NikolaNikolow/ORGOfly-CAD-model/P01/P01_07_DIANA/Videos and Pictures/Tilit_rotor_simulation.png

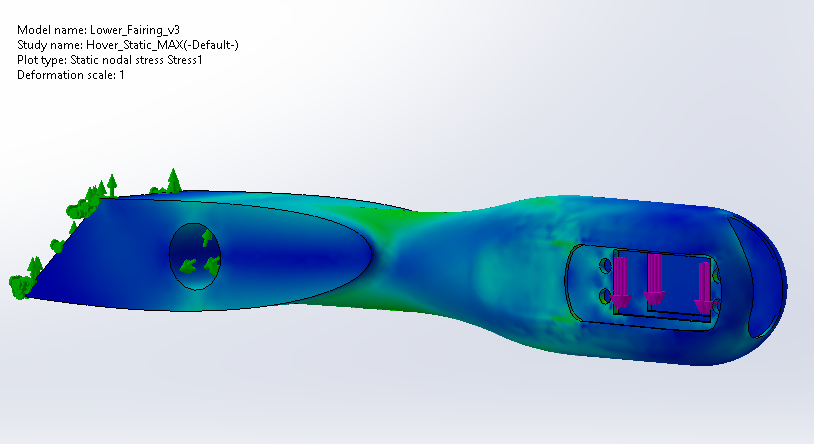
P01/P01_07_DIANA/Videos and Pictures/Tilit_rotor_simulation.png
