NikolaNikolow/ORGOfly-CAD-model/README.md

# ORGOfly-CAD-model
This will be a repo for designing the ORGOfly CAD model.
