NikolaNikolow/ORGOfly-CAD-model/Corporate/Roadmap_260813.pptx

## ORGOfly An airborne medical-logistics system

Roadmap

## Company Roadmap

L01 Large ORGOfly Aircraft program
Hybrid Propulsion System; Intercity

Q3 2028

L01 Commercial Operation

2029???

S01 Medical Logistics Demonstrator
based on P01; fully electric

Q2 2027

Pilot Medical Route
utilizing S01; only demonstration

Q3 2027

Initial ORGOfly service
2-3x S01;
commercial service

Q1 2028

Flight-test campaign
banner towing for gathering flight data and experience
Banner towing?

Q4 2026

P01 Technology Demonstrator
Development and building

Q3 2026

Q1

Q2

Q3

Q4

2026

Q1

Q2

Q3

Q4

2027

Q1

Q2

Q3

Q4

2028

Q1

Q2

Q3

Q4

2029

## ORGO Aircrafts

Two separate Aircraft Concepts:
- Small ORGOfly:
routine and urgent blood, plasma, samples and lightweight medical logistics
- Large ORGOfly:
long-range, higher-payload, extremely time-critical missions including organ transport
