NikolaNikolow/ORGOfly-CAD-model/P01/P01-20_Fuselage/P01-20-01_Skin/P01-20-01-01_260727_Top_Dimensions.png

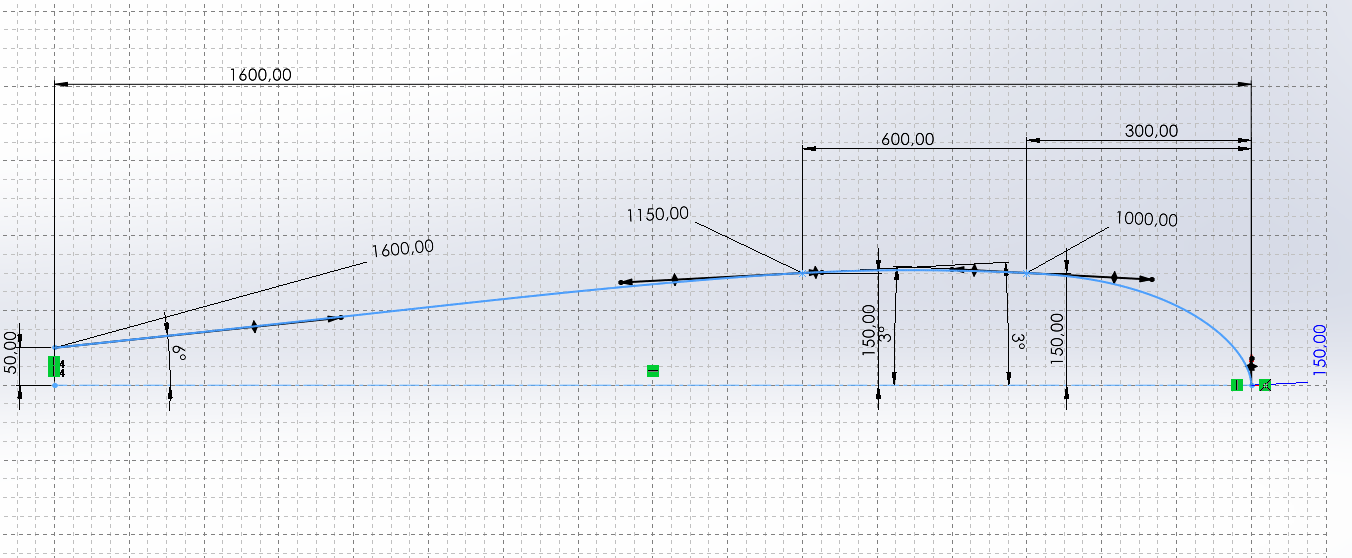
P01/P01-20_Fuselage/P01-20-01_Skin/P01-20-01-01_260727_Top_Dimensions.png
