NikolaNikolow/ORGOfly-CAD-model/P01/P01-80_Payload/P01-80-01_Payload_bay/MOSECYOU 6inch French Door Lock Schematic.png

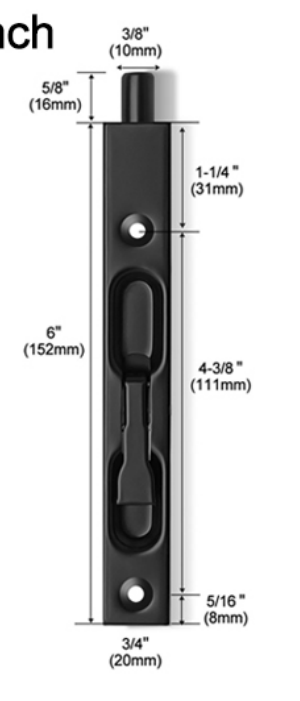
P01/P01-80_Payload/P01-80-01_Payload_bay/MOSECYOU 6inch French Door Lock Schematic.png
