NikolaNikolow/ORGOfly-CAD-model/P01/P01_05_Design/Flight_Control/Deflection of FL Surfaces/Aileron deflection sketch.png

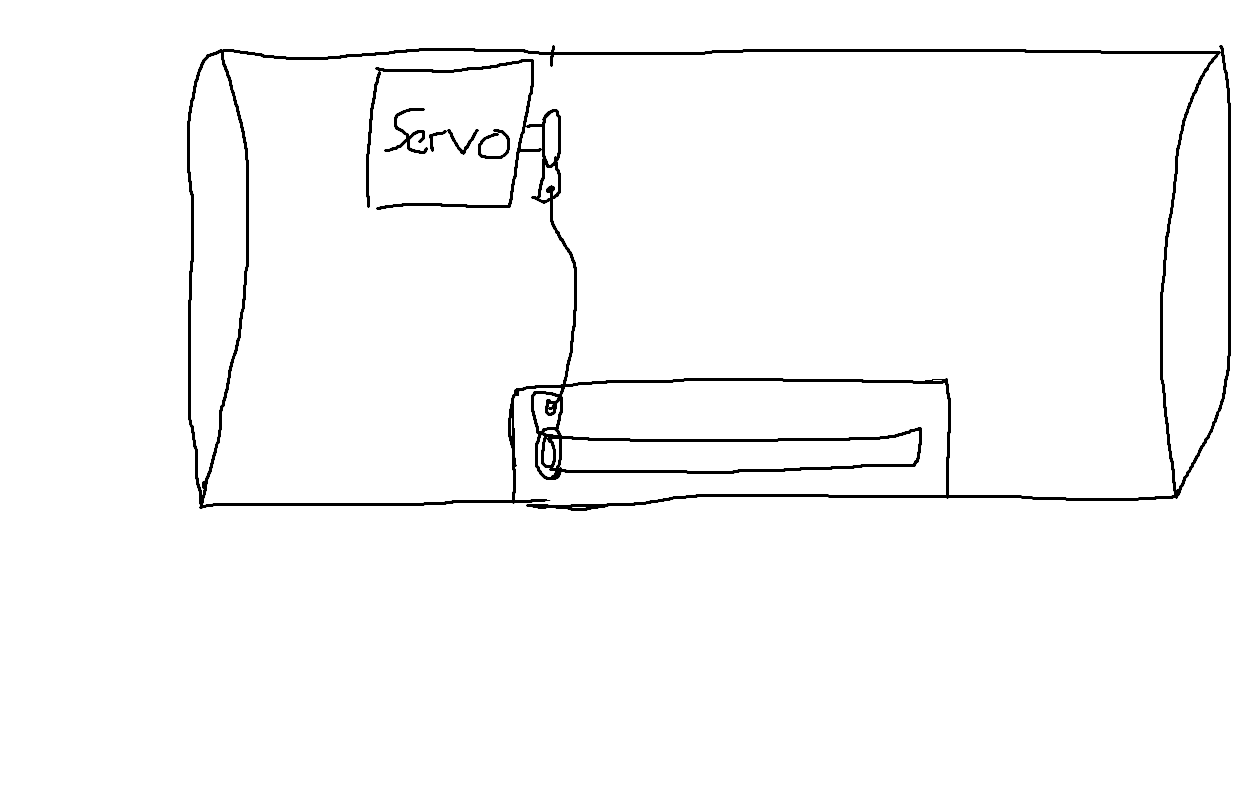
P01/P01_05_Design/Flight_Control/Deflection of FL Surfaces/Aileron deflection sketch.png
