NikolaNikolow/ORGOfly-CAD-model/P01/P01_06_Procurement/Invoices_MD_261028_22.00EUR/3aREtDz1.jpg

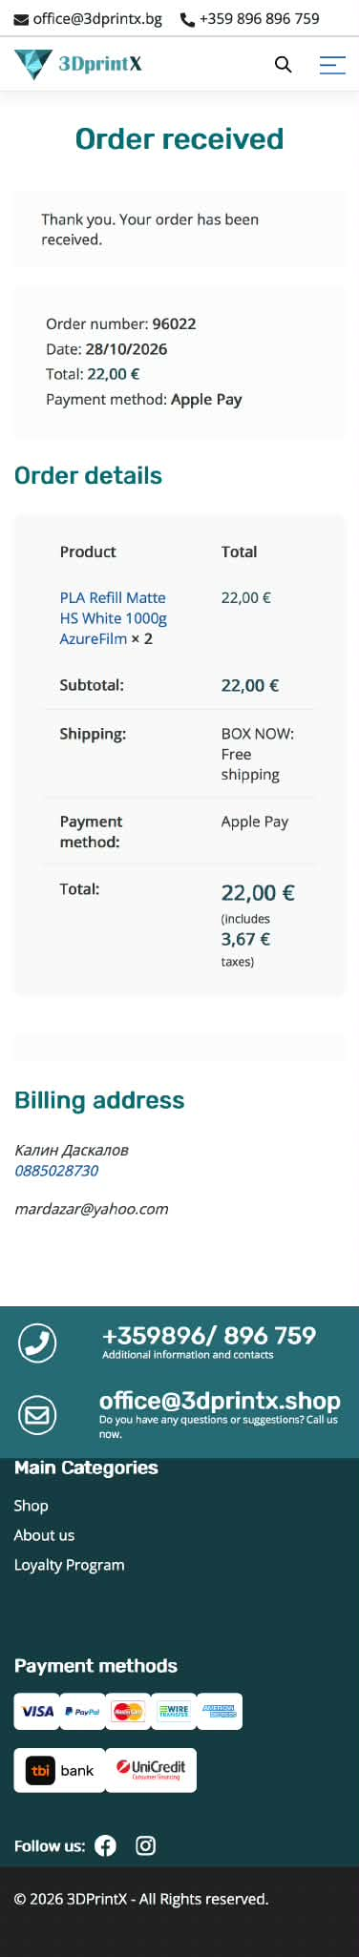
P01/P01_06_Procurement/Invoices_MD_261028_22.00EUR/3aREtDz1.jpg
