NikolaNikolow/ORGOfly-CAD-model/P01/P01_07_DIANA/Q2_26_DIANA_Application/Body of Orgofly.jpeg

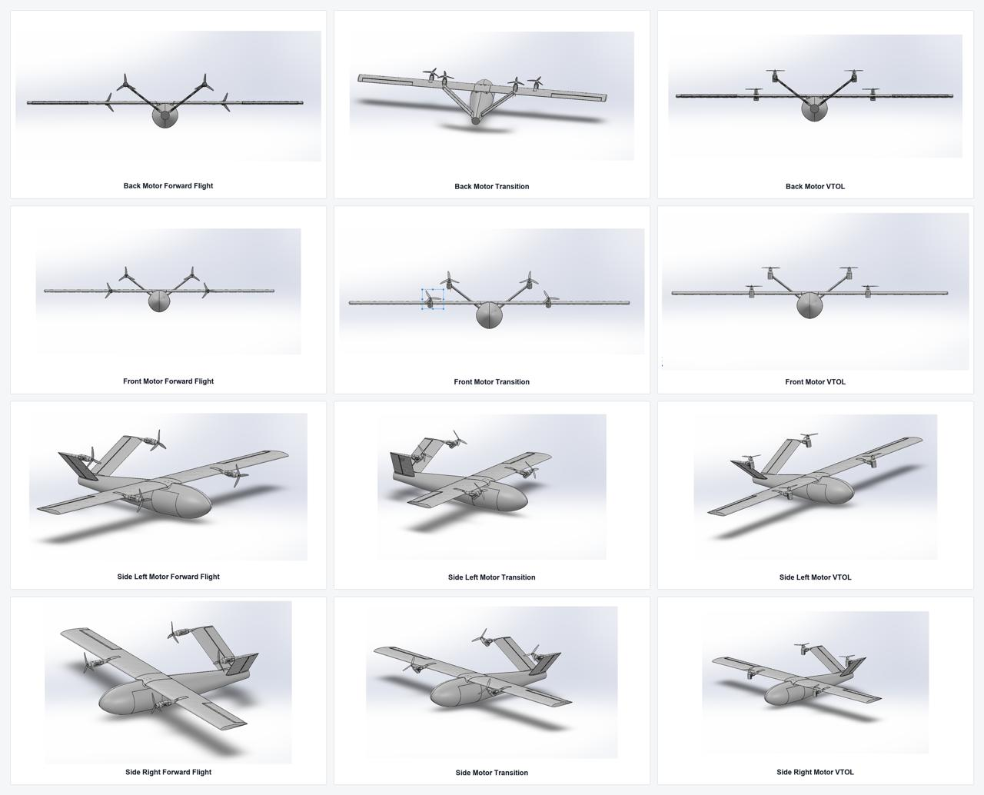
P01/P01_07_DIANA/Q2_26_DIANA_Application/Body of Orgofly.jpeg
