NikolaNikolow/ORGOfly-CAD-model/P01/P01_07_DIANA/Videos and Pictures/Back motor forward flight.png

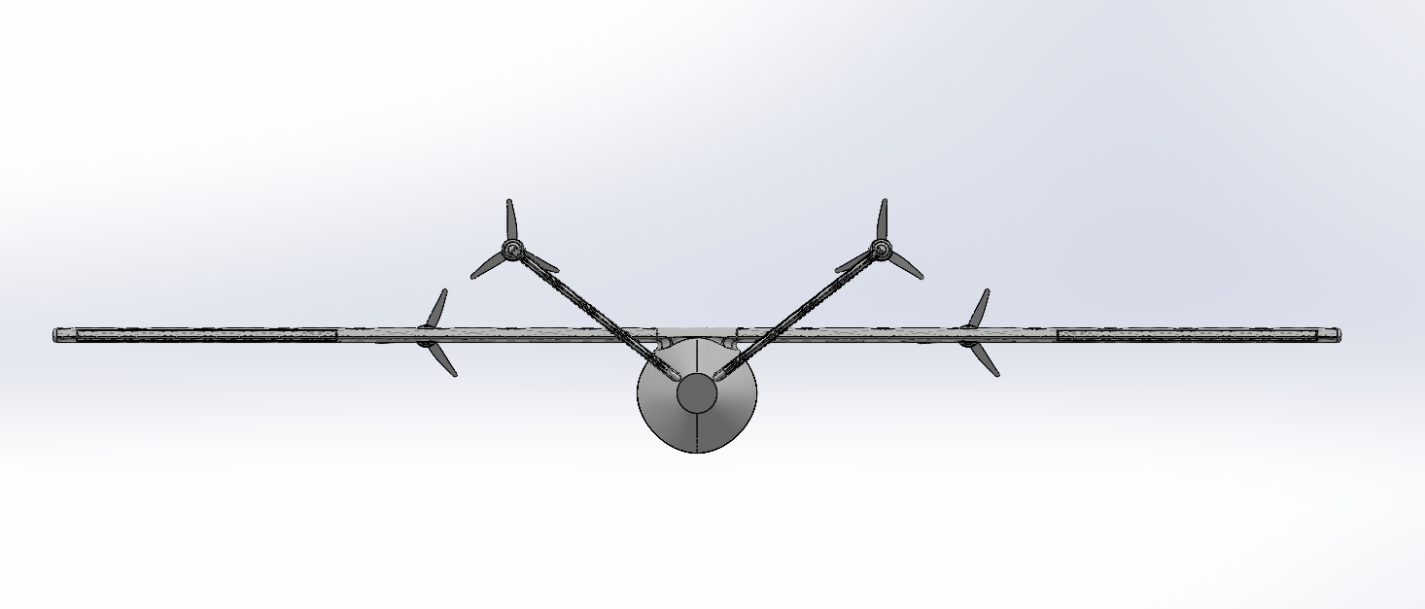
P01/P01_07_DIANA/Videos and Pictures/Back motor forward flight.png
