NikolaNikolow/ORGOfly-CAD-model/P01/P01_07_DIANA/Videos and Pictures/Fron motor transition.png

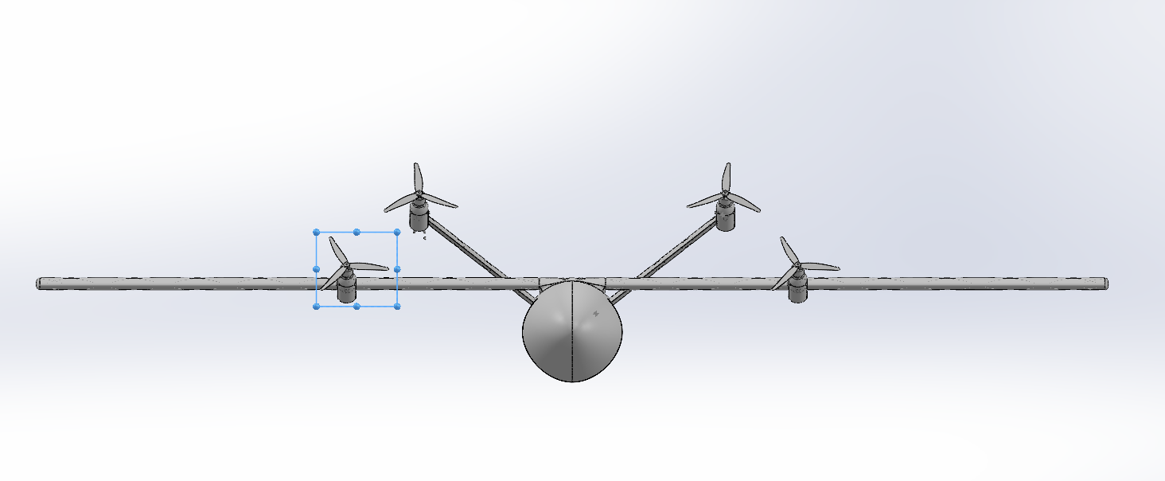
P01/P01_07_DIANA/Videos and Pictures/Fron motor transition.png
