NikolaNikolow/ORGOfly-CAD-model/P01/P01_07_DIANA/Videos and Pictures/KiCAD_electrical.png

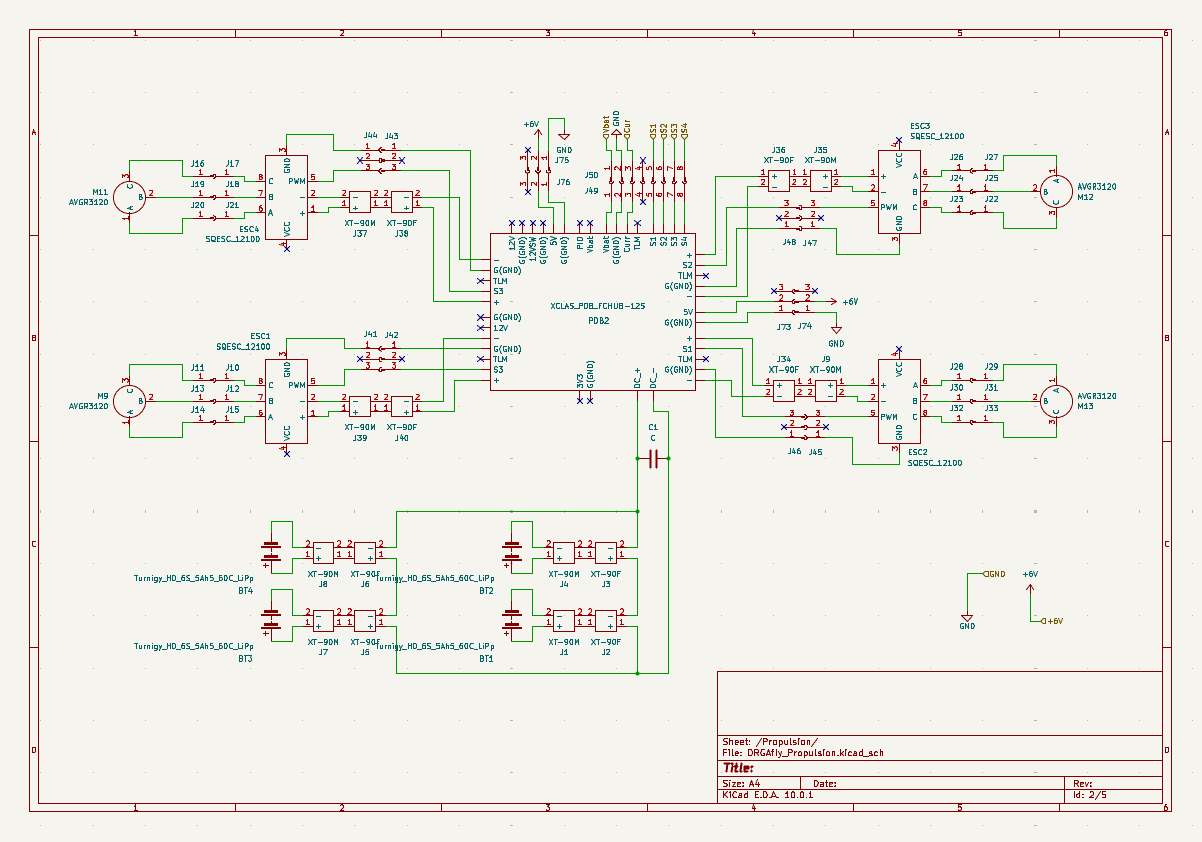
P01/P01_07_DIANA/Videos and Pictures/KiCAD_electrical.png
