NikolaNikolow/ORGOfly-CAD-model/P01/P01_07_DIANA/Videos and Pictures/KiCAD_electricalpng.png

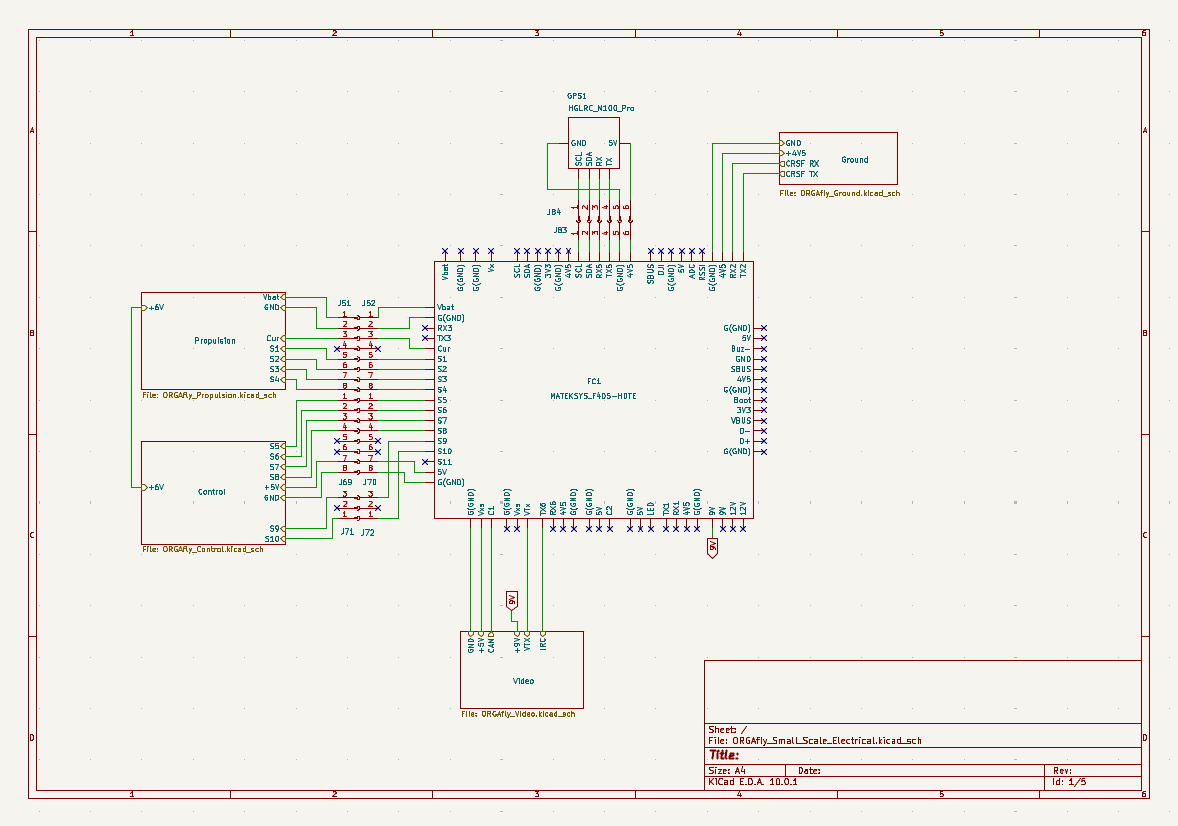
P01/P01_07_DIANA/Videos and Pictures/KiCAD_electricalpng.png
