NikolaNikolow/ORGOfly-CAD-model/P01/P01_07_DIANA/Videos and Pictures/Side left motor transition.png

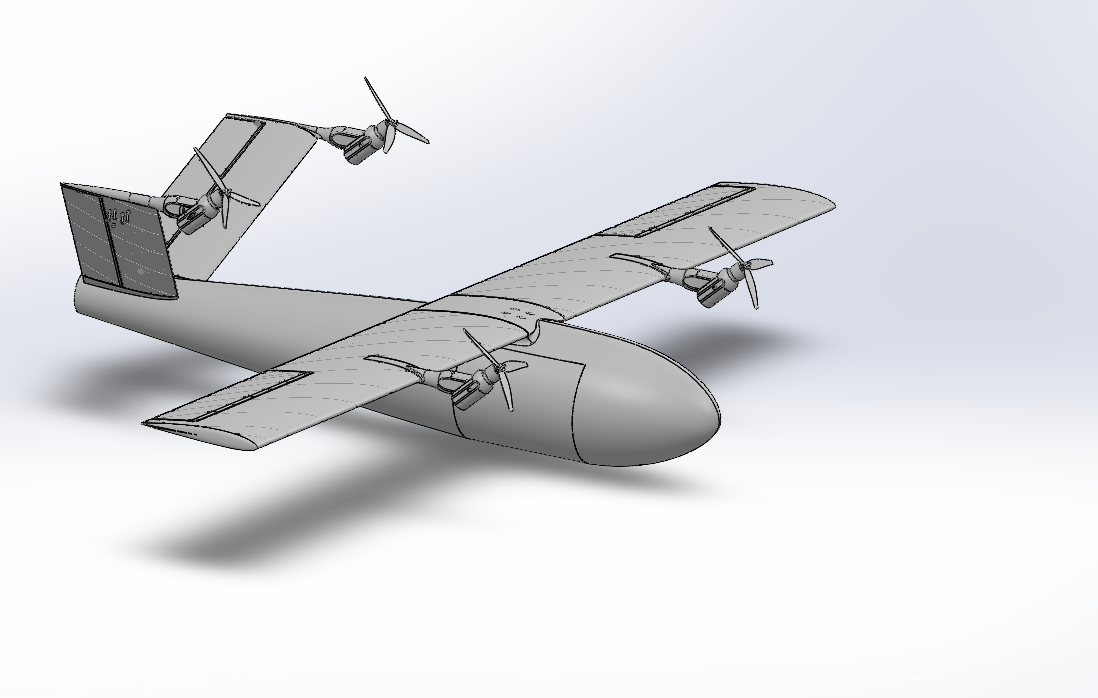
P01/P01_07_DIANA/Videos and Pictures/Side left motor transition.png
