NikolaNikolow/ORGOfly-CAD-model/P01/P01_06_Procurement/Table_260719_BOM.xlsx

Sheet: Main_Table
Please add components here only after selection process has been finished!
# | Item Name | Item Description | Subsystem | Price (€) | Delivery price (€) | Quantity | Unit | Supplier/Link | Total price (€) | Lead Time | Status | Notes | If rejected, specify why:
1 | Domain | OrgoFly Domain | Business |  | 0 | 1 | pcs |  | 0 | n/a | received
2 | PA6+CF filament | 500g | Manufacturing and prototyping | 46 | 0 | 1 | pcs | https://www.aliexpress.com/item/1005010143310151.html?curPageLogUid=HADK0WdyQEtP (https://3dprintx.bg/magazin/pa6-cf-with-spool-cherno-bambu-lab/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) | 46 | 6-12days | received | only for structural parts
3 | CF Tube 18x16mm | x600mm (2 tubes per pack) | Airframe and Structures | 12.8 | 5.16 | 1 | each | https://www.aliexpress.com/item/1005006436550237.html?mp=1 | 17.96 | 10-19days | received | around 550mm needed per side 2 tubes per pack
4 | CF Tube 20x18mm | x600mm (4 tubes per pack) | Airframe and Structures | 23.23 | 10.09 | 1 | each | https://www.aliexpress.com/item/1005006797742158.html?mp=1 | 33.32 | 10-20days | received | around 180mm needed for the center wing box around 550mm needed for each halfwing outbound 4tubes per pack
5 | CF Tube 22x20mm | x1000mm | Airframe and Structures | 31.22 | 18.75 | 4 | pcs | https://www.easycomposites.eu/6mm-woven-finish-carbon-fibre-tube | 143.63 | 2-6 days | ordered | full 1000mm length needed for each half-wing. 2x944mm needed for structure inside fuselage.
6 | CF Tube 6x4mm | x1000mm | Airframe and Structures | 12.83 |  | 2 | pcs | https://www.easycomposites.eu/22mm-woven-finish-carbon-fibre-tube | 25.66 | 2-6 days | ordered | around 820mm needed for each half-wing
7 | PLA lightweight filament | 1kg - White! | Manufacturing and prototyping | 30.43 | 8.64 | 2 | pcs | https://www.aliexpress.com/item/1005002433587874.html?curPageLogUid=4Gz3UoIpJ0b2 | 69.5 | 6-10days | received | Active foaming PLA-LW material. 2 rolls of 1kg will be initially ordered.
8 | Antenna | Antenna | Communications and Ground Equipment |  |  | 1 | pcs |  | 0 |  | rejected |  | XR4 dual band reciever planned
9 | Turnigy_HD_6S_5Ah5_60C_LiPo | Multiple-cell battery | Power | 60.75 | 0 | 4 | pcs | https://hobbyking.com/en_us/turnigy-heavy-duty-5500mah-6s-60c-lipo-pack-w-xt90.html | 243 | 4-7 days | rejected | Core propulsion system component | No EU Availability
10 | Ovonic Roam 6S 8Ah 150C | Multiple-cell battery | Power | 92 | 24.57 | 2 | pcs | https://www.ampow.com/products/ovonic-roam-series-6s-lipo-battery-8000mah-6s1p-150c-22-2v-lipo-battery-with-xt90-s-anti-spark-plug-for-dji-uav-drone-x-class-6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 | 208.57 | 5-9 days | pending | Core propulsion system component
11 | Ovonic Roam 6S 5Ah5 150C XT90-S | Multiple-cell battery | Power | 62.75 | 24.57 | 2 | pcs | https://www.ampow.com/products/ovonic-roam-series-6s-lipo-battery-5500mah-6s1p-150c-22-2v-long-range-lipo-battery-with-xt90-s-anti-spark-plug-for-6s-cinelifte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 | 150.07 | 5-9 days | rejected | Core propulsion system component | Lower density option available
12 | HQ 10 x 5 x 3 2 pairs | Propellers | Propulsion | 16.45 | 0 | 2 | pcs | https://www.aliexpress.com/item/1005009091133732.html | 32.9 | 6-10days | ordered | The ones we have test data for. Can change later
13 | 370 uF capacitor | Unpolarized capacitor | Power |  |  | 1 | pcs |  | 0 |  | pending
14 | Foxeer Mini Cat 4 1200TVL | FPV Camera | Flight Control and Avionics |  |  | 1 | pcs |  | 0 |  | pending
15 | SQESC_12100 | Electronic Speed Controller | Propulsion | 51.39 | 16.74 | 4 | pcs | https://www.aliexpress.com/item/1005006753480927.html?gatewayAdapt=deu2glo | 222.3 | 6-10 days | ordered | Can also be bought for 49.99USD with 12USD shipping from sequermall.com
16 | MATEKSYS_F405-HDTE 12 PWM | Flight Controller | Flight Control and Avionics | 63.99 | 0 | 1 | pcs | https://www.aliexpress.com/item/1005012792435664.html | 63.99 | 10-20 days | ordered | Order from the same place as RX and PDB for cheaper delivery
17 | Holybro Micro M10 GPS With IST8310 Digital Compass Ceramic Patch Antenna | GPS with Compass | Flight Control and Avionics |  |  | 1 | pcs | https://www.aliexpress.com/item/1005008932272456.html | 37.6 | 10-20 days | ordered
18 | Pack of 20 XT90 Battery Connectors (10 pairs) | Power connector | Fasteners and Consumables | 5.92 | 5.95 | 2 | pcs | https://www.aliexpress.com/item/1005003122596249.html?curPageLogUid=7PGL6jiPmM9H | 17.79 | 10-20 days | ordered | Sold in bulk. 8 pairs needed.
19 | 15 Pairs 4 mm Gold-Plated Banana Plugs | Power connector | Fasteners and Consumables | 7.04 | 0 | 1 | pcs | https://www.amazon.de/-/en/GTIWUNG-Gold-Plated-Banana-Electronic-Female/dp/B07VYSN74H | 7.04 | 6-10days | pending | Sold in bulk. 12 pieces needed
20 | 1.0 mm JST-SH connector kit | JST SH connectors with precrimped cables | Fasteners and Consumables | 14.81 | 0 | 1 | pcs | https://www.amazon.com/Teansic-Connector-Pre-Crimped-Housing-Controller/dp/B0D5X6BY5Z | 14.81 | 6-10days | pending | Sold in bulk
21 | 2.54 mm JST-XH connector kit | JST XH connectors | Fasteners and Consumables | 6.61 | 0 | 1 | pcs | https://www.amazon.com/Connector-Housing-Adapter-Terminal-Connectors/dp/B0BZDCGJ32 | 6.61 | 6-10days | pending | Sold in bulk
22 | JR connector kit | JR connectors with precrimped cables | Fasteners and Consumables | 8.66 | 0 | 1 | pcs | https://www.amazon.de/-/en/YIXISI-Connector-Crimping-Compatible-Spektrum/dp/B0FLJYYJ1X | 8.66 | 6-10days | pending
23 | KingMax DCS2016SP Servo | Budget Servo - 34kg option | Flight Control and Avionics | 20.09 | 15.25 | 8 | pcs | https://www.aliexpress.com/item/1005012071771092.html?curPageLogUid=cjkYWPn8Cvj3 | 175.97 | 11-23days | ordered | Shipping cost based on 8pcs
24 | KingMax S40S Servo | High-End Servo - 40kg option | Flight Control and Avionics | 86.99 | 2.17 | 8 | pcs | https://www.aliexpress.com/item/1005006904005995.html?curPageLogUid=lqFzD61nfosz | 698.09 | 10-20days | rejected | Shipping cost based on 8pcs | saved for next iterations, not needed for prototype phase
25 | Brotherhobby Avenger 3120 500KV 4pcs | Motor | Propulsion | 174.99 | 0 | 1 | pcs | https://www.aliexpress.com/item/1005003975746499.html?gatewayAdapt=deu2glo | 174.99 | 7-14 days | ordered | Sold in bulk. 4 500KV motors
26 | MATEKSYS XCLAS PDB FCHUB-12S | Power Distribution Board | Power | 31.9 | 8.47 | 1 | pcs | https://www.rotorama.de/product/matek-xclass-pdb-fchub-12s | 40.37 | 3-5 days | ordered | Delivery with ECONT. Cheaper delivery options available
27 | TBS Crossfire Diversity Nano Rx | TBS Crossfire Diversity Nano RX Receiver FPV Long Range | Communications and Ground Equipment | 53.49 | 0 | 1 | pcs | https://n-factory.de/TBS-Crossfire-Diversity-Nano-RX-Receiver-FPV-Long-Range_1 | 53.49 | 4-10 days | rejected | Available (fow now). We need to contact them separately for ordering | Not compatible with the newly selected transmitter
28 | ULTRA 25-1600mW 4.9-5.8G 64CH | Video Transmitter | Flight Control and Avionics |  |  | 1 | pcs |  | 0 |  | pending
29 | Servo to Shaft Coupler 25T, 5mm Bore | Servo to Shaft Coupler | Flight Control and Avionics | 6.99 |  | 4 | pcs | https://de.aliexpress.com/item/1005012043076003.html?curPageLogUid=b41WCP6q7Yv6 | 27.96 | 10-20 days | ordered
30 | D-Shaft 5x60mm | Shaft | Flight Control and Avionics | 7.19 |  | 2 | pcs | https://de.aliexpress.com/item/1005002809828245.html?curPageLogUid=bsg7dXE6wM3i | 14.38 |  | rejected |  | D-Shafts would be manually manufactured using 5mm aluminum rods
31 | D-Shaft 5x45mm | Shaft | Flight Control and Avionics | 7.19 |  | 2 | pcs | https://de.aliexpress.com/item/1005002809828245.html?curPageLogUid=bsg7dXE6wM3i | 14.38 |  | rejected |  | D-Shafts would be manually manufactured using 5mm aluminum rods
32 | Flanged Bearings 5x8x2.5mm | Bearing come at 10 pcs | Flight Control and Avionics | 4.89 |  | 1 | pcs | https://de.aliexpress.com/item/1005008084078658.html?curPageLogUid=w2a4Ew33IG5l | 4.89 | 10-20 days | ordered
33 | Radiomaster TX16s MK3 + XR4 Reciever | Тransmitter + reciever | Communications and Ground Equipment |  |  | 1 | pcs | https://www.ebay.co.uk/itm/278435436885 | 242.17 | 7-10 days | pending | transmitter + reciever (seller confirmed LBT - EU standard)
34 | RadioMaster 5000mAh 2S 7.4V Li-ion Battery | Transmitter battery | Communications and Ground Equipment |  |  | 1 | pcs | https://motionrc.com/eu/products/radiomaster-5000mah-2s-7-4v-li-ion-battery-with-xt30-connector-hp0157-batt-5a2s | 28.38 | 7-10 days | pending | best option for main battery for transmitter (sold separately)
35 | Ovonic Roam 6S 6Ah5 150C XT90-S | Multiple-cell battery | Power |  |  | 1 | pcs | https://www.ampow.com/products/ovonic-roam-series-6s-lipo-battery-6500mah-6s1p-150c-22-2v-long-range-lipo-battery-with-xt90-s-anti-spark-plug-for-x8-cinelifte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 | 264.17 | 7-10 days | pending | better density, cheaper per W, ability to swap 2 packs in tests

Sheet: Totals
 | pending | approved | ordered | received | rejected
TOTAL | 780.41 | 0 | 968.05 | 166.78 | 1173.41 | 3088.65
Airframe and Structures | 0 | 0 | 169.29 | 51.28 | 0
Propulsion | 0 | 0 | 430.19 | 0 | 0
Power | 472.74 | 0 | 40.37 | 0 | 393.07
Flight Control and Avionics | 0 | 0 | 310.41 | 0 | 726.85
Control Surfaces and Mechanisms | 0 | 0 | 0 | 0 | 0
Payload and Medical Transport System | 0 | 0 | 0 | 0 | 0
Communications and Ground Equipment | 270.55 | 0 | 0 | 0 | 53.49
Manufacturing and prototyping | 0 | 0 | 0 | 115.5 | 0
Fasteners and Consumables | 37.12 | 0 | 17.79 | 0 | 0
Testing and Safety Equipment | 0 | 0 | 0 | 0 | 0
Business | 0 | 0 | 0 | 0 | 0
Other | 0 | 0 | 0 | 0 | 0
