NikolaNikolow/ORGOfly-CAD-model/P01/P01-10_General/P01-10-01_Sys_Req/12S_VTOL_Electronics_Comparison_ChatGPT.xlsx

Sheet: FC
FC comparison
Prices are approximate retail snapshots discussed in the chat; verify availability, regional taxes, and shipping before purchase. 12S = 2x 6S LiPo in series: 44.4 V nominal, 50.4 V full.
Tier | Option | Manufacturer | Role / use | Firmware / protocol | Voltage / input | Outputs / current / key specs | 12S-system compatibility | Approx unit price EUR | Qty | Approx subtotal EUR | Advantages | Disadvantages / caveats | Source URL
Budget | SpeedyBee F405 Wing APP | SpeedyBee | Wing/VTOL FC | ArduPilot, INAV | PDB is 7-36V / 2-6S; use regulated rail in 12S | STM32F405; ~11-12 PWM; 6 UART; I2C; microSD; Bluetooth/app setup | Compatible only through 5V/regulated power; do not feed raw 12S to its PDB | €50.00 | 1 | €50.00 | Very cheap; good wing layout; easy app setup | F4 class; no CAN; not raw 12S | https://www.speedybee.com/speedybee-f405-wing-app-fixed-wing-flight-controller/
Budget | SpeedyBee F405 Wing Mini | SpeedyBee | Compact wing FC | ArduPilot, INAV | 2-6S PDB; use regulated power only | F405; smaller wing board; fewer rails than APP stack | 12S-compatible only via external regulator/BEC | €46.00 | 1 | €46.00 | Very cheap and compact | Less expansion and power margin | https://www.speedybee.com/speedybee-f405-wing-mini/
Budget | Matek F405-Wing V2 | Matek | Fixed-wing/VTOL FC | ArduPilot, INAV | 9-30V / 3-6S direct; use 12V regulated rail | STM32F405; 10 PWM; 6 UART; I2C; SD; servo rail 5A cont/6A peak | Good with FCHUB-12S 12V output; not raw 12S | €60.00 | 1 | €60.00 | Best cheap wing layout; widely used; supports airspeed/GPS/servos | F4 flash/headroom; limited for complex VTOL | https://www.mateksys.com/?portfolio=f405-wing-v2
Budget | Matek F405-HDTE | Matek | Compact FC / direct 12S shortcut | ArduPilot, INAV, Betaflight | 9-60V / 3-12S direct | STM32F405; 12 PWM; 6 UART; external current sensor; 5V 1.5A BEC | Direct raw 12S capable; still needs external servo power/current sensing | €50.00 | 1 | €50.00 | Cheapest direct-12S FC option we discussed | Less wing-oriented; no built-in current sensor; F4 class | https://www.mateksys.com/?portfolio=f405-hdte
Budget | ATOMRC F405 NAVI | ATOMRC | Budget wing FC | ArduPilot, INAV | 3-6S direct; use regulated rail | F405; 8 PWM class; GPS/compass friendly | 12S-compatible only via external regulator | €50.00 | 1 | €50.00 | Very cheap; fixed-wing oriented | Limited outputs for VTOL | https://atomrc.com/products/atomrc-fixed-wing-flight-controller-f405-navi
Budget | Holybro Kakute F405-Wing Mini | Holybro | Compact wing FC | ArduPilot, INAV, Betaflight | 2-8S direct; use regulated rail for 12S | STM32F405; 7 PWM; 5 UART; barometer; current sensing; small servo BEC | Works in 12S aircraft only behind PDB/BEC | €55.00 | 1 | €55.00 | Good brand; compact; verified firmware support | Only 7 PWM outputs; may be tight for VTOL | https://holybro.com/products/kakute-f405-wing-mini
Budget | MicoAir H743 V2 | MicoAir | Compact H7 autopilot | ArduPilot, PX4; INAV flashable/community | 2-6S direct; use regulated rail | STM32H743; compact board; not wing-specific | 12S-compatible only through external regulator | €55.00 | 1 | €55.00 | Cheap H7 compute | Not ideal wing/servo layout | https://store.micoair.com/product/micoair743/
Budget | Sequre H743 V2 | Sequre | Compact H7 multirotor FC | ArduPilot, INAV, Betaflight | 4-8S direct; use regulated rail | H743; 6 UART; 9 PWM class; multirotor layout | Works with 12S only via regulator; not wing-optimized | €65.00 | 1 | €65.00 | Cheap H7 board | Servo/wiring layout less convenient | https://ardupilot.org/copter/docs/common-sequreh743.html
Medium | Matek H7A3-SLIM | Matek | Compact H7 FC | ArduPilot | 6-36V / 2-8S direct; use regulated rail | H7A3; 11 PWM; 6 UART; CAN; blackbox; no current sensor | Good with 12S PDB/BEC; not raw 12S | €69.00 | 1 | €69.00 | Excellent value H7 for ArduPilot | Less wing-specific than H7A3-WING | https://www.mateksys.com/?portfolio=h7a3-slim-2
Medium | TBS Lucid H7 Wing | TBS | Wing/VTOL FC | ArduPilot; INAV target/check before buying | 8-50.4V / 3-12S direct | STM32H743; 13 PWM; 7 UART; 2 I2C; CAN; 5/6/8.4V servo BEC 8A cont/10A peak | Excellent direct 12S budget option | €80.00 | 1 | €80.00 | Direct 12S; H7; strong servo BEC; great budget architecture | INAV status less clear than ArduPilot | https://www.rotorama.com/product/tbs-lucid-h7-wing
Medium | iFlight BLITZ Wing H743 | iFlight | Wing/VTOL FC | ArduPilot, INAV, Betaflight | 2-8S direct; use regulated rail for 12S | STM32H743; 13 PWM; 7 UART; 2 I2C; CAN; 5/7.4/8.4V 6A servo BEC | Good with 12S PDB/BEC; not raw 12S | €89.00 | 1 | €89.00 | H7 wing board under €100; good I/O | Servo BEC weaker than TBS Lucid; no raw 12S | https://ardupilot.org/copter/docs/common-blitzh743wing.html
Medium | Matek H743-SLIM V4 | Matek | Compact H7 FC | ArduPilot, INAV, Betaflight | 6-36V / 2-8S direct; VBAT2 senses up to 69V | STM32H743; dual IMU; 13 PWM; 7 UART; 2 I2C; CAN; microSD | Excellent if powered from regulated rail; use external current/servo power | €95.00 | 1 | €95.00 | Best Matek compute/headroom under €100 | No built-in current sensor; not raw 12S | https://www.rotorama.com/product/matek-h743-slim-v4
Medium | Matek H743-Mini V3 | Matek | Compact H7 FC | ArduPilot, INAV, Betaflight | 6.3-36V / 2-8S; use regulated rail | H743; 11 PWM; UARTs; CAN; VB2 voltage sense up to 69V | Good with PDB/BEC; not raw 12S | €80.00 | 1 | €80.00 | Compact H7 | Less convenient for wing/servos than H743-SLIM/Wing boards | https://www.mateksys.com/?portfolio=h743-mini
Medium | AET H743 Basic | AET | H7 autopilot board | ArduPilot | Usually 2-6S class; use regulated rail | H743; compact autopilot | 12S via external regulator only | €95.00 | 1 | €95.00 | H7 under €100 | Less common; support/ecosystem not as broad | https://ardupilot.org/copter/docs/common-autopilots.html
Medium | Holybro Kakute H743-Wing | Holybro | Wing/VTOL FC | ArduPilot, INAV | 10-36V / 3-8S direct; use regulated rail for 12S | STM32H743; 14 PWM; 7 UART; CAN; I2C; current sensor; 5V, 6/8V, 9/12V BECs | Very good with regulated PDB; not raw 12S | €100.00 | 1 | €100.00 | Excellent wing/VTOL layout; both ArduPilot and INAV | Often above €100 in EU; current sensor not for whole VTOL bus | https://holybro.com/products/kakute-h743-wing
Above medium | Matek H7A3-WING | Matek | Wing/VTOL FC | ArduPilot | 9-30V / 3-6S; use 12V regulated rail | 11 PWM; 6 UART; CAN; strong Vx servo rail 8A cont/12A peak | Excellent with FCHUB/PM12S; not raw 12S | €130.00 | 1 | €130.00 | Best Matek wing/VTOL layout | Above €100 and not direct 12S | https://www.mateksys.com/?portfolio=h7a3-wing
Above medium | Holybro Pixhawk 6C | Holybro | Pixhawk autopilot | ArduPilot, PX4 | Regulated 4.9-5.5V power input | Pixhawk class; 16 PWM; CAN; redundant sensors lower than 6X | Very good with 12S power module/PMU | €160.00 | 1 | €160.00 | Cheapest serious Pixhawk-class choice | Needs PMU; more wiring/cost than small FC | https://docs.holybro.com/autopilot/pixhawk-6c/technical-specification
Expensive | Holybro Pixhawk 6X | Holybro | Serious VTOL/autopilot | ArduPilot, PX4 | Regulated 4.9-5.5V power input | STM32H753; 16 PWM; 2 CAN; 2 GPS; redundant IMUs/barometers | Excellent with 12S power module/PMU | €485.00 | 1 | €485.00 | Mature, robust, expandable | Expensive; may exceed your needs | https://docs.holybro.com/autopilot/pixhawk-6x/technical-specification
Expensive | Cube Orange+ | CubePilot | Premium ArduPilot/PX4 autopilot | ArduPilot, PX4 | Regulated low-voltage carrier-board power | H757 class; 14 PWM; 5 serial; 2 CAN; triple IMU ecosystem | Excellent with PM08-CAN/Mauch/CUAV PMU | €500.00 | 1 | €500.00 | Very proven for VTOL/autonomy | Cost and integration complexity | https://docs.cubepilot.org/user-guides/autopilot/the-cube/introduction/specifications
Expensive | CUAV Pixhawk V6X V2 | CUAV | Pixhawk-class autopilot | ArduPilot, PX4 | FC via PMU; PMU 2 Lite supports high-voltage bus | STM32H753; 16 PWM; 2 CAN; Ethernet; multiple GPS/telemetry ports | Excellent with CUAV PMU 2 Lite on 12S | €400.00 | 1 | €400.00 | Strong non-Holybro alternative | Higher cost than budget FCs | https://store.cuav.net/shop/pixhawk-v6x-v2-controller/
Expensive | CUAV Nora+ / Nora | CUAV | Compact serious autopilot | ArduPilot, PX4 | Regulated low voltage; uses CAN PMU Lite / PMU | 14 PWM; 2 CAN; dual power; robust sensors | Good 12S via PMU | €300.00 | 1 | €300.00 | Compact but serious autopilot | Less cheap; CUAV ecosystem | https://ardupilot.org/copter/docs/common-cuav-nora-overview.html
Expensive | CUAV X25 EVO | CUAV | Industrial autopilot | ArduPilot, PX4 | Uses PMU 2 Lite; PMU input 20-70V | 16 PWM; multiple CAN; Ethernet; richer interface set | Excellent 12S system if budget allows | €600.00 | 1 | €600.00 | Industrial interfaces and power architecture | Too expensive for budget build | https://store.cuav.net/shop/x25-evo-controller/
Expensive | mRo/3DR Control Zero Classic | mRo / 3DR | Modular H7 autopilot | ArduPilot, PX4 depending variant | Regulated low-voltage input / carrier-dependent | STM32H743; 12 PWM; 2 CAN; 5 UART | Works in 12S with proper PMU | €250.00 | 1 | €250.00 | Current H7 modular option | More custom integration | https://docs.3dr.com/
Expensive | 3DR Control N1 | 3DR | Compact H7 controller | ArduPilot; PX4 alpha per docs | Regulated input | STM32H743; 12 PWM; 7 serial; 2 FD-CAN | Works with 12S only through PMU | €250.00 | 1 | €250.00 | Modern compact H7 | PX4 alpha; less conservative | https://docs.3dr.com/
Expensive | mRo Pixracer Pro | mRo / 3DR | Compact autopilot | ArduPilot/PX4 class | Regulated input | H743; 8 PWM; 2 CAN; 6 UART | 12S via PMU; may lack outputs for complex VTOL | €250.00 | 1 | €250.00 | Small, capable | Only 8 PWM; not ideal for actuator-heavy VTOL | https://docs.3dr.com/

Sheet: ESC
ESC comparison
Prices are approximate retail snapshots discussed in the chat; verify availability, regional taxes, and shipping before purchase. 12S = 2x 6S LiPo in series: 44.4 V nominal, 50.4 V full.
Tier | Option | Manufacturer | Role / use | Firmware / protocol | Voltage / input | Outputs / current / key specs | 12S-system compatibility | Approx unit price EUR | Qty | Approx subtotal EUR | Advantages | Disadvantages / caveats | Source URL
Budget | Flycolor X-Cross HV3 60A | Flycolor | Lift ESC only if measured current is low | BLHeli_32; DShot/PWM/Proshot | 5-12S | 60A continuous class; single ESC; telemetry | Voltage OK; current may be too low for Avenger 3120 unless prop is derated | €43.00 | 4 | €172.00 | Cheapest true 12S ESC mentioned | Only use after bench current testing | https://www.flyingtech.co.uk/product/flycolor-x-cross-hv-5-12s-blheli32-esc-60-80-120-160a/
Budget | Flycolor X-Cross HV3 80A | Flycolor | Budget 12S lift ESC | BLHeli_32; DShot/PWM/Proshot | 5-12S | 80A; aluminum heatsinks; protections; telemetry | Good budget match if motor current stays <= FCHUB 70A continuous path | €60.00 | 4 | €240.00 | Best low-cost 80A 12S option | Lower confidence than Hobbywing/T-Motor; cooling/bench test required | https://www.drone-fpv-racer.com/en/x-cross-hv3-pro-80a-5-12s-by-flycolor-12950.html
Budget | Sequre 12100 100A | Sequre | Budget high-headroom ESC | AM32 or BLHeli_32; DShot/PWM/OneShot/MultiShot; telemetry | 5-12S / 18-50.4V | 100A continuous; 180A peak; STM32G071; heatsinks both sides | Voltage OK; good ESC headroom but FCHUB path remains 70A/channel continuous | €55.00 | 4 | €220.00 | Best budget-with-headroom option | Bench-test reliability and temperature carefully | https://www.rotorama.com/product/sequre-12100-5-12s-am32
Budget | DarwinFPV Cement 12S 80A | DarwinFPV | Waterproof budget ESC | BLHeli_32 / AM32 variants; DShot/MultiShot/OneShot | 4-12S | 80A continuous; 100A peak; potted/IP67 marketed | Voltage/current fit; test before trusting for VTOL | €68.00 | 4 | €272.00 | Waterproof/potted; budget 80A | Less proven than industrial UAV ESCs | https://darwinfpv.com/products/darwinfpv-cement-ultra-durable-blheli_32-12s-80a-waterproof-esc
Medium | Hobbywing XRotor Pro H80A HV V3 | Hobbywing | Reliable 12S/14S lift ESC | PWM/CAN depending version; industrial logging/diagnostics | 6-14S | 80A continuous class; UAV/industrial orientation | Very good 12S choice | €83.00 | 4 | €332.00 | More reliable brand; wide voltage margin | Still not ultra-cheap; details vary by version | https://www.hobbywing.com/en/products/-xrotorh80a14sbldc
Medium | T-Motor FLAME 80A 12S V2 | T-Motor | Known UAV lift ESC | Square-wave UAV ESC; PWM; 600Hz-class | 6-12S | 80A continuous; 120A peak 10s; IP56; aluminum case; protections | Very good with 12S; keep PDB current limits in mind | €103.00 | 4 | €412.00 | Known/proven UAV ESC | Cost x4 is high | https://store.tmotor.com/product/flame-80a-12s-v2-esc.html
Above medium | T-Motor Alpha 80A HV | T-Motor | Premium FOC lift ESC | FOC/vector control; T-Motor tooling | 6-12S | 80A class; lower noise/temperature behavior | Excellent for 12S VTOL | €120.00 | 4 | €480.00 | Smooth FOC behavior; premium reliability | Costly; same 80A class | https://store.tmotor.com/product/alpha-80a-12s-esc.html
Above medium | Flycolor X-Cross HV3 120A | Flycolor | Value headroom ESC | BLHeli_32 | 5-12S | 120A class; single ESC | Voltage OK; current exceeds FCHUB continuous path unless bypassed/derated | €105.00 | 4 | €420.00 | Big headroom for money | PDB bottleneck and cooling; only useful if distribution upgraded | https://www.flyingtech.co.uk/product/flycolor-x-cross-hv-5-12s-blheli32-esc-60-80-120-160a/
Expensive | T-Motor Alpha 120A 12S | T-Motor | Heavy-duty premium ESC | FOC/vector control | 12S class | 120A continuous class | Works electrically; overkill unless current data justifies it | €160.00 | 4 | €640.00 | High margin | Too expensive for current budget; PDB bottleneck | https://store.tmotor.com/product/alpha-120a-12s-esc.html
Expensive | APD 200F3 | APD | Extreme high-power ESC | APD firmware / high-rate protocols | Up to 14S / 60V | 200A class; peak power very high | Electrically compatible; far beyond budget and likely overkill | €300.00 | 4 | €1200.00 | Maximum margin/performance | Very expensive; needs serious distribution/cooling | https://powerdrives.net/200f3
Expensive | Lumenier Elite Pro 100A 6-12S 4-in-1 | Lumenier | Compact 4-in-1 ESC | AM32; DShot/OneShot/MultiShot/PWM; telemetry | 6-12S | 100A continuous / 120A peak per channel | Works for compact centralized quad core; not ideal for distributed wing VTOL | €520.00 | 1 | €520.00 | Clean packaging | Single point of failure; expensive | https://www.lumenier.com/products/lumenier-elite-pro-100a-v2-1-6-12s-4-in-1-am32-esc-30x30
Not suitable | T-Motor FLAME 70A 6S | T-Motor | Earlier 6S option | UAV ESC | 4-6S | 70A continuous / 80A peak | Not suitable for current raw 12S propulsion bus | €60.00 | 4 | €240.00 | Good for 6S designs | Not 12S-compatible | https://uav-en.tmotor.com/Multirotor/ESC/flame/
Not suitable | T-Motor Alpha 60A 6S | T-Motor | Earlier 6S option | FOC | 4-6S | 60A class | Not suitable for current raw 12S propulsion bus | €70.00 | 4 | €280.00 | Smooth 6S FOC | Not 12S-compatible | https://store.tmotor.com/product/alpha-60a-6s-esc.html

Sheet: Power_PDB
Power_PDB comparison
Prices are approximate retail snapshots discussed in the chat; verify availability, regional taxes, and shipping before purchase. 12S = 2x 6S LiPo in series: 44.4 V nominal, 50.4 V full.
Tier | Option | Manufacturer | Role / use | Firmware / protocol | Voltage / input | Outputs / current / key specs | 12S-system compatibility | Approx unit price EUR | Qty | Approx subtotal EUR | Advantages | Disadvantages / caveats | Source URL
Budget | Matek FCHUB-12S V2 | Matek | 4-ESC PDB + 5V/12V regulators + current sensor | Analog voltage/current to FC; BLHeli telemetry pads | 8-60V / 3-12S | PDB 4x70A continuous, 4x110A burst; 440A current sensor; 5V 5A; 12V 4A | Good budget PDB if each ESC path stays <=70A continuous | €25.00 | 1 | €25.00 | Cheap; direct 12S; integrates power rails and current sensing | Current path is bottleneck for >70A/channel; not servo BEC | https://www.mateksys.com/?portfolio=fchub-12s
Budget | Holybro PM02D 12S HV | Holybro | Pixhawk power module / avionics supply | I2C voltage/current monitor | 2-12S | 5.2V 3A; PCB 60A continuous / 100A burst; max current sensing 327A | Good for FC power, not main propulsion distribution | €45.00 | 1 | €45.00 | Cheap Pixhawk power module | Do not run all lift ESC current through it | https://holybro.com/products/pm02d-power-module
Medium | Matek CAN-L4-BM | Matek | DroneCAN battery monitor | DroneCAN / AP_Periph | 0-85V | 150A continuous path; 204.8A burst; digital telemetry | Good for ArduPilot CAN systems; not enough for full 4x high-current bus if >150A | €32.00 | 1 | €32.00 | Accurate digital monitoring; low cost | Monitor only; not high-current PDB or servo rail | https://www.mateksys.com/?portfolio=can-l4-bm
Medium | Matek PM12S-3 | Matek | 12S power module / power hub | Analog power module | 9-55V | 5V 4A; 12V 4A; Vx 5.25/6/8V 15A continuous / 25A peak | Excellent 12S support module, especially for servo rail | €60.00 | 1 | €60.00 | Combines avionics and servo power | Not a main 4x ESC distribution board by itself | https://www.mateksys.com/?portfolio=pm12s-3
Above medium | CUAV PMU 2 Lite | CUAV | High-voltage PMU / current monitor | CAN communication | 20-70V | 220A current detection; ±0.1A / ±0.05V measurement claimed | Very good for CUAV/Pixhawk 12S architecture | €100.00 | 1 | €100.00 | Natural 12S PMU for CUAV systems | Best with CUAV ecosystem; continuous current details require review | https://www.cuav.net/en/pmu-2-lite-en/
Above medium | Holybro PM08-CAN | Holybro | High-current DroneCAN power module | DroneCAN | 7-60.9V / 2-14S | 200A continuous; 400A burst 1s; max current sensing 376A; 5.3V/3A outputs | Excellent for 12S Pixhawk/Cube/ArduPilot | €100.00 | 1 | €100.00 | Best high-current off-the-shelf monitor discussed | More expensive than FCHUB; not a 4-ESC PDB layout | https://holybro.com/products/dronecan-pm08-power-module-14s-200a
Expensive | Mauch power module system | Mauch | Premium Pixhawk/Cube power monitoring | Analog / Pixhawk power inputs | Sensor boards up to ~85V depending model | 50A / 100A / 200A sensor classes; clean 5.35V supply options | Excellent professional 12S option | €150.00 | 1 | €150.00 | Very reliable reputation in ArduPilot builds | Not cheap; requires selecting sensor+BEC combo | https://ardupilot.org/copter/docs/common-mauch-power-modules.html
Special | Matek HCS-150A | Matek | Analog Hall-effect current sensor | Analog current/voltage to FC | 0-69V | 150A continuous hall sensor | Works with 12S, but may be low for full propulsion current | €25.00 | 1 | €25.00 | Cheap, low loss | Not a full PDB; current margin limited | https://www.mateksys.com/?portfolio=hcs-150a

Sheet: BEC_ServoPower
BEC_ServoPower comparison
Prices are approximate retail snapshots discussed in the chat; verify availability, regional taxes, and shipping before purchase. 12S = 2x 6S LiPo in series: 44.4 V nominal, 50.4 V full.
Tier | Option | Manufacturer | Role / use | Firmware / protocol | Voltage / input | Outputs / current / key specs | 12S-system compatibility | Approx unit price EUR | Qty | Approx subtotal EUR | Advantages | Disadvantages / caveats | Source URL
Budget | Matek BEC 12S | Matek | Small accessory BEC | None | 6-60V input | Selectable 5V/9V/12V; low-current accessory rail | Direct 12S OK; not for heavy servos | €13.00 | 1 | €13.00 | Very cheap; good for small loads | Not a heavy servo supply | https://n-factory.de/Matek-BEC-12s-6-60V-to-5-9-12V
Budget | Matek BEC12S-PRO | Matek | Accessory/light-servo BEC | None | 9-55V | Selectable 5.2/8/12V; 5A continuous / 9A peak | Direct 12S OK; light/moderate loads | €22.00 | 1 | €22.00 | Good budget regulated rail | Too small for multiple high-torque tilt servos | https://www.mateksys.com/?portfolio=bec12s-pro
Budget | Matek SVPDB-12S | Matek | Servo PDB / servo BEC | None | 9-55V | 5/6/8V; 12A continuous / 20A burst; 10 PWM pass-through outputs | Good budget servo rail for 12S | €30.00 | 1 | €30.00 | Much better than small BEC for servos | No reverse-polarity protection; still limited for extreme tilt loads | https://www.mateksys.com/?portfolio=svpdb-12s
Medium | Hobbywing UBEC 10A HV | Hobbywing | Servo/accessory BEC | None | 3-14S | 6.0/7.4/8.4V adjustable; 10A continuous / 25A peak | Direct 12S OK; good for V-tail/moderate servos | €35.00 | 1 | €35.00 | Good non-Matek budget servo BEC | May be small for dual tilt servos | https://www.hobbywing.com/en/products/ubec-10a-hv289
Above medium | Castle CC BEC Pro | Castle Creations | Heavy servo BEC | Castle Link adjustable | Up to 12S / 50.4V | 20A peak; adjustable 4.8-12.5V; 48V continuous current around 8A according to retailer tables | Direct 12S OK; good for high-torque servos | €65.00 | 1 | €65.00 | Proven for large airplanes/multi-servo systems | Continuous rating derates at high input voltage; airflow needed | https://www.castlecreations.com/en/cc-bec-pro-010-0004-01
Above medium | Hobbywing UBEC 25A HV | Hobbywing | Strong servo BEC | None | 3-18S | 5.2/6.0/7.4/8.4V adjustable; 25A continuous / 50A peak | Excellent for 12S and tilt/servo systems | €70.00 | 1 | €70.00 | Very strong servo power; wide voltage | Larger/heavier/more expensive | https://www.hobbywing.com/en/products/ubec-25a-hv95
Expensive | Matek PM20S-2 | Matek | High-voltage dual BEC power module | None | 9-85V | Two independent BECs, each 15A continuous / 22A peak; 5.3/6.1/8.1/12.2V options | Very strong 12S servo/avionics power hub | €65.00 | 1 | €65.00 | Strongest integrated Matek rail discussed | More complex than needed for simple V-tail | https://www.mateksys.com/?portfolio=pm20s-2

Sheet: GPS_Compass
GPS_Compass comparison
Prices are approximate retail snapshots discussed in the chat; verify availability, regional taxes, and shipping before purchase. 12S = 2x 6S LiPo in series: 44.4 V nominal, 50.4 V full.
Tier | Option | Manufacturer | Role / use | Firmware / protocol | Voltage / input | Outputs / current / key specs | 12S-system compatibility | Approx unit price EUR | Qty | Approx subtotal EUR | Advantages | Disadvantages / caveats | Source URL
Budget | Beitian BN-880 | Beitian | GPS + compass | UART GNSS + I2C compass; ArduPilot/INAV | 5V regulated | u-blox M8N class; HMC5883L compass; GPS/GLONASS/Galileo/BeiDou/QZSS/SBAS | Works in 12S aircraft through 5V rail | €20.00 | 1 | €20.00 | Cheapest working GPS/compass | Quality control and compass consistency lower than premium | https://ardupilot.org/sub/docs/common-beitian-gps.html
Budget | Matek M10Q-5883 | Matek | GPS + compass | UART + I2C | 4-9V regulated | u-blox M10; GPS/GLONASS/Galileo/BeiDou; QMC5883L compass | Works through 5V rail | €47.00 | 1 | €47.00 | Good value M10 GNSS | EOL/availability issue | https://www.mateksys.com/?portfolio=m10q-5883
Medium | Holybro M10 GPS | Holybro | GPS + compass + buzzer/safety switch module | UART GNSS + I2C compass | 5V regulated | u-blox M10; multi-constellation; compass, LED, buzzer, safety switch in standard modules | Good with Pixhawk/ArduPilot/INAV | €70.00 | 1 | €70.00 | Better package than BN-880 | More expensive | https://holybro.com/products/m10-gps
Medium | Holybro M9N GPS | Holybro | GPS + compass | UART GNSS + compass | 5V regulated | u-blox M9N; IST8310 compass; LED/safety switch variants | Good with Pixhawk/Cube | €90.00 | 1 | €90.00 | Mature Pixhawk-friendly GPS | Not RTK; pricier than budget modules | https://docs.holybro.com/gps-and-rtk-system/m8n-m9n-m10-gps/standard-m10-m9n-m8n-gps/overview
Above medium | Holybro DroneCAN M9N/M10 GPS | Holybro | CAN GPS + compass | DroneCAN | Regulated CAN power | CAN-based GNSS/compass; reduces UART use and EMI issues | Best with ArduPilot Pixhawk/Cube/CUAV CAN | €120.00 | 1 | €120.00 | Cleaner wiring; better for serious UAV | More expensive; requires CAN setup | https://docs.holybro.com/gps-and-rtk-system/m8n-m9n-m10-gps/dronecan-m9n-m8n/overview
Expensive | Here3+ | CubePilot | DroneCAN GPS; RTK-ready ecosystem | DroneCAN/AP_Periph | Regulated CAN power | CAN GNSS; premium Cube ecosystem; RTK-ready | Excellent with Cube/Pixhawk ArduPilot | €250.00 | 1 | €250.00 | Reliable navigation ecosystem | Big price jump | https://docs.cubepilot.org/user-guides/here-3/here-3-manual
Expensive | Here4 | CubePilot | Premium multiband RTK GNSS | DroneCAN/AP_Periph | Regulated CAN power | u-blox F9P; dual-band/multiband RTK; H7 processing | Excellent if RTK is needed | €260.00 | 1 | €260.00 | Best navigation option discussed | Unnecessary unless RTK precision needed | https://docs.cubepilot.org/user-guides/here-4/here-4-manual

Sheet: Receivers
Receivers comparison
Prices are approximate retail snapshots discussed in the chat; verify availability, regional taxes, and shipping before purchase. 12S = 2x 6S LiPo in series: 44.4 V nominal, 50.4 V full.
Tier | Option | Manufacturer | Role / use | Firmware / protocol | Voltage / input | Outputs / current / key specs | 12S-system compatibility | Approx unit price EUR | Qty | Approx subtotal EUR | Advantages | Disadvantages / caveats | Source URL
Budget | RadioMaster RP1 | RadioMaster | RC receiver | ExpressLRS / CRSF | 5V regulated | 2.4GHz ELRS; 10mW telemetry; 500Hz/F1000Hz; 2.2g | Excellent with ArduPilot/INAV serial CRSF | €18.00 | 1 | €18.00 | Cheapest modern RC link | Single antenna; less robust than diversity | https://radiomasterrc.com/products/rp1-expresslrs-2-4ghz-nano-receiver
Medium | RadioMaster RP4TD | RadioMaster | Diversity RC receiver | ExpressLRS / CRSF | 4.5-12V | Dual SX1281; 2x antennas; max 2x100mW telemetry; 1.4g without antennas | Excellent for serious budget build | €35.00 | 1 | €35.00 | Best value robust receiver | Requires ELRS transmitter module/radio | https://radiomasterrc.com/products/rp4td-expresslrs-2-4ghz-diversity-receiver
Medium | TBS Crossfire Nano RX | TBS | Long-range RC receiver | Crossfire / CRSF | 3.3-8.4V | 868/915MHz; CRSF/SBUS/PPM/PWM; 0.5g; long-range ecosystem | Good with ArduPilot/INAV CRSF | €35.00 | 1 | €35.00 | Proven long-range ecosystem | Proprietary; pricier than ELRS | https://www.team-blacksheep.com/products/prod%3Acrossfire_nano_rx
Above medium | TBS Crossfire Diversity Nano RX | TBS | Diversity long-range RC receiver | Crossfire / CRSF | 3.3-8.4V | Diversity antennas; 12 channels; 1.8g | Good for larger aircraft | €55.00 | 1 | €55.00 | More robust than single Nano RX | More expensive than ELRS diversity | https://www.team-blacksheep.com/products/prod%3Axf_nano_div_rx
Above medium | FrSky Archer Plus GR6 | FrSky | RC receiver / PWM fallback | ACCESS/ACCST D16; SBUS/FBUS | 3.5-10V | 6 PWM outputs; built-in variometer; SBUS/FBUS | Works if you are already in FrSky ecosystem | €53.00 | 1 | €53.00 | Useful with FrSky radios | Less attractive than ELRS value | https://www.frsky-rc.com/product/archer-plus-gr6/
Expensive | Jeti REX 7 Assist | Jeti | Premium RC receiver | Jeti Duplex EX | 3.2-8.4V | 7 channels; telemetry; assist/stabilization | Only if using Jeti ecosystem | €165.00 | 1 | €165.00 | Premium radio ecosystem | Expensive and unnecessary unless already Jeti | https://www.jetimodel.com/receivers/duplex-rex-assist/

Sheet: Telemetry
Telemetry comparison
Prices are approximate retail snapshots discussed in the chat; verify availability, regional taxes, and shipping before purchase. 12S = 2x 6S LiPo in series: 44.4 V nominal, 50.4 V full.
Tier | Option | Manufacturer | Role / use | Firmware / protocol | Voltage / input | Outputs / current / key specs | 12S-system compatibility | Approx unit price EUR | Qty | Approx subtotal EUR | Advantages | Disadvantages / caveats | Source URL
Budget | No dedicated telemetry initially | N/A | Configure via USB + onboard logs | USB + SD logs | N/A | No radio; rely on RC link and blackbox/SD logs | Works for bench and very short tests | €0.00 | 1 | €0.00 | Saves money | Harder/sometimes unsafe for VTOL tuning
Medium | Holybro SiK Telemetry Radio V3 100mW | Holybro | Ground-station telemetry | SiK / MAVLink serial | 5V/USB/UART | 20 dBm; transparent serial link; Mission Planner/QGC | Works with ArduPilot/PX4, also MAVLink-capable setups | €60.00 | 1 | €60.00 | Standard telemetry option | Range limited compared with higher-power links | https://docs.holybro.com/radio/sik-telemetry-radio-v3
Medium | Holybro SiK Telemetry Radio V3 500mW | Holybro | Ground-station telemetry | SiK / MAVLink serial | 5V/USB/UART | 27 dBm; transparent serial link | Works with ArduPilot/PX4 | €65.00 | 1 | €65.00 | More link margin | Check legality/frequency in your country | https://docs.holybro.com/radio/sik-telemetry-radio-v3
Above medium | Holybro SiK Telemetry Radio Long Range 1W | Holybro | Longer-range telemetry | SiK / MAVLink serial | 7-28V via XT30 for 1W version | 30 dBm; 433/915MHz variants | Good, but frequency regulations matter | €89.00 | 1 | €89.00 | Higher power/range | More power draw; regional legality | https://holybro.com/products/sik-telemetry-radio-1w
Expensive | RFD868x / RFD900x | RFDesign | Long-range telemetry modem | SiK-derived / MAVLink serial | Regulated supply | 1W class; 868MHz variant preferred in EU | Excellent for ArduPilot/Pixhawk long-range | €225.00 | 2 | €450.00 | Serious long-range telemetry | Cost; 900MHz not EU-compliant | https://rfdesign.com.au/
Expensive | HereLink | CubePilot | Integrated RC + telemetry + HD video | CubePilot/Solex/QGC ecosystem | Air unit regulated input | HD video 1080p60; integrated controller/air unit | Works with Cube/Pixhawk-style builds | €750.00 | 1 | €750.00 | Integrated system | Very expensive and overkill for budget build | https://docs.cubepilot.org/user-guides/herelink/herelink-overview

Sheet: Airspeed
Airspeed comparison
Prices are approximate retail snapshots discussed in the chat; verify availability, regional taxes, and shipping before purchase. 12S = 2x 6S LiPo in series: 44.4 V nominal, 50.4 V full.
Tier | Option | Manufacturer | Role / use | Firmware / protocol | Voltage / input | Outputs / current / key specs | 12S-system compatibility | Approx unit price EUR | Qty | Approx subtotal EUR | Advantages | Disadvantages / caveats | Source URL
Budget | Generic MS4525DO airspeed kit | Generic/Holybro-compatible | Airspeed sensor | I2C; ArduPilot ARSPD_TYPE=1 | 5V regulated | 1 psi class; pitot tube; I2C | Good for fixed-wing/VTOL transition tuning | €35.00 | 1 | €35.00 | Cheap and sufficient for many fixed wings | Quality varies; I2C wiring susceptible to noise | https://docs.holybro.com/peripherals/ms4525do-and-ms5525dso-i2c-airspeed-sensor
Budget | Matek ASPD-4525 | Matek | Airspeed sensor | I2C | 4-6V | MS4525DO; ~5mA; ±0.25% span | Works through 5V rail; good budget option | €50.00 | 1 | €50.00 | Known FPV/UAV module | I2C only | https://www.mateksys.com/?portfolio=aspd-4525
Medium | Holybro MS4525DO / MS5525DSO | Holybro | Airspeed sensor | I2C; ArduPilot ARSPD_TYPE 1/4 | 4.75-5.25V | Digital pressure sensor; pitot kit; fixed-wing use | Good with ArduPilot/Pixhawk/INAV setups | €60.00 | 1 | €60.00 | Branded standard module | Still I2C, unless DroneCAN version | https://holybro.com/products/digital-air-speed-sensor-standard
Medium | SIYI MS4525 Airspeed Sensor | SIYI | Airspeed sensor | I2C | 5V regulated | Small MS4525 airspeed module; ~3g excluding pitot/tube | Good with compatible FC I2C | €50.00 | 1 | €50.00 | Small, modern option | Less discussed in ArduPilot community than Holybro/Matek | https://siyi.biz/siyi_file/MS4525%20Airspeed%20Sensor/SIYI%20MS4525%20Airspeed%20Sensor%20V1.0.pdf
Above medium | Matek ASPD-DLVR | Matek | High-precision airspeed sensor | I2C + CAN/DroneCAN | 4.5-5.5V | DLVR sensor family; CAN option; higher precision/low drift | Excellent for ArduPilot VTOL | €110.00 | 1 | €110.00 | Best airspeed sensor discussed | Higher cost | https://www.mateksys.com/?portfolio=aspd-dlvr

Sheet: Servos
Servos comparison
Prices are approximate retail snapshots discussed in the chat; verify availability, regional taxes, and shipping before purchase. 12S = 2x 6S LiPo in series: 44.4 V nominal, 50.4 V full.
Tier | Option | Manufacturer | Role / use | Firmware / protocol | Voltage / input | Outputs / current / key specs | 12S-system compatibility | Approx unit price EUR | Qty | Approx subtotal EUR | Advantages | Disadvantages / caveats | Source URL
Budget | JX PDI-6208MG | JX | Budget V-tail/control-surface servo | PWM servo | 4.8-6V | ~8.2 kg·cm @6V; ~0.07s/60°; ~62g | Use with 5/6V servo rail; not HV | €20.00 | 2 | €40.00 | Cheap, strong enough for moderate surfaces | Not premium; bench-test centering/backlash | https://hobbyking.com/jx-pdi-6208mg-metal-gear-digital-servo-8-2kg-0-07sec-62g.html
Budget | JX PDI-6221MG | JX | Budget V-tail/control-surface servo | PWM servo | 4.8-6V | 17.25 kg·cm @4.8V; 20.32 kg·cm @6V; 0.16s/60° @6V; 62g | Use with 6V servo rail; acceptable budget V-tail option | €20.00 | 2 | €40.00 | Very high torque per euro | Heavier; budget servo quality | https://www.jx-servo.com/en/Product/STANDARD/SD/555.html
Budget | JX PDI-HV6223MG | JX | Budget HV servo | PWM servo | HV 6-8.4V class | ~20kg class; metal gear | Use with 7.4/8V rail after bench testing | €22.00 | 2 | €44.00 | Cheap HV option | Need bench data/quality check | https://www.jx-servo.com/
Budget | JX PDI-HV5932MG | JX | Stronger budget HV servo | PWM servo | HV 6-8.4V class | ~30kg class; metal gear | Use with strong BEC; verify stall current | €29.00 | 2 | €58.00 | More torque than small servos | Budget reliability; needs testing | https://www.jx-servo.com/
Budget | JX PDI-HV2060MG | JX | Budget tilt/nacelle servo | PWM servo | 6.0-7.4V | 48 kg·cm @6V; 62 kg·cm @7.4V; 0.13s/60° @7.4V; ~200g | Works with 7.4V strong BEC; bench-test heavily before flight | €45.00 | 2 | €90.00 | Very high torque per euro | Flight-critical risk; heavy; budget QC | https://www.jx-servo.com/en/Product/STANDARD/SD/544.html
Medium | AGFRC B53CHS V2 | AGFRC | Control surface or light tilt servo | PWM servo; programmable | 4.8-8.4V | 24 kg·cm @8.4V; 0.08s/60°; coreless; steel gears | Good with 8.4V rail; better than JX for reliability | €45.00 | 2 | €90.00 | Strong and fast for price | Still not top-tier aviation servo | https://www.agfrc.com/index.php?id=2478
Medium | MKS HV6150H | MKS | Thin V-tail/wing servo | PWM HV servo | 4.8-8.4V | 10.9 kg·cm @8.2V; ~1.35A stall @8.2V; ~17g class | Excellent for thin control surfaces | €65.00 | 2 | €130.00 | High-quality wing servo; low stall current versus big servos | Less brute torque than standard-size servos | https://mksservo.eu/en/products/s0022017/
Medium | KST X15-1208 V8 | KST | Stronger control-surface servo | PWM HV servo | 6-8.4V | 13.5 kg·cm @8.4V; 0.07s/60° @8.4V | Good for V-tail/control surfaces with 8V rail | €83.00 | 2 | €166.00 | Strong and fast compact servo | More expensive than JX | https://www.kst-servo.com/
Premium | KST X08H V6 | KST | Thin light wing servo | PWM HV servo | 3.8-8.4V | ~2.8 kg·cm @8.4V; very thin 8mm class | Only for small/light surfaces | €48.00 | 2 | €96.00 | Very thin and light | Too little torque for large VTOL surfaces | https://www.kst-servo.com/
Premium | Savox SV-1270TG+ | Savox | Premium tilt/nacelle/high-load servo | PWM HV servo | 6.0-8.4V | 40 kg·cm @7.4V; 45 kg·cm @8.4V; 0.10s/60°; 64g; stall current up to ~8A @8.4V | Excellent for tilt with strong BEC | €90.00 | 2 | €180.00 | Safer high-torque reference | High current draw; expensive | https://savox-servo.com/en/product/SV-1270TGplus/savox-servo-sv-1270tg-digital-high-voltage-coreless-motor-titanium-gear

Sheet: Battery_Motor_Misc
Battery_Motor_Misc comparison
Prices are approximate retail snapshots discussed in the chat; verify availability, regional taxes, and shipping before purchase. 12S = 2x 6S LiPo in series: 44.4 V nominal, 50.4 V full.
Tier | Option | Manufacturer | Role / use | Firmware / protocol | Voltage / input | Outputs / current / key specs | 12S-system compatibility | Approx unit price EUR | Qty | Approx subtotal EUR | Advantages | Disadvantages / caveats | Source URL
Required | 2x Turnigy Heavy Duty 5500mAh 6S 60C in series | Turnigy/HobbyKing | Main battery system | N/A | 12S equivalent: 44.4V nominal, 50.4V full | Each pack: 5500mAh, 6S/22.2V, 60C, 773g, XT90; two in series = 244.2Wh | Main 12S power source | €70.00 | 2 | €140.00 | Uses chosen packs; doubles voltage | Capacity remains 5.5Ah in series; high current still stresses connectors/wires | https://hobbyking.com/en_us/turnigy-heavy-duty-5500mah-6s-60c-lipo-pack-w-xt90.html
Required | BrotherHobby Avenger 3120 motor | BrotherHobby | Lift motor | N/A | 8S/12S motor family | 500KV/700KV; 12N14P; 142.7g; 16AWG leads; M5 prop shaft | 500KV is the cleaner 12S choice; 700KV on 12S requires prop/current testing | €45.00 | 4 | €180.00 | Large motor class for VTOL lift | Must match prop/current/ESC; bench-test temperature | https://www.brotherhobbystore.com/products/avenger-3120-motor-149
Required | 5V active buzzer | Generic / Matek / Holybro | Lost-model / warning buzzer | FC buzzer output | 5V regulated | Active buzzer, simple 2-wire connection | Works with most FCs | €5.00 | 1 | €5.00 | Cheap safety/debug item | May be redundant if GPS module has buzzer | https://github.com/iNavFlight/inav/blob/master/docs/Buzzer.md
Required | Main series harness / anti-spark / arming plug | Generic | Connect 2x6S into 12S safely | N/A | 50.4V full; high current | Use high-current connectors/wire; avoid thin leads; include arming plug or anti-spark loop | Required for 12S system | €20.00 | 1 | €20.00 | Prevents accidental live system and connector arcing | Must be sized for real current, not just battery C-rating | https://docs.holybro.com/power-module-and-pdb/power-module/connector-and-wire-rating
Required | High-current silicone wire | Generic | Power wiring | N/A | 12S bus | Use wire gauge based on actual current and length; keep ESC/battery leads short | Critical for ESC/PDB safety | €15.00 | 1 | €15.00 | Reduces voltage drop/heat | Wrong gauge can overheat | https://docs.holybro.com/power-module-and-pdb/power-module/connector-and-wire-rating
Recommended | Cooling airflow / vents | Airframe design | Thermal management | N/A | N/A | ESCs in prop wash; fuselage inlet/outlet; outlet area ~2x inlet as a starting point | Required for budget ESCs and BECs under load | €0.00 | 1 | €0.00 | Free thermal margin | Needs design space and testing | https://store.tmotor.com/product/flame-80a-12s-v2-esc.html

Sheet: Summary
12S VTOL electronics comparison — design summary
System assumption | Value | Formula / note | Engineering consequence
Battery architecture | 2x 6S 5500mAh in series | Vnom = 22.2+22.2 = 44.4V; Vfull = 50.4V | ESCs/PDB/PMU must be 12S-rated; FC/servos get regulated voltage
Energy | 244.2 Wh | 44.4V × 5.5Ah | Capacity remains 5.5Ah in series; voltage doubles
Motor family | BrotherHobby Avenger 3120 | 8S/12S motor family | 500KV preferred for 12S; 700KV requires lower prop/current testing
PDB bottleneck if using FCHUB-12S | 4×70A continuous | Total continuous path ≈ 280A | 80-100A ESCs do not help if the PDB path is still limited to 70A/channel
Best budget FC | TBS Lucid H7 Wing | Direct 12S and H7 | Best value if ArduPilot is acceptable
Best INAV-friendly FC | Holybro Kakute H743-Wing or Matek H743-SLIM V4 | Use regulated power | More setup wiring than direct-12S TBS Lucid
Best budget ESC | Flycolor X-Cross HV3 80A or Sequre 12100 | True 12S voltage; budget price | Bench-test temperature and current before flight
Best budget servo power | Hobbywing UBEC 10A HV or Matek SVPDB-12S | Direct 12S input | For tilt servos use 25A HV BEC / Castle / PM12S-3 class
Where not to save money | Servo power + high-current wiring | Brownout or hot connector can crash aircraft | Use conservative wire/connector sizing and temperature tests
