NikolaNikolow/ORGOfly-CAD-model/P01/P01_05_Design/Flight_Control/Deflection of FL Surfaces/aileron_elevon_direct_drive_servo_selection.xlsx

Sheet: Summary
Direct-Drive Servo Selection — Aileron and Elevon
Design assumption | No external servo arm / pushrod / surface horn mechanical advantage.
Implication | Servo output torque must directly meet the hinge design torque.
Aileron direct-drive requirement | 4.195 Nm = 42.8 kg·cm at 24 m/s, 20° deflection, SF=3, η=0.90.
Elevon direct-drive requirement | 4.781 Nm = 48.8 kg·cm at 24 m/s, 20° deflection, SF=3, η=0.90.
Controlling case | Elevon, because it requires 48.8 kg·cm.
Minimum recommended servo rating | ≥60 kg·cm at 8.4V for practical margin; avoid ≤50 kg·cm for elevon direct drive.
Recommended servo | AGFRC A66FHLW low-profile 60 kg·cm servo, if 20.2 mm thickness and 29.5 mm height fit the CAD.
Power recommendation | Use a dedicated HV UBEC set to 8.4V; do not run these servos from the FC/PDB 5V rail.
Mechanical warning | No external arm is okay, but a spline-to-pin coupler/torque insert is still required. Do not use the servo shaft as the main structural hinge bearing.
Final Direct-Drive Recommendation | Qty | Unit price | Est. total | Voltage | Torque | Size | Reason
AGFRC A66FHLW | 4 | €128.99 | €515.96 | 8.4V | 60 kg·cm | 40.8 × 20.2 × 29.5 mm | Only low-profile option found with enough direct-drive margin for both aileron and elevon.
Hobbywing UBEC 25A HV | 1 |  |  | 3–18S input; 5.0/6.0/7.4/8.4V output | 25A continuous / 50A peak |  | Dedicated 8.4V servo rail for four high-torque servos.

Sheet: Requirements
Mechanical Load Basis
Surface | Worst case deflection | Design speed | Hinge moment conservative | Direct-drive design torque | Equivalent kg·cm | Pin recommendation | Source basis
Aileron | 20° | 24 m/s | 1.258 Nm | 4.20 | 42.78 | 6 mm × 30 mm minimum; 8 mm preferred | User aileron direct-drive pin calculation PDF
Elevon | 20° | 24 m/s | 1.434 Nm | 4.78 | 48.75 | 7 mm × 30 mm minimum; 8 mm preferred | User elevon direct-drive pin calculation PDF

Sheet: Direct_Drive_Servos
Direct-Drive Servo Options
Rank | Servo | Direct-drive verdict | Torque @8.4V kg·cm | Torque @7.4V kg·cm | Thickness / width mm | Height mm | Length mm | Weight g | Voltage | Approx. price | Margin vs elevon | Pros | Cons / Risk | Source URL
1 | AGFRC A66FHLW | Recommended | 60 | 53 | 20.2 | 29.5 | 40.8 | 75.8 | 4.8–8.4V | US$128.99 / ~€135 | 1.23x | Best direct-drive slim/low-profile fit; brushless; steel gears; aluminum case; IP67. | Still only 1.23× over calculated elevon design torque; requires rigid coupler and strong bearing support. | https://www.agfrc.com/index.php?id=2747
2 | AGFRC A86BHM | Acceptable but not slim | 55 | 49 | 20 | 41.5 | 40 | 88.5 | 4.8–8.4V | US$94.99 | 1.13x | Cheaper than A66FHLW; clears elevon at 8.4V. | Standard-height 41.5 mm body; margin is only 1.13×; less attractive for a thin wing/tail. | https://www.agfrc.com/index.php?id=2472
3 | JX PDI-HV2060MG | Torque OK, physically poor |  | 62 | 30.2 | 57.4 | 65.8 | 200 | 6.0–7.4V | ~€45–50 | 1.27x | Cheap and enough torque at 7.4V. | Very large and heavy; not a slim aircraft-control-surface servo; lower confidence for flight-critical direct drive. | https://servodatabase.com/servo/jx-servo/pdi-hv2060mg
4 | Chaservo HV4613 | Borderline | 50 |  | 20 |  |  |  | 6.0–8.4V | €84.90 | 1.02x | 20 mm class and close to required torque. | Only ~1.02× over elevon requirement on paper; not enough practical margin for direct drive. | https://www.voltmaster.de/HV4613-HV-Servo-20mm-50-kg
5 | Savox SV-1270TG+ | Not enough for elevon direct drive | 45 | 40 | 20.2 | 37.2 | 40.3 | 64 | 6.0–8.4V | ~€76 | 0.92x | Quality brand; compact standard-size body; good if you reduce loads or add mechanical advantage. | Below calculated elevon direct-drive requirement and only barely above aileron requirement. | https://savox-servo.com/en/product/SV-1270TGplus/
6 | MKS / KST 10–20 kg·cm slim wing servos | Reject for direct drive | 10 |  | 10 |  |  |  | HV | Varies | 0.20x | Physically slim and aircraft-oriented. | Insufficient torque for direct drive; only suitable with linkage/mechanical advantage.

Sheet: Power_Wiring
Servo Power and Wiring for Direct Drive
Component | Role | Recommended setting | Qty | Compatibility | Reason | Source URL
Hobbywing UBEC 25A HV | Dedicated servo power | 8.4V output | 1 | 3–18S input; fits 12S aircraft bus | Four high-torque servos should have a dedicated rail: 25A continuous / 50A peak. | https://www.hobbywing.com/en/products/ubec-25a-hv95.html
Hobbywing UBEC 10A HV | Smaller servo power option | 8.4V output | 1–2 | 3–14S input; fits 12S aircraft bus | Could power two servos, but not preferred for all four direct-drive servos. | https://www.hobbywing.com/en/products/ubec-10a-hv289
Matek FCHUB-12S | PDB / FC power / ESC distribution | 5V/12V rails only | 1 | 3–12S input | Can power FC and ESC paths; not a proper 8.4V high-current servo rail. | https://www.mateksys.com/?portfolio=fchub-12s
F405-HDTE / chosen FC | Signal only to servos | PWM signal line only | 1 | Standard PWM output | Servo positive/negative should come from dedicated UBEC; all grounds must be common.

Sheet: Design_Notes
Direct-Drive Design Notes
No arm/pushrod is possible, but no coupling is not possible. | A direct-drive setup still needs a spline-to-pin coupler, keyed insert, clamp block, cross-pin, or other torque-lock feature between servo output and aileron/elevon pin.
Servo shaft is not a hinge bearing. | The control surface must have independent bearings/bushings. The servo should transmit torque, not carry bending load.
Use the elevon as the sizing case. | Elevon direct-drive requirement is 48.8 kg·cm, higher than the aileron at 42.8 kg·cm.
Set servo endpoints carefully. | Limit travel in ArduPilot/INAV so the surface moves only to the required ±20° or final flight-tested deflection.
Bench-test before flight. | Measure actual current draw, temperature, centering, backlash, and holding behavior under realistic aerodynamic load or equivalent fixture load.
If Vmax increases, redo sizing. | Aerodynamic load scales by (Vmax/24)^2, so small speed increases quickly raise torque requirements.
