NikolaNikolow/ORGOfly-CAD-model/P01/P01_05_Design/Flight_Control/Deflection of FL Surfaces/aileron_elevon_servo_selection.xlsx

Sheet: Summary
Aileron + Elevon Servo Selection Summary
Prepared for the 12S VTOL electronics configuration. Prices are approximate and must be re-checked before purchase.
Design assumption | Value | Implication
Battery architecture | 2×6S in series = 12S, 44.4 V nominal / 50.4 V full | Servos must be powered from a regulated 6–8.4 V BEC, not raw 12S.
Flight controller in BOM | MATEKSYS F405-HDTE | Can command PWM servos; do not use FC/PDB small regulator as the main high-current servo rail.
PDB in BOM | MATEKSYS FCHUB-12S | Good for 12S distribution, but it does not provide an 8.4 V high-current servo rail.
Aileron required design torque | 4.195 Nm = 42.8 kg·cm | Direct drive requires a non-slim high-torque servo; slim servo needs mechanical advantage.
Elevon required design torque | 4.781 Nm = 48.8 kg·cm | This is the sizing driver; choose linkage around 2.7:1 to 3.0:1 if using 20 kg·cm slim servos.
Recommended servo | KST A15-1810 V8.0 | Best slim/low-profile balance: 20 kg·cm @ 8.4 V, 15 mm thickness, 42 g.
Recommended linkage | 10 mm servo-arm radius + 27–30 mm surface horn | 2.7:1 to 3.0:1 ratio. 3.0:1 gives 60 kg·cm effective torque but requires about 60° servo travel for 20° surface deflection.
Recommended servo power | Hobbywing UBEC 25A HV set to 8.4 V | Use for four high-torque HV servos. 10A HV UBEC is acceptable only for 1–2 servos or very light duty.
Final design note | Bench-test before flight | Check servo current, temperature, linkage stiffness, backlash, flutter, and actual max airspeed.

Sheet: Load_Basis
Load Basis From Uploaded Calculations
Torque values already include safety factor and direct-drive efficiency from the uploaded calculations.
Surface | Area [m²] | Design speed [m/s] | 20° conservative force [N] | Hinge moment [Nm] | Design torque [Nm] | Design torque [kg·cm] | Practical pin recommendation | Source
Aileron | 0.05676 | 24 | 41.95 | 1.258 | 4.195 | 42.8 | 6 mm × 30 mm minimum; 8 mm better if space allows | Uploaded aileron_direct_drive_pin_calculation.pdf
Elevon | 0.049 | 24 | 36.22 | 1.434 | 4.781 | 48.8 | 7 mm × 30 mm minimum; 8 mm preferred | Uploaded elevon_direct_drive_pin_calculation.pdf

Sheet: Servo_Options
Servo Options for Aileron and Elevon
Min linkage ratio is calculated against the aileron and elevon design torques. Effective torque assumes no additional losses beyond the uploaded torque margin.
Rank | Servo | Price approx. | Voltage | Torque @ HV [kg·cm] | Speed @ HV [s/60°] | Dimensions L×W×H [mm] | Thickness [mm] | Weight [g] | Motor/gears | Spline | Aileron min ratio | Elevon min ratio | Eff. torque @2.5:1 | Eff. torque @2.7:1 | Eff. torque @3.0:1 | Direct-drive fit? | Recommended use | Source URL
1 | KST A15-1810 V8.0 | €89.90 / $79.99 | 6.0–8.4 V | 20 | 0.1 | 35.5×15×32.5 | 15 | 42 | Coreless, hardened steel | 25T-6 | 2.14 | 2.44 | 50.00 | 54.00 | 60.00 | No | Primary recommendation: aileron + elevon with 2.7:1–3.0:1 linkage | https://www.kst-servo-shop.de/KST-A15-1810-V8.0-20kg.cmat8.4V-Coreless-Motor/KST-1026
2 | AGFRC A50BHL | $45.99 | 4.8–8.4 V | 19 | 0.073 | 40.8×20.2×26.5 | 20.2 | 50 | Brushless, steel | 25T Ø5.92 | 2.25 | 2.57 | 47.50 | 51.30 | 57.00 | No | Budget alternative; more RC-car oriented, thicker than KST | https://www.agfrc.com/index.php?id=2436
3 | XQ Power XQ-BLS325 | €62.95 | 6.0–8.4 V | 25 | 0.08 | 41×20.5×28 | 20.5 | 60 | Brushless, steel | 25T | 1.71 | 1.95 | 62.50 | 67.50 | 75.00 | No | Higher torque low-profile option; verify quality before flight | https://www.rovansports.nl/de/xq-power-xq-bls325-hv-brushless-low-profile-servo.html
4 | MKS HV747 | $109.45 | 6.0–8.4 V | 15 | 0.13 | 35.5×15×28.5 | 15 | 38.55 | Coreless, metal | MKS 25T class | 2.85 | 3.25 | 37.50 | 40.50 | 45.00 | No | High quality but needs high linkage ratio; not ideal for 20° elevon | https://mks-servo.com/HV747
5 | KST X15-1208 V8.0 | €82.90 | 6.0–8.4 V | 13.5 | 0.07 | 35.5×15×32.5 | 15 | 40 | Coreless, hardened steel | 25T-6 | 3.17 | 3.61 | 33.75 | 36.45 | 40.50 | No | Fast 15 mm servo; torque too low for this load unless high ratio | https://kstservos.com/products/x15-1208-cyclic-coreless-hv-digital-servo-motor
6 | MKS HV6150H | $71.11 / €65 class | 4.8–8.4 V | 10.9 | 0.159 | 23.5×11×25 | 11 | 16.4 | Coreless, metal alloy | MKS micro | 3.92 | 4.47 | 27.25 | 29.43 | 32.70 | No | Too weak for main aileron/elevon load; only for smaller surfaces | https://www.mks-servo.com/HV6150H
7 | Savox SV-1270TG+ | €78–90 | 6.0–8.4 V | 45 | 0.1 | 40.3×20.2×37.2 | 20.2 | 64 | Coreless, titanium | 25T | 0.95 | 1.08 | 112.50 | 121.50 | 135.00 | Borderline/No for elevon | Not slim; direct-drive aileron possible, elevon still needs margin | https://www.teamsavox.com/product/sv-1270tgp/

Sheet: Linkage_Setup
Recommended Linkage Geometry
Ratios assume surface torque = servo stall torque × surface horn radius / servo arm radius. Servo travel is surface deflection × ratio.
Setup | Servo model | Servo torque [kg·cm] | Servo arm radius [mm] | Surface horn radius [mm] | Linkage ratio | Effective surface torque [kg·cm] | Aileron margin | Elevon margin | Servo travel for 20° surface | Assessment | Notes
Strict default travel | KST A15-1810 | 20 | 10 | 25 | 2.50 | 50.00 | 16.88498212% | 2.558565152% | 50.00 | Acceptable but tight for elevon | Fits ±50° default travel; verify load with ground test.
Recommended compromise | KST A15-1810 | 20 | 10 | 27 | 2.70 | 54.00 | 26.23578069% | 10.76325036% | 54.00 | Best starting point | Requires about 54° servo travel for 20° surface; program endpoints or limit surface to about 18.5° if needed.
High margin | KST A15-1810 | 20 | 10 | 30 | 3.00 | 60.00 | 40.26197854% | 23.07027818% | 60.00 | Strongest torque margin | Requires about 60° servo travel for 20° surface. Use only if servo travel and linkage geometry allow it.
Budget similar | AGFRC A50BHL | 19 | 10 | 27 | 2.70 | 51.30 | 19.92399165% | 5.225087845% | 54.00 | Possible budget option | Thicker than KST; more RC-car oriented. Test centering, heat, and backlash.
Higher-torque low profile | XQ Power XQ-BLS325 | 25 | 10 | 20 | 2.00 | 50.00 | 16.88498212% | 2.558565152% | 40.00 | Good torque math | Only 40° servo travel at 20° surface; quality/reliability must be validated.

Sheet: BOM_Recommendation
Recommended Servo + Linkage BOM
Quantity assumes two ailerons and two elevons = four control-surface servos total.
Item | Qty | Unit price approx. | Subtotal formula | Purpose | Recommended spec | Source URL | Notes
KST A15-1810 V8.0 servo | 4 | €89.90 | €359.60 | Aileron/elevon actuation | 20 kg·cm @ 8.4 V, 15 mm thickness, 42 g | https://www.kst-servo-shop.de/KST-A15-1810-V8.0-20kg.cmat8.4V-Coreless-Motor/KST-1026 | Primary recommendation.
Hobbywing UBEC 25A HV | 1 | €107.00 | €107.00 | Servo power rail | 3–18S input, 5.2/6/7.4/8.4 V, 25A continuous / 50A peak | https://www.hobbywing.com/en/products/ubec-25a-hv95.html | Set to 8.4 V for HV servo torque. Price source in USD MSRP; EU price may differ.
KST / 25T aluminum servo arms | 4 | €10.90 | €43.60 | Servo-side arms | 25T-6, aluminum, M3 holes; shorten/drill to 10 mm radius if needed | https://www.kst-servo-shop.de/Alu-Servoarm-44-5-50-8-mm-M3-25T-6-KST-0625.50/KST-4134 | Avoid plastic arms for this torque level.
30 mm control horns | 4 | €1.90 | €7.60 | Surface-side horns | 27–30 mm effective radius depending on final linkage ratio | https://www.engelmt.de/mtaccessories/linking-material/control-horn/control-horns-smal-30mm | Use reinforced mounting plates or bonded hardpoints.
M3 ball links / hardware | 1 | €7.80 | €7.80 | Slop-reduced link joints | 10-pack M3 ball links | https://www.gator-rc.com/products/secraft-ball-link-3mm-qty-10 | One pack should cover 4 linkages with spares.
M3 adjustable pushrods | 4 | €11.49 | €45.96 | Pushrod linkage | 2.5 mm/M3 adjustable rods, length selected in CAD | https://www.rcwarehouse.nl/shop/1772511-ph2-5mm-m3-55mm-65mm-75mm-85mm-95mm-l30mm-multiple-adjustable-push-rod-rod-end-ball-joint-linkage-set-assembly-servo-c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 | Choose rod length after servo/horn placement is fixed.
Estimated total |  |  | €571.56 | Planning total |  |  | Excludes shipping/VAT differences and spare parts.

Sheet: BEC_Power
Servo Power Options
Do not power four high-torque HV servos from the FC/PDB's small 5 V regulator.
BEC | Price approx. | Input voltage | Output voltage | Current rating | Size/weight | Use case | Source URL
Hobbywing UBEC 10A HV | €43 / varies | 3–14S LiPo | 6.0 / 7.4 / 8.4 V | 10A continuous / 25A peak | 55×25×12 mm / 35 g | Acceptable for 1–2 servos or light duty; not my pick for four control servos. | https://www.hobbywing.com/en/products/ubec-10a-hv289
Hobbywing UBEC 25A HV | $107 MSRP / varies | 3–18S LiPo | 5.2 / 6.0 / 7.4 / 8.4 V | 25A continuous / 50A peak | 55×40.2×17.6 mm / 74 g | Recommended for four HV control-surface servos. | https://www.hobbywing.com/en/products/ubec-25a-hv95.html

Sheet: Sources
Sources and Verification Notes
URLs are plain text for auditability. Re-check availability/prices before ordering.
Category | Item | URL | Data used
Calculation | Aileron direct-drive calculation | Uploaded aileron_direct_drive_pin_calculation.pdf | Aileron design torque 4.195 Nm / 42.8 kg·cm and pin sizing basis.
Calculation | Elevon direct-drive calculation | Uploaded elevon_direct_drive_pin_calculation.pdf | Elevon design torque 4.781 Nm / 48.8 kg·cm and pin sizing basis.
Servo | KST A15-1810 | https://kstservos.com/products/a15-1810-20kg-0-10sec-hv-phosphor-bronze-hardened-steel-gear-servo | 20 kg·cm @ 8.4 V, 0.10 s/60°, 35.5×15×32.5 mm, 42 g.
Servo | KST A15-1810 EU price | https://www.kst-servo-shop.de/KST-A15-1810-V8.0-20kg.cmat8.4V-Coreless-Motor/KST-1026 | €89.90 current example price.
Servo | AGFRC A50BHL | https://www.agfrc.com/index.php?id=2436 | 19 kg·cm @ 8.4 V, 0.073 s/60°, 40.8×20.2×26.5 mm, $45.99.
Servo | XQ Power XQ-BLS325 | https://www.rovansports.nl/de/xq-power-xq-bls325-hv-brushless-low-profile-servo.html | 25 kg·cm @ 8.4 V, 0.08 s/60°, 41×20.5×28 mm, €62.95.
Servo | MKS HV747 | https://mks-servo.com/HV747 | 15 kg·cm @ 8.2 V, 35.5×15×28.5 mm.
Servo | MKS HV6150H | https://www.mks-servo.com/HV6150H | 10.9 kg·cm @ 8.2 V, 23.5×11×25 mm.
Servo | KST X15-1208 | https://kstservos.com/products/x15-1208-cyclic-coreless-hv-digital-servo-motor | 13.5 kg·cm @ 8.4 V, 35.5×15×32.5 mm.
BEC | Hobbywing UBEC 10A HV | https://www.hobbywing.com/en/products/ubec-10a-hv289 | 3–14S input, 6/7.4/8.4 V output, 10A continuous / 25A peak.
BEC | Hobbywing UBEC 25A HV | https://www.hobbywing.com/en/products/ubec-25a-hv95.html | 3–18S input, 5.2/6/7.4/8.4 V output, 25A continuous / 50A peak.
Linkage | KST aluminum servo arm | https://www.kst-servo-shop.de/Alu-Servoarm-44-5-50-8-mm-M3-25T-6-KST-0625.50/KST-4134 | 25T-6 aluminum servo arm, M3 holes.
Linkage | AFRC 25T servo horn | https://www.drone-fpv-racer.com/en/25t-aluminum-horn-for-servo-afrc-14028.html | Budget 25T aluminum horn example.
Linkage | Kavan 30 mm control horns | https://www.engelmt.de/mtaccessories/linking-material/control-horn/control-horns-smal-30mm | 30 mm control horns, €1.90 pair example.
Linkage | Secraft M3 ball links | https://www.gator-rc.com/products/secraft-ball-link-3mm-qty-10 | M3 ball link set, $7.80 example.
Linkage | Adjustable M3 pushrod set | https://www.rcwarehouse.nl/shop/1772511-ph2-5mm-m3-55mm-65mm-75mm-85mm-95mm-l30mm-multiple-adjustable-push-rod-rod-end-ball-joint-linkage-set-assembly-servo-c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 | 2.5 mm/M3 pushrod linkage, €11.49 example.
