NikolaNikolow/ORGOfly-CAD-model/P01/P01-10_General/P01-10-03-ConOps/P01-10-03-01_261108_ConOps_Mission.xlsx

Sheet: START HERE
ORGOfly | Mission & ConOps
Engineering intake workbook • Rev 0.2 • 2026-11-08 • Draft / not approved
How to complete
1. Open Parts A–D. Write answers in the light-gray Your answer column.
2. Use the Status dropdown: Needs input, Draft, Proposed, Confirmed, Needs revision or Not applicable.
3. Record the supporting source and date in Evidence / notes. Explain any Not applicable selection.
4. Confirm old discussion points before treating them as approved facts.
5. Record important design choices on Decision Log. Keep earlier revisions in Git.
6. To continue in another chat, attach the latest saved workbook.
Completion by section
Section | Part | Questions | Confirmed | N/A | Completed | Still open
01 · Mission purpose and objectives | Part A | 9 | 9 | 0 | 100% | 0
02 · Stakeholders and responsibilities | Part A | 8 | 8 | 0 | 100% | 0
03 · System boundaries | Part A | 6 | 6 | 0 | 100% | 0
04 · Reference aircraft configuration | Part A | 10 | 10 | 0 | 100% | 0
05 · Design reference missions | Part B | 12 | 12 | 0 | 100% | 0
06 · Mission phases and flight modes | Part B | 12 | 12 | 0 | 100% | 0
07 · Operating environment and geography | Part B | 12 | 12 | 0 | 100% | 0
08 · Mission performance objectives | Part B | 12 | 12 | 0 | 100% | 0
09 · Payload and mission service | Part C | 9 | 0 | 0 | 0% | 9
10 · Ground station and communications | Part C | 12 | 0 | 0 | 0% | 12
11 · Crew and human involvement | Part C | 10 | 0 | 0 | 0% | 10
12 · Infrastructure, logistics and maintenance | Part C | 11 | 0 | 0 | 0% | 11
13 · Abnormal and emergency operations | Part D | 14 | 0 | 0 | 0% | 14
14 · Regulatory and authorization strategy | Part D | 10 | 0 | 0 | 0% | 10
15 · Mission success and validation | Part D | 9 | 0 | 0 | 0% | 9
16 · Constraints, assumptions and approval | Part D | 9 | 0 | 0 | 0% | 9
Total | All parts | 165 | 81 | 0 | 49.09090909% | 84
Completion is a planning indicator. Confirmed answers still require sources, review and approval.

Sheet: Part A - Strategy
Part A — Strategy and definition
Enter your answer in column E, select its status in F, and add supporting notes in G. Earlier discussions are not approved requirements.
ID | Section | Question | Earlier project discussion | Your answer | Status | Evidence / notes
M01.1 | 01 · Mission purpose and objectives | What is ORGOfly's overall mission as a company/project? | ORGOfly project name established; overarching business mission not yet frozen. | A. Cargo Delivery Purpose: Deliver standardized cargo modules to pre-specified coordinates (urban & rural) reliably. Typical payloads: food kits, tools, spare parts, batteries, refrigerated medical supply module Success criteria: deliver 20 kg payload to landing point within target ETA and with minimum payload damage. Key tasks: pick up module, transit, land & release, transit, land at base. B. Firefighting Support Purpose: Support firefighting operations — sensor reconnaissance, drop small fire-suppression agents, deliver tools. Typical payloads: IR gimbal, small suppressant canisters. Success criteria: provide hot-spot location within 5 min of request; deliver suppression kit to staging point; Key tasks: rapid transit to fire area, sustained hover or slow pass for imaging, precise delivery to drop zone, return and land at base. C. Medical Supply Delivery Purpose: Deliver temperature-sensitive medical supplies (vaccines, blood packs, medicines) to remote locations. Typical payloads: refrigerated module with passive temperature control (no dry ice) for small volumes (up to 20 kg with cargo). Success criteria: monitor defined internal temperature (e.g., 2–8 °C) during transit; delivery within acceptable time window; continuous temperature log. Key tasks: pre-cool and seal module, enroute monitoring and control of temperature and GPS, precision delivery, handover or lower-to-ground, return and land at base D. Search & Rescue / Reconnaissance Purpose: Find missing persons, sur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 | Confirmed | Priority: P0
M01.2 | 01 · Mission purpose and objectives | What problem is the UAV intended to solve? |  | Carry medical supplies from laboratories to hospitals and vice versa. Carry medical kits to war zones. Carry organs for transplantation to hospitals where needed. Banner towing for advertisement | Confirmed | Priority: P0
M01.3 | 01 · Mission purpose and objectives | Who is the intended customer or end user? |  | Hospitals, military, laboratories, companies that want banner advertisement | Confirmed | Priority: P0
M01.4 | 01 · Mission purpose and objectives | What is the primary mission of the first prototype? | Medical/logistics transport, aerial advertising and multipurpose prototype concepts explored. | To see how the current design operates, what are the things that have to be changed, how it flies, does it fly. What vibrations does it induce, are the materials good enough. | Confirmed | Priority: P0
M01.5 | 01 · Mission purpose and objectives | What is the primary mission of the first commercial product? Is it different from the prototype mission? | Hospital-to-hospital delivery and banner-towing commercial scenarios discussed. | Mission of the first commercial product is banner towing, small medical kits. | Confirmed | Priority: P0
M01.6 | 01 · Mission purpose and objectives | What secondary missions should the same platform support? | Medical transport and advertising both investigated; no secondary priority approved. | Blood and plasma deliveries to hospitals, also laboratiory tests. | Confirmed | Priority: P0
M01.7 | 01 · Mission purpose and objectives | What is explicitly outside the scope of the first aircraft? |  | Nothing | Confirmed | Priority: P0
M01.8 | 01 · Mission purpose and objectives | What does a successful mission look like from the customer perspective? |  | For banner towing, towing the company banner across the set length and gathering customers. For blood deliveries - successful delivery from lab 1 to lab 2 or hospital-to-hospital for use. For medical supplies - successful drop-off at currently needed medical location, without taking the drone down if it is a war zone. | Confirmed | Priority: P0
M01.9 | 01 · Mission purpose and objectives | Why should the customer use this UAV instead of ground transport or existing drones? |  | There are no current existing drones, covering this domain for carrying medical supplies or banner towing. The drone is faster than ground transport, which sits in traffic and is very dependent on the time of day for the deliveries, also requirest 1 person to drive the vehicle, which requires the company to pay salary to this person. While the drone requires a pilot and eventually it will be autonomous, so no person is required to pilot the drone. | Confirmed | Priority: P0
M02.1 | 02 · Stakeholders and responsibilities | Who will own the aircraft? |  | Ownerships for now is relegated to the current 4 personnel making the aircraft - Nikola, Aleksandar, Martin and Martin. | Confirmed
M02.2 | 02 · Stakeholders and responsibilities | Who will operate it during prototype and commercial operations? |  | Martin, who has a drone license, but all the woner are required to take a pilot license test in the future. | Confirmed
M02.3 | 02 · Stakeholders and responsibilities | Who are the customers and mission beneficiaries? |  | Customers are hospitals and any companies, which require quick deliveries or advertisement. | Confirmed
M02.4 | 02 · Stakeholders and responsibilities | Will ORGOfly manufacture the aircraft in-house? | Team actively uses SolidWorks and Bambu 3D printing; manufacturing business scope unconfirmed. | Yes it will be manufactured in-house and with commercial parts. | Confirmed
M02.5 | 02 · Stakeholders and responsibilities | Who is responsible for maintenance and flight readiness? |  | The current 4 personnel making the aircraft - Nikola, Aleksandar, Martin and Martin. | Confirmed
M02.6 | 02 · Stakeholders and responsibilities | Who authorizes a mission to begin? |  | The current 4 personnel making the aircraft - Nikola, Aleksandar, Martin and Martin. | Confirmed
M02.7 | 02 · Stakeholders and responsibilities | Who has authority to abort a mission? |  | The current 4 personnel making the aircraft - Nikola, Aleksandar, Martin and Martin. | Confirmed
M02.8 | 02 · Stakeholders and responsibilities | Which external organizations will be involved (hospitals, logistics providers, airspace services, etc.)? | Hospitals and public airspace services considered in prior scenario discussions. | Airspace services, hospitals, laboratories and companies requiring advertisement. | Confirmed
M03.1 | 03 · System boundaries | Is the system limited to the UAV, or does it include the full UAS? | Six onboard systems established; full-UAS system boundary undecided. | Currently limited to the UAV, in the future special thermally controlled cargo-bay will be designed for carrying temperature sensitive quipments, such as organs, etc. | Confirmed | Priority: P0
M03.2 | 03 · System boundaries | Will your team design the ground station or use commercial equipment? | RadioMaster / possible Pixhawk hardware considered for ground/flight control. | Use commercial equipment | Confirmed | Priority: P0
M03.3 | 03 · System boundaries | Will navigation, telemetry and mission planning use one integrated ground system? |  | Yes | Confirmed | Priority: P0
M03.4 | 03 · System boundaries | Does the system need external internet or cellular connectivity? |  | For the first protoype no, in the future yes | Confirmed | Priority: P0
M03.5 | 03 · System boundaries | Are launch, recovery, charging or fueling facilities part of the product? |  | Not yet | Confirmed | Priority: P0
M03.6 | 03 · System boundaries | Which elements are provided by customers or outside service providers? |  | The cargo that has to be transported | Confirmed | Priority: P0
M04.1 | 04 · Reference aircraft configuration | Is the final aircraft conventional fixed-wing, VTOL or another hybrid arrangement? | Fixed-wing UAV with V-tail modeled; VTOL concepts and rotating propulsion discussed. | Fixed-wing electric propulsion system VTOL drone with tilt rotor system with a V-tail. | Confirmed | Priority: P0
M04.2 | 04 · Reference aircraft configuration | How many propulsion units will it use? |  | It has 4 tilt motors in total, 2 on the wing and 2 on top of the V-tail | Confirmed | Priority: P0
M04.3 | 04 · Reference aircraft configuration | Are propulsion units fixed or rotating? | Rotation actuator/mechanism concept discussed, not confirmed as final. | Rotating mechanism for VTOL capabilities and also for fixed-wing flying | Confirmed | Priority: P0
M04.4 | 04 · Reference aircraft configuration | What is the intended takeoff method? |  | VTOL and like a normal fixed wing | Confirmed | Priority: P0
M04.5 | 04 · Reference aircraft configuration | What is the intended landing method? |  | VTOL and like a normal fixed wing | Confirmed | Priority: P0
M04.6 | 04 · Reference aircraft configuration | Is the V-tail configuration final? | V-tail configuration modeled in SolidWorks. | Yes | Confirmed | Priority: P0
M04.7 | 04 · Reference aircraft configuration | Is a wingspan below 3 m a mandatory constraint? | Below 3 m wingspan discussed as aircraft-level target, not frozen. | However longer it is calculated from the equations. | Confirmed | Priority: P0
M04.8 | 04 · Reference aircraft configuration | Is an MTOW below 15 kg a mandatory constraint? | Below 15 kg MTOW discussed as aircraft-level target, not frozen. | 15 kg is the hard rquirement of the MTOW | Confirmed | Priority: P0
M04.9 | 04 · Reference aircraft configuration | Do these constraints apply to the prototype, commercial version or both? |  | To the first prototype and commercial version of the first drone | Confirmed | Priority: P0
M04.10 | 04 · Reference aircraft configuration | Which SolidWorks revision is the current reference aircraft configuration? | SolidWorks CAD exists, with Git/Git LFS; exact current revision not recorded here. | Revision P01 | Confirmed | Priority: P0

Sheet: Part B - Mission
Part B — Mission and environment
Enter your answer in column E, select its status in F, and add supporting notes in G. Earlier discussions are not approved requirements.
ID | Section | Question | Earlier project discussion | Your answer | Status | Evidence / notes
M05.1 | 05 · Design reference missions | Where does each reference mission start? | Hospital-to-hospital delivery and advertising along coast/highway explored. | Hospital, laboratory, coat line or grass near highway | Confirmed | Priority: P0
M05.2 | 05 · Design reference missions | Where does each reference mission end? | Hospital-to-hospital destination concept explored; no approved route. | Hospital, laboratory, coat line or grass near the highway | Confirmed | Priority: P0
M05.3 | 05 · Design reference missions | What is the one-way flight distance (km)? |  | 10 | Confirmed | Priority: P0
M05.4 | 05 · Design reference missions | Must the aircraft return to its starting location? |  | yes | Confirmed | Priority: P0
M05.5 | 05 · Design reference missions | Are intermediate landings permitted or required? |  | no | Confirmed | Priority: P0
M05.6 | 05 · Design reference missions | What payload is carried for each reference mission? | Medical cargo and banner advertising both discussed; actual mission payload unapproved. | medical cargo, blood, lab samples, banner | Confirmed | Priority: P0
M05.7 | 05 · Design reference missions | What is the estimated total flight time (min)? | One-hour advertising mission considered during research, not approved as requirement. | 15 | Confirmed | Priority: P0
M05.8 | 05 · Design reference missions | What is the intended operating altitude (AGL/MSL, as appropriate)? |  | 120m | Confirmed | Priority: P0
M05.9 | 05 · Design reference missions | What are the intended cruise conditions (speed, height, mass)? |  | 24 m/s, 120m, 13-15kg without or with payload | Confirmed | Priority: P0
M05.10 | 05 · Design reference missions | What energy or fuel reserve must remain at mission completion? |  | 50-40% SOC | Confirmed | Priority: P0
M05.11 | 05 · Design reference missions | What circumstances make the mission unsuccessful? |  | Environmental & Site Hazards • Adverse Weather: High winds, sudden rain, fog, and extreme temperatures compromise flight stability, degrade sensor data quality, and accelerate battery depletion. • Deceptive Winds Over Water: For lighter drones, fighting head winds while flying back over water frequently causes critical battery depletion before reaching the landing zone. • Unmapped Obstacles: Power lines, temporary cranes, overhanging tree branches, and reflective surfaces that sit outside the camera's field of view often cause catastrophic collisions. • Lack of Safe Landing Zones: In delivery or commercial operations, missions fail if the target site is obstructed by covered porches, trees, power lines, or unexpected obstacles like pets. 2. Technical & Hardware Malfunctions • Power & Battery Deficits: Drones often run out of power mid-flight because the mission’s duration exceeds the battery life, forcing premature returns or emergency landings. Structural issues like loose connections or battery dislodgement also trigger immediate failure. • Component Failure: Cracking propellers, overheating motors, or faulty Electronic Speed Controllers (ESCs) will cause a drone to flip, lose altitude, or fall completely. • Sensor and Firmware Faults: Malfunctioning Inertial Measurement Units (IMUs), uncalibrated barometers, corrupted firmware, or faulty GPS data cause the drone to lose orientation and drift off course. 3. Signal & Communication Disruptions • Link Degradation & Loss: A g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 | Confirmed | Priority: P0
M05.12 | 05 · Design reference missions | What should happen if the aircraft cannot finish its mission? |  | • Divert to an Alternate Landing site: Lands safely in a designated alternate landing site. • Declare an Emergency: If low on battery charge, experiencing mechanical failures, or facing critical systems loss, the pilot notifies Air Traffic Control (ATC). • Fly the Aircraft First: Try regaining control of the aircraft and land safely • Contingency / Abort Criteria: For specialized operations like drones or tactical flights, a pre-briefed threshold (such as low battery, severe weather drops, or loss of link) triggers an automatic return-to-home, hover, or controlled landing protocol. | Confirmed | Priority: P0
M06.1 | 06 · Mission phases and flight modes | How is the aircraft transported to the operating location? |  | The UAV is transported to the designated operating location in a protective transportation arrangement. The aircraft must be secured against mechanical damage, particularly at the wing, V-tail, control surfaces, propellers and lightweight 3D-printed structural components. Any removable components are transported separately and assembled on-site. The aircraft remains disarmed during transport. | Confirmed
M06.2 | 06 · Mission phases and flight modes | How is the aircraft assembled and prepared? |  | At the operating site, the operator assembles any removable structural components, verifies their attachments, installs the payload, connects the required electrical systems and checks the control mechanisms. The aircraft's mass and centre of gravity must be within the approved limits. The mission is loaded into the ground-control system where applicable, followed by system initialization and pre-flight checks. | Confirmed
M06.3 | 06 · Mission phases and flight modes | What checks are required before takeoff? |  | The pre-flight inspection covers structural condition, wing and tail attachments, control-surface movement and direction, servo operation, propulsion installation, electrical power, communication links, navigation sensors, payload security, aircraft mass and balance, flight-controller health, weather, airspace and contingency readiness. | Confirmed
M06.4 | 06 · Mission phases and flight modes | How is the aircraft armed and launched? |  | The aircraft is armed only after successful pre-flight checks, confirmation of a clear operating area and authorization by the responsible remote pilot. The launch method depends on the approved aircraft configuration. Conventional fixed-wing launch or VTOL takeoff procedures must be developed and verified separately. Propulsion and control systems remain in a safe state until the approved arming procedure is completed. | Confirmed
M06.5 | 06 · Mission phases and flight modes | How does it enter normal cruise? |  | After takeoff, the UAV climbs to its designated operating altitude while maintaining safe airspeed and flight stability. Once the required conditions are achieved, the aircraft enters normal cruise. If the VTOL configuration is adopted, this phase includes a transition from vertical lift to wing-borne flight. The transition must be completed within verified airspeed, altitude and aircraft configuration limits. | Confirmed
M06.6 | 06 · Mission phases and flight modes | Who or what controls the aircraft during each phase? |  | During initial prototype testing, the aircraft is controlled or supervised by a designated remote pilot. Stabilized flight-control modes may assist the pilot. Once the autonomous flight functions have been validated, the flight controller may manage navigation, cruise, mission execution and return, with human supervision and defined intervention procedures. | Confirmed
M06.7 | 06 · Mission phases and flight modes | How and when is the payload operated? |  | The payload is activated during the designated mission phase after the aircraft reaches the required operating conditions. Payload operation may be commanded by the operator or performed automatically according to the mission plan. The payload is deactivated or secured before landing, and all relevant payload operations are recorded. | Confirmed
M06.8 | 06 · Mission phases and flight modes | What triggers the return phase? |  | The UAV enters its return phase upon mission completion, operator command, reaching the minimum permitted energy or fuel reserve, or detecting conditions that require early recovery. Communication or navigation failures initiate predefined contingency procedures. | Confirmed
M06.9 | 06 · Mission phases and flight modes | How are approach and landing performed? |  | The UAV navigates toward the designated recovery location and performs an approach according to the selected landing configuration. The system verifies the necessary flight conditions, remaining energy, wind and recovery-area suitability. Landing is performed through the approved conventional or VTOL procedure. After recovery, propulsion is safely disabled. | Confirmed
M06.10 | 06 · Mission phases and flight modes | What happens after landing? |  | The aircraft is disarmed, propulsion is secured and the power systems are isolated as appropriate. The payload is removed or secured. The fuselage, wing, tail, propulsion and landing components are inspected for damage. Flight data are recorded and reviewed, and any detected anomalies are entered into the maintenance register. | Confirmed
M06.11 | 06 · Mission phases and flight modes | Which operational states are required (manual, stabilized, auto, RTL, emergency, etc.)? |  | Lifecycle states: OFF, INITIALIZING, PRE-FLIGHT, READY, TAKEOFF, CLIMB, CRUISE, MISSION, RETURN, APPROACH, LANDED, and FAULT/CONTINGENCY. Define available control modes separately (manual, stabilized, AUTO, LOITER, RTL, landing, and VTOL modes if used); specify transitions and override authority. | Confirmed
M06.12 | 06 · Mission phases and flight modes | If VTOL: how do hover, transition and fixed-wing modes interact? | VTOL and rotating propulsion discussed; actual transition concept not confirmed. | If the aircraft uses VTOL, it begins takeoff in vertical-lift mode. During transition, the propulsion and flight-control systems progressively transfer the aircraft from vertical lift to aerodynamic wing-borne flight. When the required flight conditions are met, the aircraft enters fixed-wing cruise. Before vertical landing, the aircraft transitions back to vertical-lift operation. Transition monitoring, control-surface authority, sufficient airspeed, actuator position and failure handling must be defined for the actual configuration. Established tilt-rotor autopilot systems use explicit transition criteria and different control strategies during this process. | Confirmed
M07.1 | 07 · Operating environment and geography | Where will the first prototype flights take place? |  | They will take in Bulgaria | Confirmed | Priority: P0
M07.2 | 07 · Operating environment and geography | Where will the first commercial operations take place? | Bulgaria explored as operating market; Sofia hospitals and coastal/highway areas discussed. | Bulgaria explored as operating market; Sofia hospitals and coastal/highway areas discussed. | Confirmed | Priority: P0
M07.3 | 07 · Operating environment and geography | Will operations be urban, suburban, rural or mixed? | Dense Sofia, roadside and coastal scenarios previously evaluated. | For now rural for testing, but in the future the plan is urban and suburban. | Confirmed | Priority: P0
M07.4 | 07 · Operating environment and geography | Will the aircraft fly over people, roads or occupied buildings? | Urban, road and beach-adjacent concepts raised; overflight rules need analysis. | The first prototype, no. The others yes | Confirmed | Priority: P0
M07.5 | 07 · Operating environment and geography | Will operations be VLOS, BVLOS or both? | Both VLOS prototype and possible BVLOS commercial operations discussed. | The first prototype will be VLOS | Confirmed | Priority: P0
M07.6 | 07 · Operating environment and geography | What kinds of airspace and aerodrome environments will be encountered? | EU/Bulgaria airspace regulation and SORA/PDRA concepts discussed. | EU/Bulgaria airspace regulation and SORA/PDRA | Confirmed | Priority: P0
M07.7 | 07 · Operating environment and geography | What is the expected operating altitude range? |  | 120m | Confirmed | Priority: P0
M07.8 | 07 · Operating environment and geography | Will flights be daytime, nighttime or both? |  | daytime | Confirmed | Priority: P0
M07.9 | 07 · Operating environment and geography | What sustained wind and gust limits are needed? |  | For initial prototype flight testing, the proposed operating limits are sustained winds not exceeding 3 m/s and gusts not exceeding 5 m/s. The future aircraft design target is operation in sustained winds up to 5 m/s and gusts up to 8 m/s, subject to verification. Separate limits shall be established for crosswinds, takeoff, landing and VTOL transition where applicable. Flights shall not be conducted when the approved wind limits are exceeded. | Confirmed | Priority: P0
M07.10 | 07 · Operating environment and geography | What is the required temperature range? |  | The initial prototype shall be intended for operation in ambient temperatures between +10°C and +30°C. A future operational target of 0°C to +35°C is proposed, subject to verification of structural materials, propulsion, avionics and other critical components. Aircraft structural temperatures must remain within validated material limits. Operation outside the approved temperature range shall be prohibited. | Confirmed | Priority: P0
M07.11 | 07 · Operating environment and geography | Must operations be possible in rain, snow, fog or icing? |  | The initial UAV prototype shall be operated in dry weather conditions only. Operations during rain, snow, hail or known or suspected icing conditions are not permitted. Flights in fog or reduced visibility shall not be conducted where the required visual observation, navigation, obstacle avoidance or safe recovery cannot be maintained. Future operation in adverse weather shall require additional system design, testing and approval. | Confirmed | Priority: P0
M07.12 | 07 · Operating environment and geography | What physical space is available for takeoff, recovery and emergencies? |  | Operations shall take place at designated locations providing sufficient obstacle-free space for takeoff, recovery and emergency procedures. The operating site shall include an appropriate launch/recovery area, clear approach and departure paths, separation from uninvolved persons, and designated contingency areas. The required dimensions shall be established based on the final aircraft configuration, demonstrated performance and operational risk assessment. A preliminary 20 × 20 m footprint may be investigated for VTOL landing-site planning, but is not an approved safety minimum. The actual available site dimensions remain to be confirmed. | Confirmed | Priority: P0
M08.1 | 08 · Mission performance objectives | Required payload mass (kg): threshold and preferred target? |  | 2kg | Confirmed | Priority: P0
M08.2 | 08 · Mission performance objectives | Required mission distance (km): threshold and preferred target? |  | 10 km | Confirmed | Priority: P0
M08.3 | 08 · Mission performance objectives | Required total endurance (minutes), including reserve? | One-hour flight duration explored for advertising research; mission requirement unconfirmed. | 15 min | Confirmed | Priority: P0
M08.4 | 08 · Mission performance objectives | Desired cruise speed (km/h or m/s)? |  | 24 m/s | Confirmed | Priority: P0
M08.5 | 08 · Mission performance objectives | Maximum acceptable mission duration? |  | 30 min | Confirmed | Priority: P0
M08.6 | 08 · Mission performance objectives | Required operating altitude and datum (AGL/MSL)? |  | 120m | Confirmed | Priority: P0
M08.7 | 08 · Mission performance objectives | Required wind and gust tolerance? |  | For initial prototype flight testing, the proposed operating limits are sustained winds not exceeding 3 m/s and gusts not exceeding 5 m/s. The future aircraft design target is operation in sustained winds up to 5 m/s and gusts up to 8 m/s, subject to verification. Separate limits shall be established for crosswinds, takeoff, landing and VTOL transition where applicable. Flights shall not be conducted when the approved wind limits are exceeded. | Confirmed | Priority: P0
M08.8 | 08 · Mission performance objectives | Maximum acceptable aircraft mass (kg)? | Under 15 kg MTOW target mentioned in earlier project discussions. | 13 kg | Confirmed | Priority: P0
M08.9 | 08 · Mission performance objectives | Maximum permitted aircraft dimensions (m)? | Wingspan below 3 m explored; not yet an approved dimensional limit. | wingspan 3m, 2m body length and 300mm max body width, ~400 height for the v-tail | Confirmed | Priority: P0
M08.10 | 08 · Mission performance objectives | Desired number of missions per day? |  | 2 | Confirmed | Priority: P0
M08.11 | 08 · Mission performance objectives | Maximum time allowed between consecutive missions? |  | 2 hours | Confirmed | Priority: P0
M08.12 | 08 · Mission performance objectives | Required mission success rate or operational availability? |  | 50% | Confirmed | Priority: P0

Sheet: Part C - Operations
Part C — Operations and support
Enter your answer in column E, select its status in F, and add supporting notes in G. Earlier discussions are not approved requirements.
ID | Section | Question | Earlier project discussion | Your answer | Status | Evidence / notes
M09.1 | 09 · Payload and mission service | What exactly will the aircraft carry or operate? | Candidate payloads: medical/logistics cargo or an advertising banner. | Advertising banner at the back, blood, plasma, laboratory samples | Needs input | Priority: P0
M09.2 | 09 · Payload and mission service | What are the maximum payload mass (kg) and dimensions/volume? |  | 228.6 mm x 304.8 mm x 203.2 mm, 1,9 kg | Needs input | Priority: P0
M09.3 | 09 · Payload and mission service | Is the payload internal or external? | Cargo storage concept contrasted with external banner towing; not selected. | Internal for payload bay, external for banner | Needs input
M09.4 | 09 · Payload and mission service | Must the payload be interchangeable? |  | Yes | Needs input
M09.5 | 09 · Payload and mission service | Who installs and removes it? |  | The owner of the aircraft, not the operator. Operator should not be able to change the configuration of the aircraft | Needs input
M09.6 | 09 · Payload and mission service | Does the payload require electrical power or data communication? |  | It requirese electrical power. In case of an emergency, it should be able to be detached in order to save the payload. | Needs input
M09.7 | 09 · Payload and mission service | Does it require temperature, humidity or vibration control? |  | Yes, it requires all of them | Needs input
M09.8 | 09 · Payload and mission service | Is it delivered, released, recovered or operated in flight? |  | It is delivered and can also be released | Needs input
M09.9 | 09 · Payload and mission service | Are there hazardous, medical, fragile or special-handling requirements? |  | Not for the first prototype | Needs input
M10.1 | 10 · Ground station and communications | Will there be one ground station or several? | RadioMaster transmitter and telemetry/ground-station concepts discussed. | RadioMaster transmitter and telemetry/ground-station via a laptop with ArduPilot | Needs input
M10.2 | 10 · Ground station and communications | Must a remote pilot continuously control the aircraft? |  | Yes | Needs input
M10.3 | 10 · Ground station and communications | Can the aircraft complete a mission autonomously? |  | Not for the first prototype | Needs input
M10.4 | 10 · Ground station and communications | What should happen upon loss of radio-control link? | Loss-of-link behaviour has not yet been formally specified. | Hover and stop with the latest command until the link is recovered. If after 2 min, no link is established, starting lowering altitude until it lands. Future: Redundancy should be made for a second controller to try establish a new link | Needs input
M10.5 | 10 · Ground station and communications | What should happen upon loss of telemetry? |  | Hover and stop with the latest command until the link is recovered. If after 2 min, no link is established, starting lowering altitude until it lands. Future: Redundancy should be made for a second controller to try establish a new link for telemetry | Needs input
M10.6 | 10 · Ground station and communications | Is a separate BVLOS C2 link planned? | Possible future BVLOS C2-link integration and FCC/LBT receiver compatibility investigated. | BVLOS C2-link integration and FCC/LBT receiver compatibility | Needs input
M10.7 | 10 · Ground station and communications | What data and indicators must the ground station display? | RadioMaster TX16S, XR4/RP4TD and Cube/Pixhawk options discussed. | RadioMaster TX16S, XR4/RP4TD and Cube/Pixhawk options | Needs input
M10.8 | 10 · Ground station and communications | Does the payload transmit real-time data? |  | Not for the first prototype | Needs input
M10.9 | 10 · Ground station and communications | Are flight/mission data stored? Where and for how long? |  | Yes. Record flight-controller data (onboard memory/SD where supported) and ground-station telemetry when available. Download after each test flight into a restricted, backed-up engineering archive, linked to the aircraft and test configuration. Provisional raw telemetry retention: 12 months, reviewed for privacy and engineering need. Maintain the formal flight-activity log for at least 2 years where the applicable Specific-category guidance requires it; apply any longer binding retention duties. | Needs input
M10.10 | 10 · Ground station and communications | Must operators update or cancel missions remotely? |  | Yes, the authorized remote pilot must be able to interrupt or cancel an active automated mission and select an approved safe control or recovery mode. Prepare and validate waypoints before takeoff. In-flight route editing is not required for initial prototype flights and may be enabled later after specific testing. Mission interruption shall not rely solely on the ground-station computer; loss-of-link response must be predefined. | Needs input
M10.11 | 10 · Ground station and communications | Is control handover between pilots or ground stations required? |  | No handover between multiple pilots or ground stations is required for initial prototype operations. Assign one remote pilot with primary command authority and one primary ground station. Any change in pilot responsibility shall use an explicit verbal and procedural handover. Technical transfer of command authority between stations is a deferred feature to assess for future BVLOS operations. | Needs input
M10.12 | 10 · Ground station and communications | What security, privacy or data-protection constraints apply? |  | Protect aircraft configuration, command access, telemetry and stored data against unauthorized access or modification. Use individual authorized accounts, controlled firmware/settings, secure storage/backups and authenticated or encrypted links where supported and risk-appropriate. Minimize personal data and imagery; when personal data are processed, comply with GDPR lawful basis, transparency, purpose and retention limits, and security obligations. Assess additional safeguards for future payloads and BVLOS. | Needs input
M11.1 | 11 · Crew and human involvement | How many people are needed for normal missions? |  | 4 - 2 pilots and 2 personnel responsible for aircraft building | Needs input
M11.2 | 11 · Crew and human involvement | Is a remote pilot always present and responsible? | Remote-controlled prototype discussed; exact role/responsibility not frozen. | Yes. During initial prototype operations, one designated remote pilot shall be present and responsible for the safe conduct of each flight. The pilot shall supervise aircraft operation, monitor flight conditions and maintain the ability to intervene when required. Automatic flight-control functions may assist the pilot but shall not remove the pilot's operational responsibilities. | Needs input
M11.3 | 11 · Crew and human involvement | Are visual observers needed or planned? |  | A visual observer is planned for initial prototype flight testing as an additional safety measure. The observer shall monitor the aircraft, surrounding airspace and potential hazards, communicating relevant information to the remote pilot. Although a separate visual observer is not mandatory for every Open-category VLOS operation, ORGOfly intends to use one during early testing. Future BVLOS operations will require a separate assessment of observation and airspace-risk mitigation arrangements. | Needs input
M11.4 | 11 · Crew and human involvement | Is a dedicated payload operator needed? |  | A dedicated payload operator is not required for initial prototype flights using a simple or inert test payload. Payload preparation, securing and inspection may be performed by a trained ground crew member. A separate payload operator may be introduced for future missions requiring active payload control, complex loading procedures or specialized mission equipment. | Needs input
M11.5 | 11 · Crew and human involvement | Who manages takeoff and landing? |  | The designated remote pilot shall manage and authorize takeoff and landing operations. Trained ground personnel may assist with aircraft preparation, positioning, launch and recovery as required by the selected aircraft configuration. Automatic takeoff or landing functions may only be introduced after successful testing and validation. The remote pilot retains responsibility for flight safety. | Needs input
M11.6 | 11 · Crew and human involvement | How does the operational crew communicate? |  | During initial prototype operations, crew members shall use direct verbal communication whenever operating from the same location. Standardized commands and acknowledgements shall be established for arming, takeoff, landing, emergency procedures and mission termination. When personnel are separated, reliable voice-radio communication shall be used. Crew responsibilities and emergency communication procedures shall be reviewed during the pre-flight briefing. | Needs input
M11.7 | 11 · Crew and human involvement | What qualifications and training are expected? |  | All remote pilots shall hold the qualifications required for the applicable operational category. For qualifying Open A3 operations, this includes completion of the required A1/A3 online training and theoretical examination. Additional aircraft-specific training shall cover the UAV configuration, flight-control modes, pre-flight inspections, emergency procedures, communication systems, environmental limitations and safe recovery. Supporting personnel shall receive appropriate training for their assigned duties. Future Specific-category and BVLOS operations may require additional qualifications. | Needs input
M11.8 | 11 · Crew and human involvement | How are responsibilities transferred between operators? |  | During initial prototype testing, one designated remote pilot shall retain command authority throughout each flight. Routine in-flight control handover is not planned. If a transfer of responsibility becomes necessary, the aircraft shall first be placed in a suitable safe condition, and the transfer shall be explicitly communicated and acknowledged by both operators. The identity of the pilot holding command authority must remain unambiguous at all times. | Needs input
M11.9 | 11 · Crew and human involvement | Who makes go/no-go decisions? |  | The designated remote pilot shall have the final immediate authority to determine whether a flight can be conducted safely. The decision shall consider weather, airspace, aircraft condition, electrical and propulsion readiness, communication systems, mission configuration and personnel readiness. The test director or UAS operator may impose additional authorization requirements. Any crew member may identify a safety concern and request that operations be stopped. A flight shall proceed only when all mandatory conditions are satisfied. | Needs input
M11.10 | 11 · Crew and human involvement | Which actions may occur without human intervention? |  | During initial prototype operations, automatic flight stabilization, sensor monitoring, flight-data recording and validated protective functions may operate without continuous manual control inputs. Automated navigation, waypoint following, loiter and return functions may be introduced progressively following successful verification. Automatic takeoff, landing, VTOL transition and payload actuation shall require separate testing and approval before operational use. The remote pilot shall retain the ability to intervene wherever required by the operating category and approved operational concept. | Needs input
M12.1 | 12 · Infrastructure, logistics and maintenance | Where is the aircraft stored? |  | The prototype UAV shall be stored indoors in a clean, dry, secure workshop or designated storage facility, protected from direct sunlight, heat, moisture, dust and mechanical impact. Lightweight printed wings and tail surfaces shall be supported without sustained bending loads. The aircraft shall remain disarmed/powered off. Removable batteries, if fitted, shall be stored separately under the battery manufacturer's safety instructions. Exact facility and approved temperature/humidity limits are TBD. | Needs input
M12.2 | 12 · Infrastructure, logistics and maintenance | How is it transported? |  | The prototype UAV shall be transported by road in a suitable vehicle using padded, secured supports or protective cases. Wing, V-tail, propellers and lightweight printed parts shall be protected from impact and deformation. Large assemblies may be removed only if their mechanical/electrical interfaces are designed for repeated assembly. The UAV shall be disarmed and powered off; batteries or fuel shall be transported in accordance with the applicable safety requirements. Transport configuration and handling procedure are TBD. | Needs input
M12.3 | 12 · Infrastructure, logistics and maintenance | Must it fit within a particular vehicle or container? |  | No particular vehicle or container is yet a mandatory requirement. A preliminary objective is transport in a passenger estate car or small van, using detachable wings or other assemblies if required and approved. Packaged dimensions, mass and the chosen vehicle's actual load space must be verified against the current CAD model (preliminary 3.027 m wingspan; 1.650 m fuselage length). Printed CAD sections are not automatically field-removable assemblies. | Needs input
M12.4 | 12 · Infrastructure, logistics and maintenance | Is assembly needed before each flight? | Aircraft divided into printable sections; assembly workflow not defined. | Partial assembly may be needed when transporting removable wings, V-tail parts or external equipment. Once at the operating site, all removable structures and connectors shall be installed, secured, and checked for mechanical attachment, electrical continuity, control direction and payload retention. If the aircraft remains assembled between test flights, full disassembly is not necessary; each flight still requires the approved pre-flight inspection. Assembly sequence and tools are TBD. | Needs input
M12.5 | 12 · Infrastructure, logistics and maintenance | What infrastructure and equipment is needed at each site? |  | Each test site shall have an assessed launch/recovery area, obstacle and personnel controls, a suitable preparation zone, and space for contingencies. Portable equipment shall include the approved transmitter, ground-control/telemetry equipment as applicable, checklists, basic assembly tools, electrical test gear, weather monitoring, appropriate spare parts, first-aid and fire-response provisions, and means of emergency communication. Charging/fueling facilities and any special VTOL/launch equipment depend on the approved aircraft configuration. Actual area dimensions and site-specific equipment are TBD. | Needs input
M12.6 | 12 · Infrastructure, logistics and maintenance | How is the aircraft charged or refueled? |  | Energy replenishment shall follow the finalized propulsion configuration. If battery-electric: inspect packs, use compatible chargers in a designated supervised area under the battery manufacturer's instructions, and verify available energy before flight; removable charged packs are preferred if suitable. If combustion or hybrid: establish fuel handling, spill/leak, ignition-source and fire precautions and perform quantity checks. Propulsion shall be safely disabled before servicing. Battery chemistry, charger, fueling method and turnaround assumptions are not yet approved. | Needs input
M12.7 | 12 · Infrastructure, logistics and maintenance | How quickly must the aircraft be ready for another mission? |  | Rapid turnaround is not a priority for initial prototype testing; post-flight inspection and engineering review take precedence. A preliminary planning objective is readiness for a subsequent flight within 60 minutes after landing, only if there are no defects or configuration changes and a ready energy source is available. This excludes required recharge time, repairs and investigation. Measure actual turnaround during testing and define any future commercial requirement from the reference mission. | Needs input
M12.8 | 12 · Infrastructure, logistics and maintenance | Who performs routine maintenance? |  | Designated, appropriately trained ORGOfly engineering personnel shall perform routine prototype maintenance following written instructions, with the UAS operator accountable for aircraft condition. Tasks include airframe and joint inspection, servo/control checks, propulsion and electrical inspection, software configuration control and approved component replacement. The person performing maintenance shall document work and outstanding defects; aircraft release for flight requires an authorized serviceability decision. Competency, responsibilities and maintenance procedures are to be formally defined. | Needs input
M12.9 | 12 · Infrastructure, logistics and maintenance | Which parts must be replaceable in the field? |  | Field replacement should be possible for approved modular items such as propellers, removable batteries (if fitted), servos, horns/linkages, antennas, connectors and accessible electronics, subject to the designed access and approved procedures. After replacement, required mechanical, electrical, calibration and functional checks shall be completed. Major load-bearing printed wing, fuselage and V-tail elements shall not be improvised-repaired in the field; they require engineering-controlled repair or replacement and release. Approved replaceable-unit and spares lists are TBD. | Needs input
M12.10 | 12 · Infrastructure, logistics and maintenance | What is the intended service life or number of cycles? |  | The first UAV is an experimental test article and no validated airframe service life or cycle limit has yet been established. Record flight hours, takeoff/landing cycles, propulsion hours, battery cycles where applicable and component replacements. Inspect before and after each test flight and after abnormal events. Perform a proposed engineering condition review after the first 10 flights, but do not treat that as a demonstrated safe-life limit. Establish component and airframe limits from structural/material tests and operational evidence, focusing on LW-PLA creep, temperature sensitivity, fatigue, joints and layer adhesion. | Needs input
M12.11 | 12 · Infrastructure, logistics and maintenance | How are inspections, repairs and software updates recorded? |  | Assign each prototype a unique aircraft ID and maintain a controlled electronic technical logbook. Record flight IDs/dates/hours/cycles, configuration and CAD revision, pre/post-flight inspections, defects, repairs, replacements, authorized maintainer, test results and serviceability status. Record firmware/software version changes, configuration changes, validation and responsible engineer. Link CAD and engineering records to version-controlled Git commits or release tags. Retain records according to applicable operating requirements and a formal engineering retention policy; the applicable regulatory retention period is to be confirmed. | Needs input

Sheet: Part D - Assurance
Part D — Safety and assurance
Enter your answer in column E, select its status in F, and add supporting notes in G. Earlier discussions are not approved requirements.
ID | Section | Question | Earlier project discussion | Your answer | Status | Evidence / notes
M13.1 | 13 · Abnormal and emergency operations | What is the response to loss of manual radio-control link? | Radio link compatibility evaluated, but approved failsafe response missing. | On loss of the command-and-control (C2) link, the aircraft shall use a preconfigured and ground-tested failsafe appropriate to its verified navigation and energy state. The remote pilot and observer shall monitor its response and protect the recovery area. A return-to-launch action is only permitted if position information and the relevant flight mode are valid; otherwise use another proven contingency response. | Needs input | Priority: P0
M13.2 | 13 · Abnormal and emergency operations | What is the response to loss of telemetry? |  | If telemetry is lost while the independent pilot-control link remains functional, the remote pilot shall stop mission testing and recover the aircraft by the safest available verified method. If telemetry and C2 share the same link, apply the C2-loss procedure. No autonomous test requiring telemetry supervision shall continue without its required monitoring. | Needs input | Priority: P0
M13.3 | 13 · Abnormal and emergency operations | What is the response to loss or corruption of GNSS navigation? |  | On unreliable GNSS position or navigation, discontinue GPS-dependent mission modes and return-to-launch commands. If available and validated, switch to a non-GNSS stabilized/manual mode, maintain VLOS, and land in the designated safe area. If controllability or position cannot be maintained, execute the approved emergency response. | Needs input | Priority: P0
M13.4 | 13 · Abnormal and emergency operations | What is the response to propulsion failure? |  | On loss of propulsion, the remote pilot shall initiate the verified emergency recovery appropriate to the actual aircraft configuration. A conventional fixed-wing aircraft may glide to a suitable preselected area if sufficient altitude and control remain; a VTOL or hybrid aircraft requires a separate loss-of-thrust/transition assessment. Flight shall not continue to pursue mission objectives. | Needs input | Priority: P0
M13.5 | 13 · Abnormal and emergency operations | What happens with insufficient remaining energy/fuel? |  | Monitor available energy or fuel and give progressive warning before a defined minimum safe reserve is reached. When the recovery threshold is reached, abort the mission and initiate the approved return or landing procedure. If continued flight is unsafe, use the approved contingency landing option. Reserve thresholds shall be established from measured consumption and mission conditions. | Needs input | Priority: P0
M13.6 | 13 · Abnormal and emergency operations | What is the response to servo malfunction or mechanical jam? | KingMax DCS2016SP selected as prototype servo candidate; failure strategy undefined. | Following suspected servo failure, linkage failure or jam, abort the test manoeuvre, maintain safe airspeed, and land as soon as safely practicable if sufficient control authority remains. A failure that prevents controlled flight triggers the approved emergency response. No further flight is permitted until the fault is diagnosed, repaired and checked. | Needs input | Priority: P0
M13.7 | 13 · Abnormal and emergency operations | What is the response to flight-controller or sensor malfunction? |  | Critical flight-controller or sensor faults shall trigger clearly defined fault indications and a validated degraded or failsafe mode where technically supported. The remote pilot shall terminate test objectives and recover the aircraft if controllable. Flight is prohibited after an unresolved critical fault; faults and flight logs shall be retained for investigation. | Needs input | Priority: P0
M13.8 | 13 · Abnormal and emergency operations | What is the response to unexpected adverse weather? |  | Do not launch outside approved weather limits. If wind, gusts, rain, visibility or other conditions deteriorate in flight, discontinue the mission and return or land in a suitable safe area while sufficient control and energy remain. Severe hazards or loss of safe recovery capability activate the emergency plan. | Needs input | Priority: P0
M13.9 | 13 · Abnormal and emergency operations | What is the response to unexpected aircraft or obstacles? |  | Maintain separation from manned aircraft and uninvolved persons. The remote pilot shall immediately take avoidance action, including descent or recovery as appropriate for the airspace and aircraft capability, and abort the test if separation cannot be assured. The observer shall report hazards without delay. | Needs input | Priority: P0
M13.10 | 13 · Abnormal and emergency operations | What happens if launch or landing equipment fails? |  | If launch equipment or the aircraft's takeoff system fails before leaving the ground, stop arming/launch and inspect the aircraft. If recovery or landing equipment fails during flight, use only preplanned and verified alternative recovery locations or procedures. No flight shall begin without a credible safe-recovery plan. | Needs input | Priority: P0
M13.11 | 13 · Abnormal and emergency operations | What is the response to payload malfunction? |  | On payload malfunction, suspend payload operation and maintain the payload securely attached. Abort and recover the aircraft if the fault affects mass balance, structure, power or flight safety. Do not release or drop objects during initial Open-category testing. Record the defect and prohibit further mission use until resolved. | Needs input | Priority: P0
M13.12 | 13 · Abnormal and emergency operations | What is the response to route deviation or loss of containment? |  | The crew shall monitor planned operating boundaries and any configured containment limits. If deviation is detected, discontinue the mission and command a safe recovery while control is available. If the aircraft cannot remain within the operating area, activate the documented loss-of-containment emergency plan and notify relevant parties as required. | Needs input | Priority: P0
M13.13 | 13 · Abnormal and emergency operations | When should emergency landing or flight termination be used? |  | Emergency landing is considered when continued normal flight poses a greater risk than recovery at an identified contingency site. Flight termination is a last-resort safety function, only if required by the approved risk assessment, legally permissible and demonstrated to reduce third-party risk; it is not assumed to exist on the prototype. Define activation authority and safety conditions before any flight. | Needs input | Priority: P0
M13.14 | 13 · Abnormal and emergency operations | How will the organization respond to crash, injury, fire or property damage? |  | Immediately stop operations, warn people, summon emergency services where needed, provide first aid if trained, and protect responders from propellers, batteries/fuel and damaged structure. Secure the area, preserve logs and physical evidence, notify authorities/affected parties as legally required, and record the event. Ground the aircraft until investigation, corrective action and formal return-to-service approval. | Needs input | Priority: P0
M14.1 | 14 · Regulatory and authorization strategy | In which country is the UAS operator established? | Bulgaria is principal operating context, but legal operator establishment unconfirmed. | The intended operator context is Bulgaria, but the legal entity/person acting as UAS operator and its Member State of principal establishment have not yet been confirmed. Operator registration shall be in the applicable Member State of residence/principal place of business, not automatically the test-site country. | Needs input | Priority: P0
M14.2 | 14 · Regulatory and authorization strategy | In which countries will the aircraft operate? | Bulgaria and EU operations discussed. | Bulgaria is the initial intended country for testing and potential early operation. Other EU Member States may be future markets but are outside the approved prototype operating scope until individually assessed, including cross-border Specific-category notification/authorization where applicable. | Needs input | Priority: P0
M14.3 | 14 · Regulatory and authorization strategy | Is initial prototype testing limited to VLOS operations? | VLOS versus BVLOS authorization paths considered. | Yes, the recommended initial prototype concept is pilot-supervised VLOS flight testing in a suitably isolated operating area. Open A3 may be considered only if the privately built aircraft and the complete operation satisfy all applicable Open-category conditions; otherwise the appropriate Specific-category authorization must be obtained before flight. | Needs input | Priority: P0
M14.4 | 14 · Regulatory and authorization strategy | Is BVLOS essential for the first commercial mission? | Hospital-to-hospital BVLOS use case discussed, but not approved as initial commercial mission. | BVLOS is a potential requirement for the previously discussed hospital-to-hospital mission. It is not required for initial prototype tests, and has not yet been approved as mandatory for the first commercial mission. A separate BVLOS ConOps and authorization basis shall be developed before any BVLOS operations. | Needs input | Priority: P0
M14.5 | 14 · Regulatory and authorization strategy | Must the aircraft operate over populated areas? | Dense Sofia BVLOS concept discussed. | Flights over populated areas are excluded from the proposed initial prototype test scope. Urban operations around Sofia have been discussed as a future mission, but these shall be treated as a separate Specific-category operating concept with its own ground-risk assessment and authorization. | Needs input | Priority: P0
M14.6 | 14 · Regulatory and authorization strategy | Are specific airspace restrictions or UAS geographical zones involved? |  | The exact prototype site and route are not yet selected. For every flight, check Bulgarian UAS geographical zones, activated restricted airspace, aerodrome proximity and local restrictions immediately before flight; secure permissions or reserved airspace where required. Record the airspace check and applicable limitations in the test card. | Needs input | Priority: P0
M14.7 | 14 · Regulatory and authorization strategy | Is an STS, PDRA, individual SORA or other authorization route being targeted? | PDRA/SORA/SAIL 3/4 and Open category considered; no selected compliance path. | Proposed staged approach: evaluate Open A3 for eligible initial VLOS prototype flights, then assess an applicable Specific-category authorization route for BVLOS/urban commercial operations (relevant PDRA/STS if the complete operation meets its conditions, otherwise individual SORA 2.5-based assessment). No authorization route has yet been approved. | Needs input | Priority: P0
M14.8 | 14 · Regulatory and authorization strategy | Which organizational safety/operational procedures already exist? |  | Working drafts exist for mission phases, crew responsibilities, pre-flight checks, basic failsafe concepts, maintenance and flight records. No evidence in the accessible project files establishes that a complete operations manual, emergency response plan, risk assessment, occurrence-reporting process and controlled training records have been formally approved. | Needs input | Priority: P0
M14.9 | 14 · Regulatory and authorization strategy | Are there customer, contract or regulatory restrictions on payload? |  | Initial tests should use an inert, securely retained payload when payload mass is needed for balance/performance evaluation. Do not carry dangerous goods or drop material in Open-category operations. Medical products, biological samples or towing/release systems shall be separately assessed for packaging, safety, privacy, cargo classification and operational authorization. | Needs input | Priority: P0
M14.10 | 14 · Regulatory and authorization strategy | Which registrations, qualifications and authorizations have already been obtained? |  | Current UAS-operator registration, remote-pilot qualifications, insurance, airspace permissions and operational authorizations have not been evidenced and must not be marked obtained. Prior to flight, verify and record each applicable registration, qualification, insurance obligation and permission for the chosen operation. | Needs input | Priority: P0
M15.1 | 15 · Mission success and validation | What exact event marks successful completion of a mission? |  | For the first prototype, a test mission is successful when the preapproved test-card objectives and acceptance criteria are met, the aircraft remains inside the permitted operating area, it is recovered without unacceptable damage or safety event, and required flight data are available for review. Commercial mission completion will require a separate payload-delivery definition. | Needs input | Priority: P0
M15.2 | 15 · Mission success and validation | What is the maximum acceptable mission duration? |  | No universal maximum mission duration is approved for the prototype. Each test flight shall specify a planned duration and a latest safe recovery time based on weather, demonstrated energy/fuel endurance, visibility and contingency reserve. The former one-hour advertising scenario is not a validated general endurance requirement. | Needs input | Priority: P0
M15.3 | 15 · Mission success and validation | What is the required payload outcome or mission output? |  | Initial prototype test outcomes are engineering measurements (stable controllable flight, logged telemetry, propulsion/control performance, landing/recovery and as applicable inert payload carriage). A 3 kg payload is a preliminary sizing assumption, not a confirmed flight-test load. The actual mission-service output shall be specified after selecting the reference mission. | Needs input | Priority: P0
M15.4 | 15 · Mission success and validation | What accuracy, quality or condition of the delivered output is required? |  | Required accuracy and quality shall be stated as numerical acceptance tolerances in each approved test card: e.g., measured airspeed/altitude tracking, route containment, control response, payload retention and sensor data quality as relevant. No numerical tolerance is approved yet, so none shall be invented in this baseline. | Needs input | Priority: P0
M15.5 | 15 · Mission success and validation | What mission completion reliability is required? |  | No statistical mission-success reliability target has yet been established. During early prototype flights, prioritize no unacceptable safety event and fully documented execution of test objectives. After sufficient representative tests, calculate measured completion rate and set a mission-reliability target appropriate to the commercial use case. | Needs input | Priority: P0
M15.6 | 15 · Mission success and validation | Under which operating conditions must mission success be demonstrated? |  | Initial validation is proposed in daylight, dry weather, VLOS with a designated pilot/observer, a suitable isolated site and environmental conditions within approved test limits. The preliminary proposed limits are +10 to +30 °C, sustained wind <=3 m/s and gusts <=5 m/s, but these are NOT demonstrated limits; later envelope expansion requires planned tests. | Needs input | Priority: P0
M15.7 | 15 · Mission success and validation | Which events count as mission failure? |  | Mission failure includes failure to meet mandatory approved test objectives, uncontrolled departure from the operating area, inability to maintain required control, serious safety events, loss of required mission evidence, and any event that invalidates the planned test results. Record safety outcomes separately from mission-performance outcomes. | Needs input | Priority: P0
M15.8 | 15 · Mission success and validation | Which outcomes count as safe but incomplete missions? |  | A safe but incomplete mission includes a deliberate early return or landing due to weather, low energy, telemetry limitation, equipment warning or pilot judgment, where the aircraft remains under safe control and no unacceptable event occurs. Record it as 'safely aborted/incomplete', not as successful mission completion. | Needs input | Priority: P0
M15.9 | 15 · Mission success and validation | What evidence proves mission success (logs, payload records, customer sign-off, etc.)? |  | Evidence shall include an approved flight-test card, pre-flight checklist, aircraft configuration and mass/CG record, onboard and ground telemetry logs, observed weather, crew sign-off, payload measurements where relevant, post-flight inspection, anomalies, and test-review approval. Preserve source files linked to the Git revision/aircraft ID. | Needs input | Priority: P0
M16.1 | 16 · Constraints, assumptions and approval | What are the non-negotiable project constraints? | Below 15 kg MTOW and below 3 m wingspan previously proposed, not approved. | Non-negotiable constraints for the prototype are compliance with applicable flight rules/authorizations, keeping risk to third parties within the accepted limits, a controllable and inspectable aircraft, and no flight with unresolved critical faults. The previously discussed limits of <15 kg MTOW and <3 m wingspan are CANDIDATE requirements only; the sizing study uses 15 kg and 3.027 m, so neither is approved as met. | Needs input | Priority: P0
M16.2 | 16 · Constraints, assumptions and approval | What are preferred but negotiable design targets? |  | Preferred but negotiable targets are low structural mass, cost-effective additive manufacturing, compact transport packaging, removable modular assemblies, maintainability, sufficient endurance/payload capacity, and future upgradeability. These preferences shall not override verified safety, operational eligibility or mandatory performance requirements. | Needs input
M16.3 | 16 · Constraints, assumptions and approval | What unit-cost or development-budget objectives constrain the design? |  | No approved development budget or production unit-cost target is available. Track prototype material, motors, servos, avionics, printing time, tooling and testing costs in a controlled cost register, and establish a target unit cost only after the primary commercial mission and production assumptions are selected. | Needs input
M16.4 | 16 · Constraints, assumptions and approval | What development and deployment milestones must be achieved? |  | Proposed gates: mission/ConOps baseline; system requirements review; preliminary design review; detailed design and mass/CG closure; ground integration; safety/test readiness review; incremental VLOS flight testing; mission validation. Future BVLOS/commercial authorization and operational deployment shall be a separate later gate. | Needs input
M16.5 | 16 · Constraints, assumptions and approval | Which assumptions are still unvalidated? |  | Unvalidated assumptions include final mission/payload; 15 kg mass objective; study span of 3.027 m versus sub-3 m target; estimated 14.220 kg summed component mass; CG determination; LW-PLA print strength and creep; propulsion/VTOL configuration; selected autopilot and link; control authority; endurance; environmental limits; site and landing feasibility. | Needs input
M16.6 | 16 · Constraints, assumptions and approval | Which technologies or components are mandatory? |  | The six-subsystem decomposition and SolidWorks/Git workflow are established project practices. A V-tail, LW-PLA printed structure and KingMax DCS2016SP servos have been used or chosen for the prototype design, but no particular brand, material or technology should be declared mandatory until architecture trade-offs and tests are approved. | Needs input
M16.7 | 16 · Constraints, assumptions and approval | Which future capabilities must be accommodated now? | Future BVLOS C2 link and possible upgraded servos discussed. | Preserve reasonable integration provisions for a future BVLOS C2 system, alternative servos, modular payloads, telemetry/data logging and maintenance access. Where feasible, reserve mechanical volume, power budget, interfaces and software integration boundaries; do not incur unverified cost/mass penalties for every speculative future feature. | Needs input
M16.8 | 16 · Constraints, assumptions and approval | Which trade-offs are acceptable or unacceptable? |  | Trade-offs may be considered between mass, manufacturability, cost, mission duration, modularity and turnaround, subject to tested compliance. Trade-offs are unacceptable if they compromise third-party safety, approved flight envelope, essential control/failsafe functions, structural integrity or legal operating conditions. All major trades need documented criteria and decision authority. | Needs input
M16.9 | 16 · Constraints, assumptions and approval | Who will approve the Mission & ConOps baseline? |  | The Mission & ConOps baseline should be approved by ORGOfly's designated engineering/project authority, with operational safety acceptance by the designated UAS operator/flight-test authority. Each approval shall record name/role, revision, date, unresolved restrictions and the next review trigger. Actual approvers have not been named. | Needs input | Priority: P0

Sheet: KNOWN BASELINE
Known project information
Earlier project discussions are evidence of design work, not automatically approved requirements.
ID | Topic | Earlier discussion | Status | Source | Needed confirmation
OBS-001 | Aircraft configuration | Fixed-wing UAV with V-tail modeled | In development | 2026 project CAD discussions | Confirm configuration/actual CAD revision
OBS-002 | Wingspan | Below 3 m discussed as target | Candidate | 2026-09-11 wingspan discussion | Confirm binding limit and current geometry
OBS-003 | MTOW | Below 15 kg discussed as target | Candidate | 2026-09-09 to 2026-09-11 regulatory context | Confirm binding mass limit and mass budget
OBS-004 | Medical transport mission | Hospital-to-hospital operations and BVLOS explored | Candidate | 2026-09-09 regulatory discussion | Choose mission priority
OBS-005 | Advertising mission | Banner towing and one-hour flights explored | Candidate | 2026-08-22 advertising research | Choose mission priority
OBS-006 | Operating region | Bulgaria/EU context and Sofia use cases discussed | In development | 2026-08/09 regulatory discussions | Specify sites and airspace
OBS-007 | Propulsion concept | Rotating propulsion mechanism / VTOL concepts explored | In development | 2026-09-22 servo discussion | Confirm flight-mode and propulsion architecture
OBS-008 | Structures | LW-PLA printed shell, rib supports, 0.8/1.0 mm wall options | In development | 2026-08 to 2026-10 CAD/printing discussions | Link analysis, as-built masses, revision
OBS-009 | Avionics | RadioMaster, XR4/RP4TD and Cube/Pixhawk explored | In development | 2026-09/10 avionics discussions | Confirm installed equipment
OBS-010 | Servo choice | KingMax DCS2016SP selected for prototype; S40S future option | Candidate | 2026-09-22 servo discussion | Confirm purchase, application and torque sizing
OBS-011 | System decomposition | Six onboard systems: Fuselage, Wing and Tail, Propulsion, Landing, Avionics, Payload | Confirmed intent | User message 2026-11-08 | Model as aircraft BDD and interfaces
OBS-012 | CAD management | SolidWorks, Git/Git LFS workflow and split CAD assemblies | In development | 2026-10-24 through 2026-10-28 Git discussions | Identify approved reference commit
OBS-013 | Wing geometry | NACA 2412 reference used in CAD; V-tail modeled | In development | 2026-08/09 CAD conversations | Confirm actual airfoil and wing parameters
OBS-014 | Internal ribs | 0.8 mm mid-plane supports; 0.4 mm alternative discussed; ~50 mm spacing | In development | 2026-10-24 structural trade discussion | Link current CAD configuration and tests

Sheet: DECISION LOG
Decision log
Record important design decisions, supporting evidence and approval. Keep superseded decisions in the revision history.
ID | Topic | Options / context | Status | Your decision | Rationale / evidence | Approver | Date | Affected question IDs
DEC-001 | Primary mission | Medical transport / banner towing / multipurpose platform | Open |  |  |  |  | M01.4, M01.5, M05.6
DEC-002 | Prototype vs commercial purpose | Prototype test mission may differ from commercial use | Open |  |  |  |  | M01.4, M01.5
DEC-003 | Aircraft operating architecture | Conventional fixed wing / VTOL hybrid | Open |  |  |  |  | M04.1, M06.12
DEC-004 | Propulsion rotation | Fixed / rotating propulsion | Open |  |  |  |  | M04.3
DEC-005 | Takeoff and landing method | Not confirmed | Open |  |  |  |  | M04.4, M04.5
DEC-006 | Wingspan limit | Below 3 m discussed | Open |  |  |  |  | M04.7, M08.9
DEC-007 | MTOW limit | Below 15 kg discussed | Open |  |  |  |  | M04.8, M08.8
DEC-008 | Primary payload | Medical cargo / advertising banner / other | Open |  |  |  |  | M09.1, M09.2
DEC-009 | Prototype airspace and environment | Bulgaria discussed; exact site not selected | Open |  |  |  |  | M07.1, M07.5
DEC-010 | Commercial operational category | Open vs Specific, VLOS vs BVLOS, authorization route | Open |  |  |  |  | M14.3, M14.4, M14.7
DEC-011 | Ground-system boundary | UAV only vs full UAS within engineering system | Open |  |  |  |  | M03.1
DEC-012 | Flight-controller hardware | Cube/Pixhawk explored, no final configuration known | Open |  |  |  |  | M10.7
DEC-013 | Communication architecture | RadioMaster hardware explored; BVLOS C2 not finalized | Open |  |  |  |  | M10.6
DEC-014 | Reference CAD revision | Version-controlled SolidWorks files; current approved commit missing | Open |  |  |  |  | M04.10
DEC-015 | Loss-of-link concept | No approved operational response | Open |  |  |  |  | M10.4, M13.1
DEC-016 | Chapter approval authority | Responsible engineering approver to be assigned | Open |  |  |  |  | M16.9
