NikolaNikolow/ORGOfly-CAD-model/P01/P01_06_Procurement/Invoices_MV_260810_119,73€/OrderSummary202608103075205682025486.png

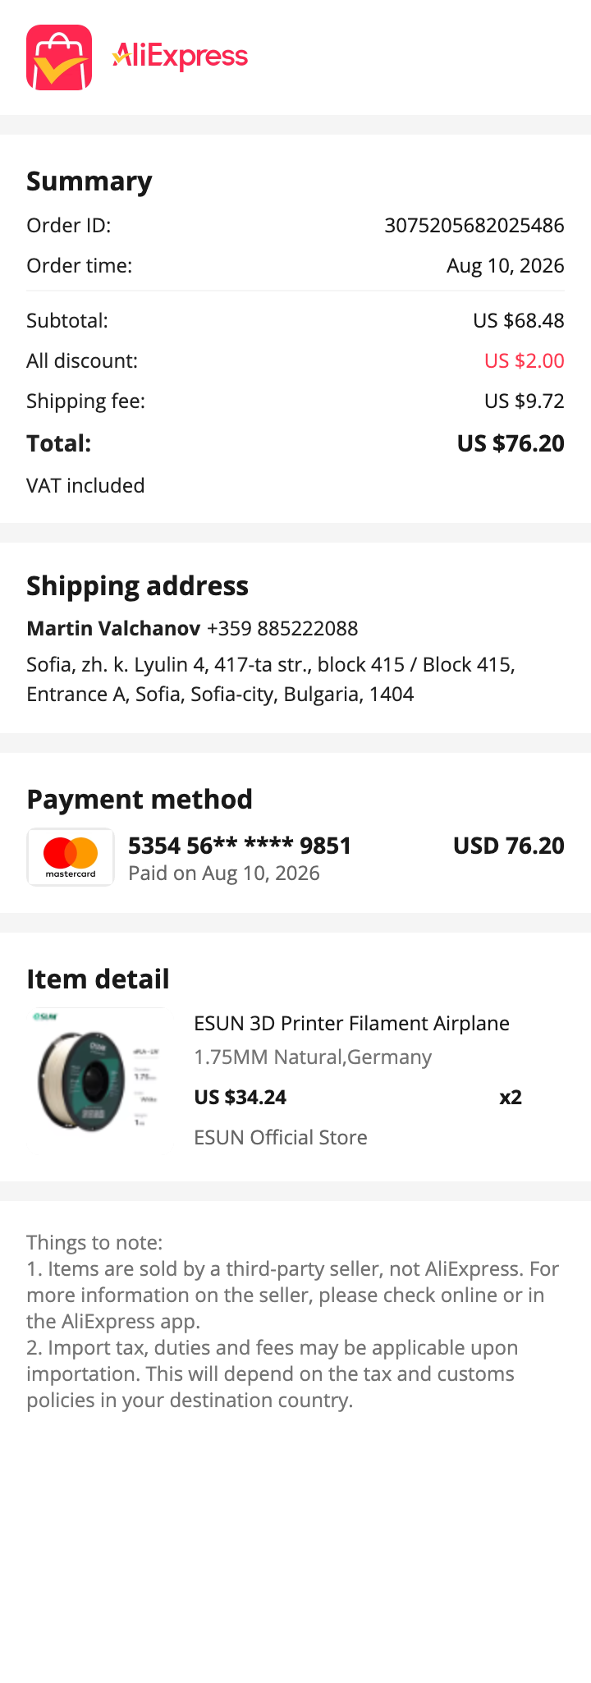
P01/P01_06_Procurement/Invoices_MV_260810_119,73€/OrderSummary202608103075205682025486.png
