NikolaNikolow/ORGOfly-CAD-model/P01/P01_06_Procurement/Invoices_MV_261009_924.84EUR/Aliexpress/OrderSummary202610093076967070785486.png

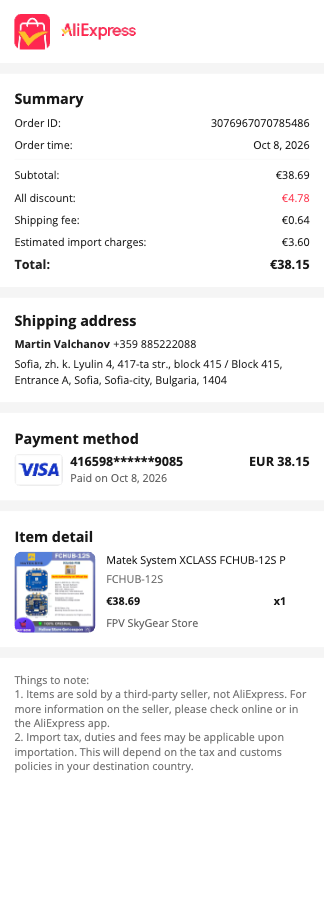
P01/P01_06_Procurement/Invoices_MV_261009_924.84EUR/Aliexpress/OrderSummary202610093076967070785486.png
