NikolaNikolow/ORGOfly-CAD-model/P01/P01_06_Procurement/Invoices_MV_261009_924.84€/Aliexpress/OrderSummary202610093077310955425486.png

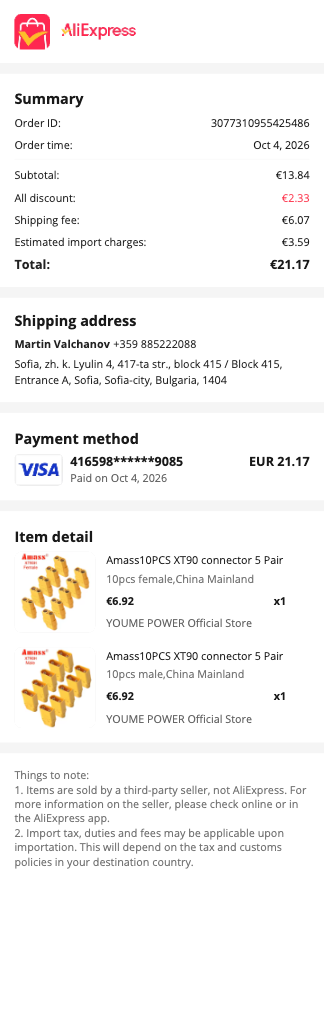
P01/P01_06_Procurement/Invoices_MV_261009_924.84€/Aliexpress/OrderSummary202610093077310955425486.png
