NikolaNikolow/ORGOfly-CAD-model/P01/P01-50_Propulsion/P01-50-04_Tail_RH/Avenger_3210-500KV.SLDASM

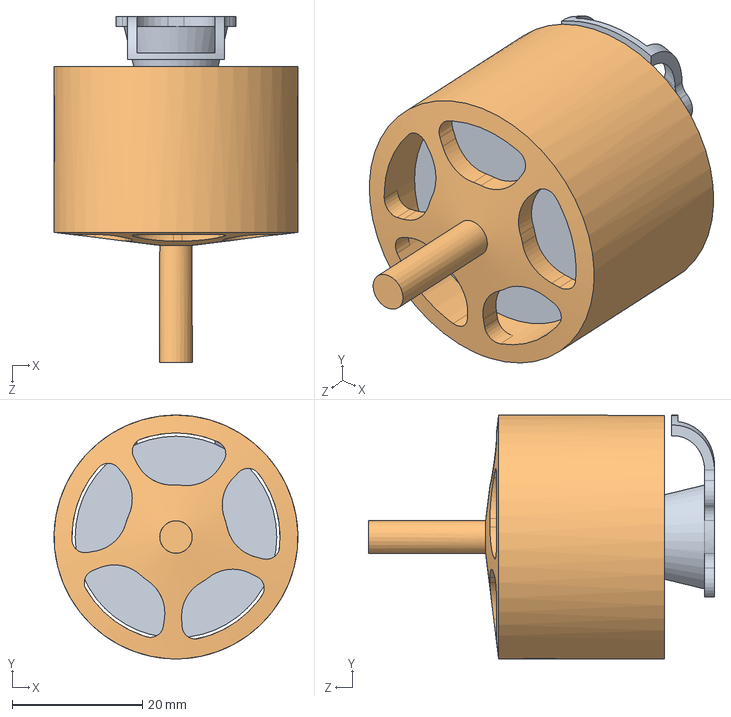
[picture p33: CAD file, 2026-07-20]
P01/P01-50_Propulsion/P01-50-04_Tail_RH/Avenger_3210-500KV.SLDASM
37.5 x 37.5 x 53.2 mm
Avenger_3210-500KV_Stator
Avenger_3210-500KV_Rotor
