NikolaNikolow/ORGOfly-CAD-model/P01/P01-20_Fuselage/P01-20-01_Skin/P01-20-01-22_260929_S08_Tail_Whole.SLDPRT

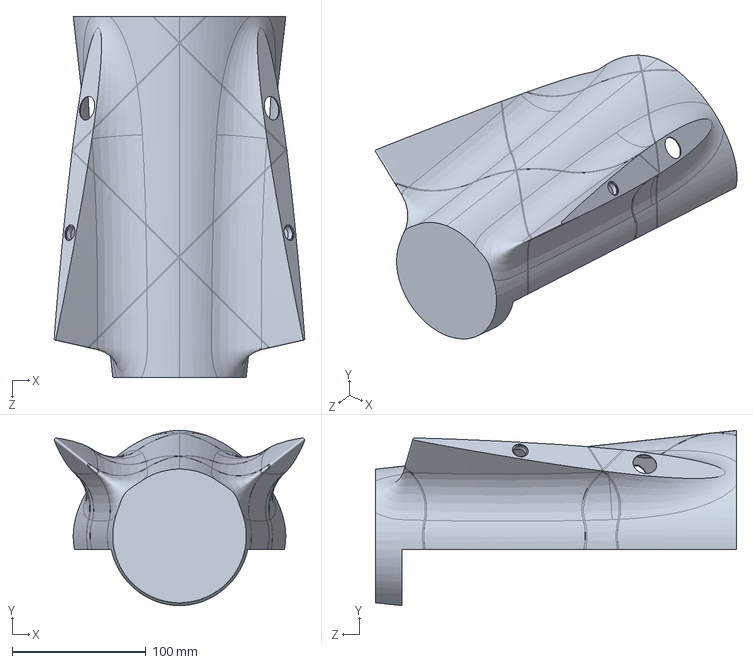
[picture p34: CAD file, 2026-09-29]
P01/P01-20_Fuselage/P01-20-01_Skin/P01-20-01-22_260929_S08_Tail_Whole.SLDPRT
187.5 x 131.1 x 270.0 mm
