NikolaNikolow/ORGOfly-CAD-model/P01/P01-20_Fuselage/P01-20-01_Skin/P01-20-01-03_260929_S01_Nose_Whole.SLDPRT

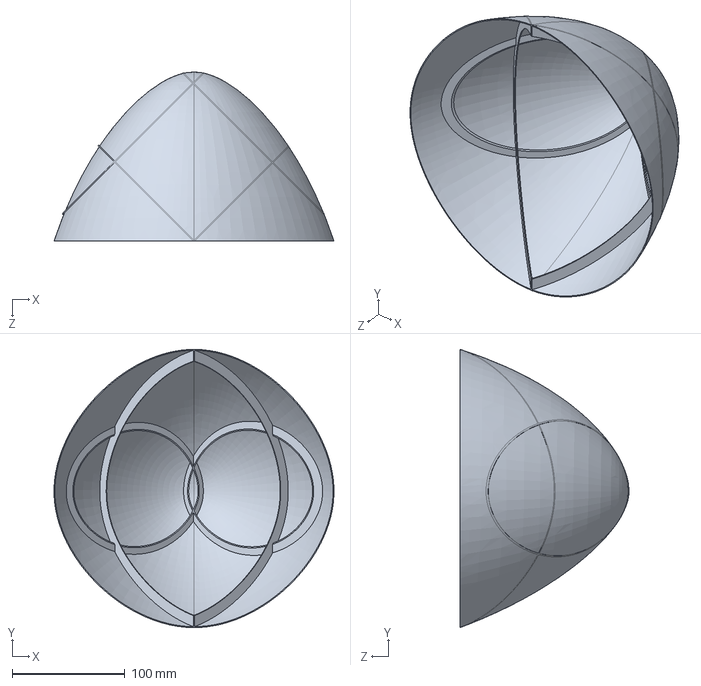
[picture p35: CAD file, 2026-09-29]
P01/P01-20_Fuselage/P01-20-01_Skin/P01-20-01-03_260929_S01_Nose_Whole.SLDPRT
248.4 x 247.0 x 150.0 mm
