NikolaNikolow/ORGOfly-CAD-model/0_CADModel_FreeCAD/ORGOfly-BodyPad.step

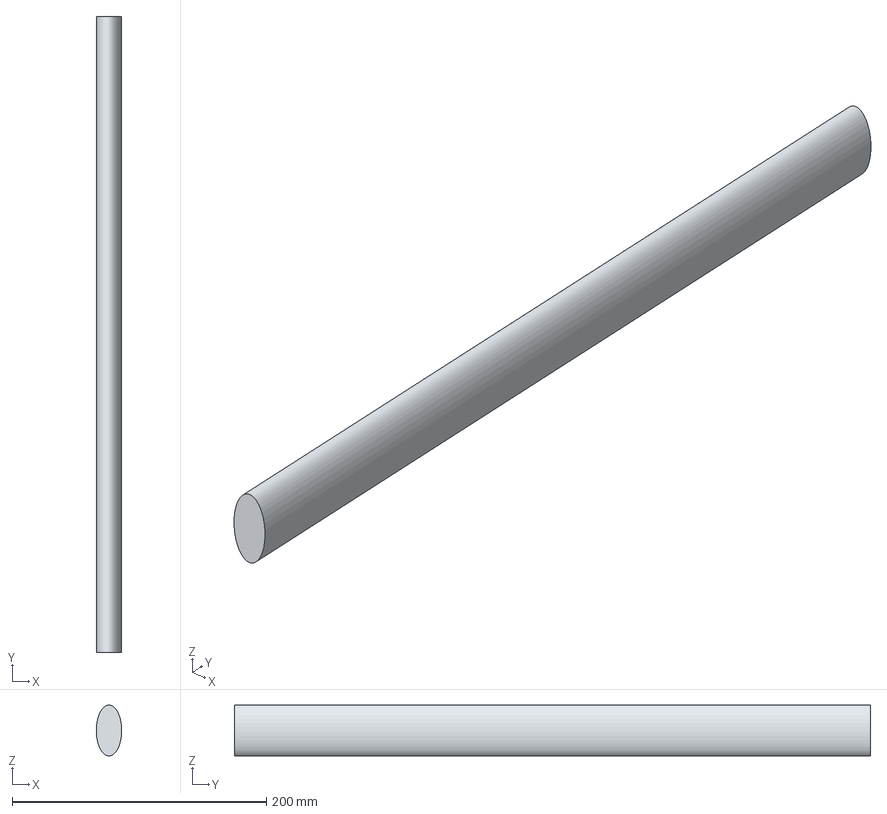
[picture p36: CAD file, 2026-03-08]
0_CADModel_FreeCAD/ORGOfly-BodyPad.step
20.0 x 500.0 x 40.0 mm
