NikolaNikolow/ORGOfly-CAD-model/1_ORGO-15_P1/1_CAD_model/NACA2412/NACA2412_3Dmodel_test.SLDPRT

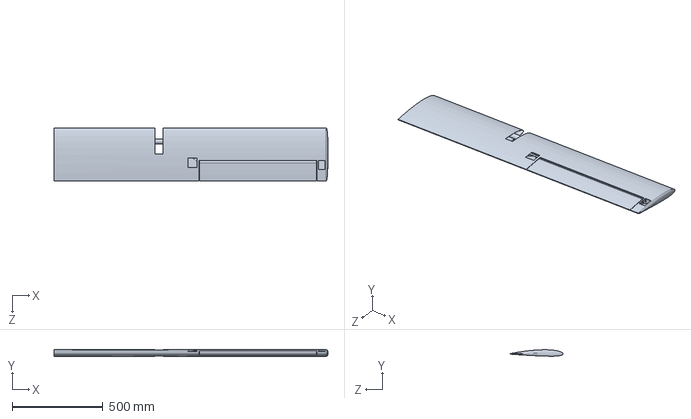
[picture p37: CAD file, 2026-06-27]
1_ORGO-15_P1/1_CAD_model/NACA2412/NACA2412_3Dmodel_test.SLDPRT
1510.0 x 36.4 x 293.2 mm
