NikolaNikolow/ORGOfly-CAD-model/1_ORGO-15_P1/1_CAD_model/ORGO_Fuselage/Fuselage_v1.4_ANI.SLDPRT

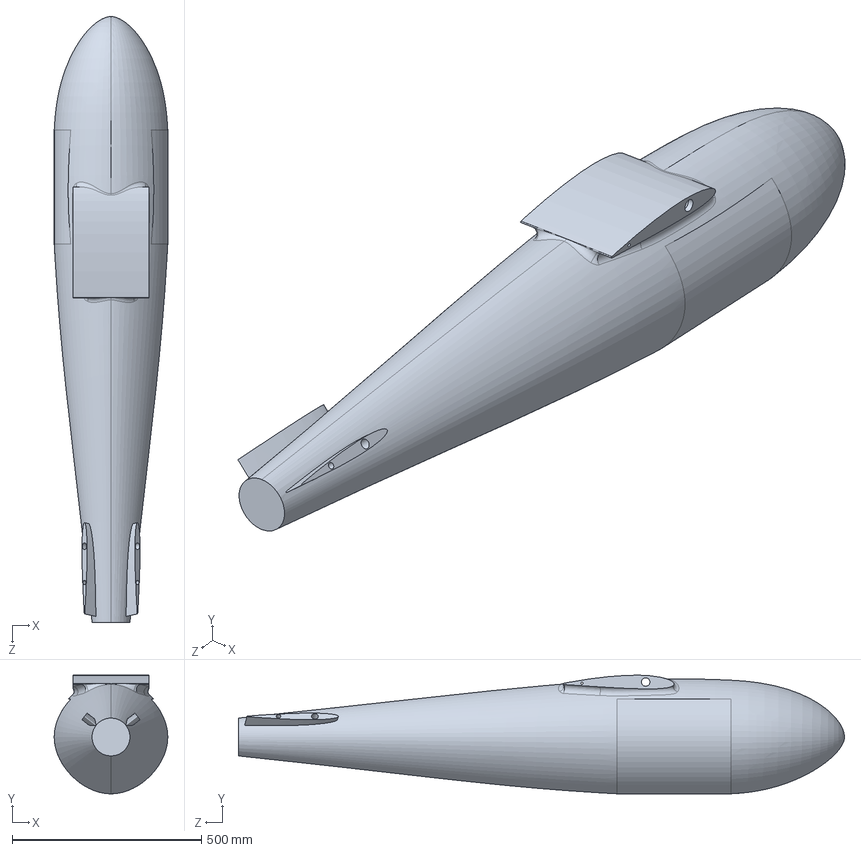
[picture p38: CAD file, 2026-07-02]
1_ORGO-15_P1/1_CAD_model/ORGO_Fuselage/Fuselage_v1.4_ANI.SLDPRT
300.0 x 313.3 x 1600.0 mm
