NikolaNikolow/ORGOfly-CAD-model/1_ORGO-15_P1/1_CAD_model/ORGO_Tilting_Mechanism/Tail v2/Right Hand/Lower_Fairing_Тail_RH_v2.SLDPRT

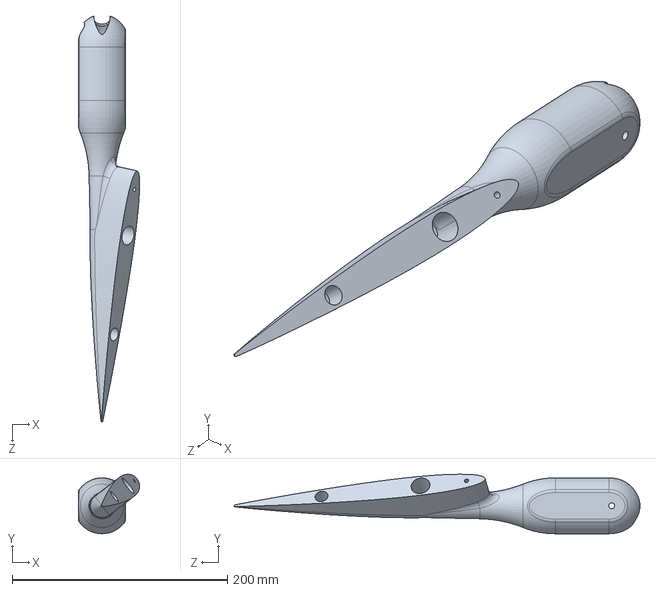
[picture p39: CAD file, 2026-07-16]
1_ORGO-15_P1/1_CAD_model/ORGO_Tilting_Mechanism/Tail v2/Right Hand/Lower_Fairing_Тail_RH_v2.SLDPRT
57.0 x 55.4 x 377.6 mm
