NikolaNikolow/ORGOfly-CAD-model/1_Solid_CAD_Model/15 kg version/NACA2412/NACA2412_3Dmodel_wing_with_aileron_trial.SLDPRT

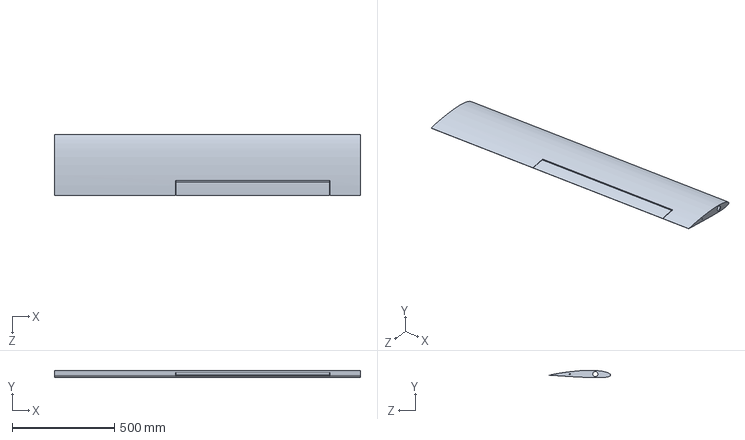
[picture p40: CAD file, 2026-05-24]
1_Solid_CAD_Model/15 kg version/NACA2412/NACA2412_3Dmodel_wing_with_aileron_trial.SLDPRT
1500.0 x 36.4 x 300.0 mm
