NikolaNikolow/ORGOfly-CAD-model/1_Solid_CAD_Model/15 kg version/ORGO_Design/Horizontail Tail.SLDPRT

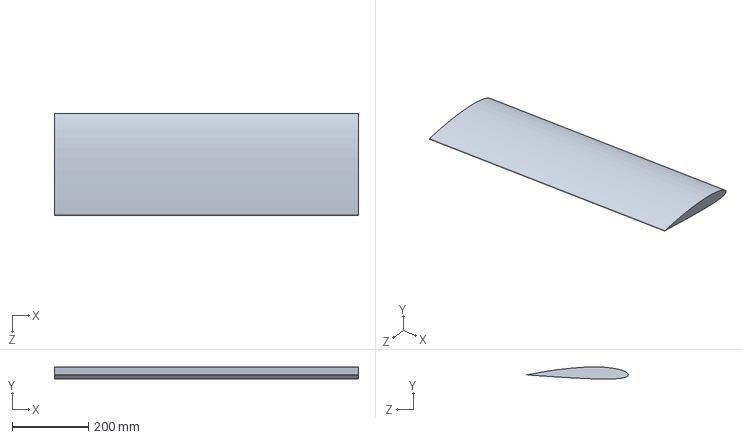
[picture p41: CAD file, 2026-03-07]
1_Solid_CAD_Model/15 kg version/ORGO_Design/Horizontail Tail.SLDPRT
800.0 x 32.2 x 267.4 mm
