NikolaNikolow/ORGOfly-CAD-model/P01/P01-90_Simulations/Payload Bay/P01-90-01-09_261018_Firewall_SIM.STL

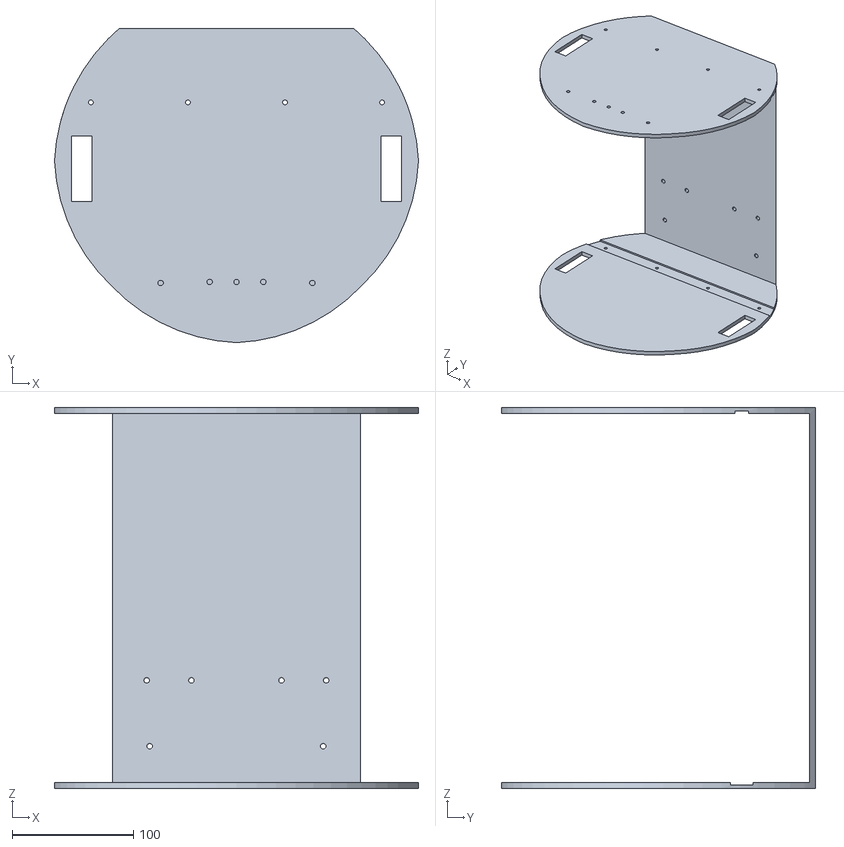
[picture p42: CAD file, 2026-10-20]
P01/P01-90_Simulations/Payload Bay/P01-90-01-09_261018_Firewall_SIM.STL
300.0 x 259.0 x 314.0
