NikolaNikolow/ORGOfly-CAD-model/P01_CAD/P01-30_Wing/P01-30-02_Wing_RH/P01-30-02-05_260724_Wing_Section_RH.SLDPRT

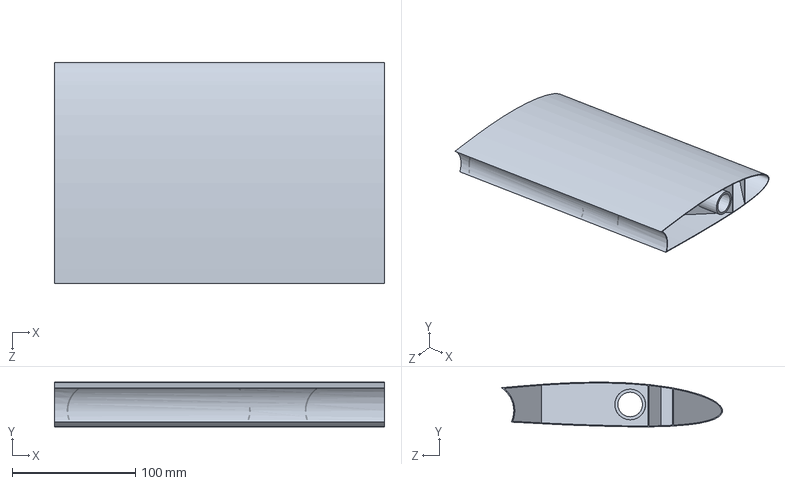
[picture p44: CAD file, 2026-07-24]
P01_CAD/P01-30_Wing/P01-30-02_Wing_RH/P01-30-02-05_260724_Wing_Section_RH.SLDPRT
268.0 x 36.5 x 179.6 mm
