NikolaNikolow/ORGOfly-CAD-model/P01_CAD/P01-40_Tail/P01-40-02_Tail_RH/P01-40-02-02_260727_CF_Tube.SLDPRT

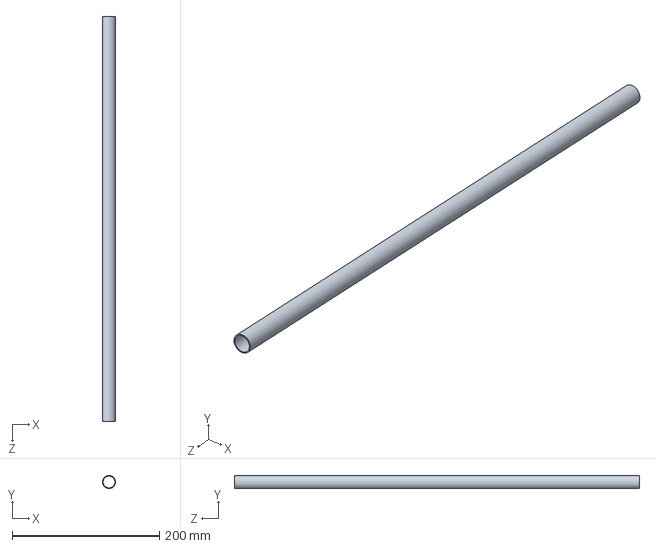
[picture p45: CAD file, 2026-07-27]
P01_CAD/P01-40_Tail/P01-40-02_Tail_RH/P01-40-02-02_260727_CF_Tube.SLDPRT
18.0 x 18.0 x 550.0 mm
