NikolaNikolow/ORGOfly-CAD-model/1_Solid_CAD_Model/15 kg version/ORGO_Design/Vertical Tail.SLDPRT

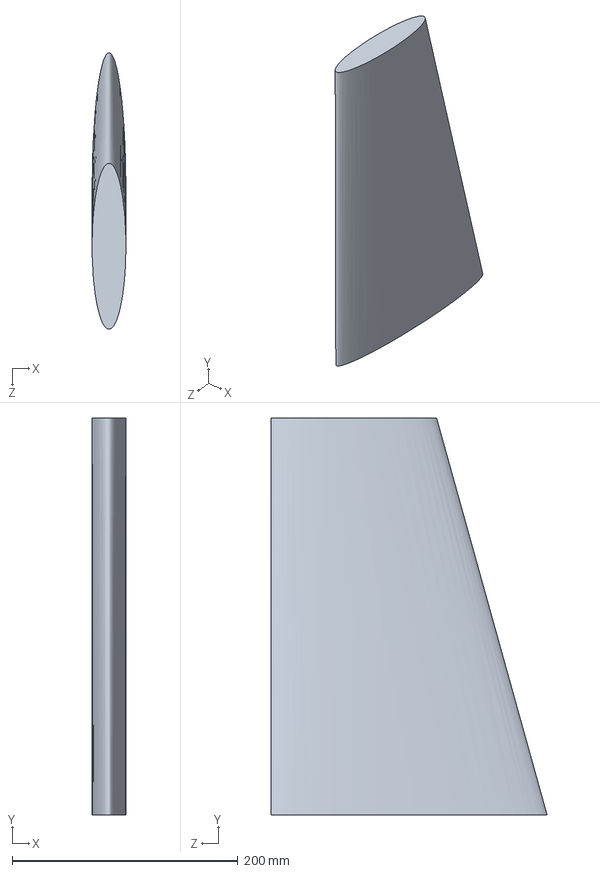
[picture p46: CAD file, 2026-03-07]
1_Solid_CAD_Model/15 kg version/ORGO_Design/Vertical Tail.SLDPRT
30.0 x 352.0 x 245.0 mm
