NikolaNikolow/ORGOfly-CAD-model/P01/P01-60_Landing/P01-60-01_FWD_LG/P01-60-01-01_261003_FWD_Beam.SLDPRT

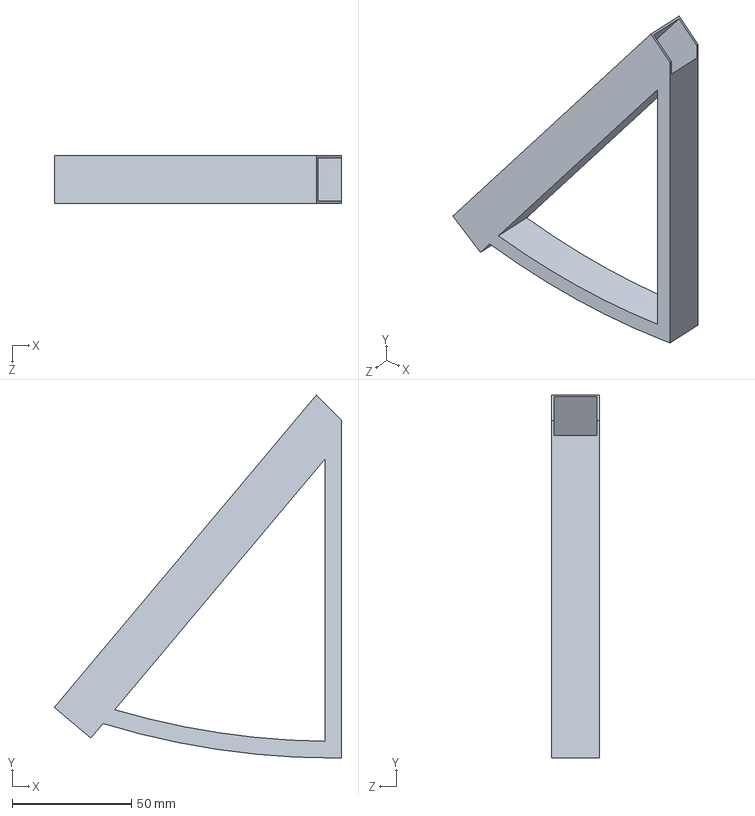
[picture p47: CAD file, 2026-10-04]
P01/P01-60_Landing/P01-60-01_FWD_LG/P01-60-01-01_261003_FWD_Beam.SLDPRT
120.4 x 152.1 x 20.0 mm
