NikolaNikolow/ORGOfly-CAD-model/P01/P01_05_Design/Landing Gear/FWD LG/Leafspring Compression SImulations/Leafpring_R125_t5_L150_w10.SLDPRT

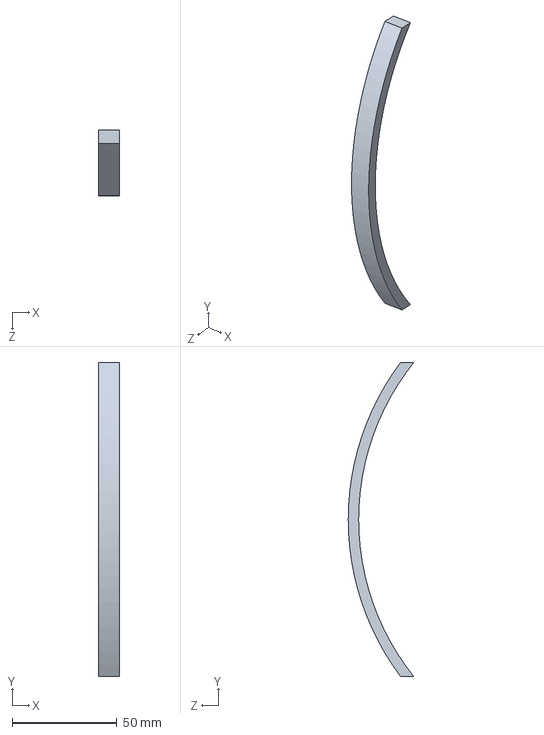
[picture p48: CAD file, 2026-10-04]
P01/P01_05_Design/Landing Gear/FWD LG/Leafspring Compression SImulations/Leafpring_R125_t5_L150_w10.SLDPRT
10.0 x 150.0 x 31.3 mm
