NikolaNikolow/ORGOfly-CAD-model/1_Solid_CAD_Model/15 kg version/ORGO_Design/Wing.SLDPRT

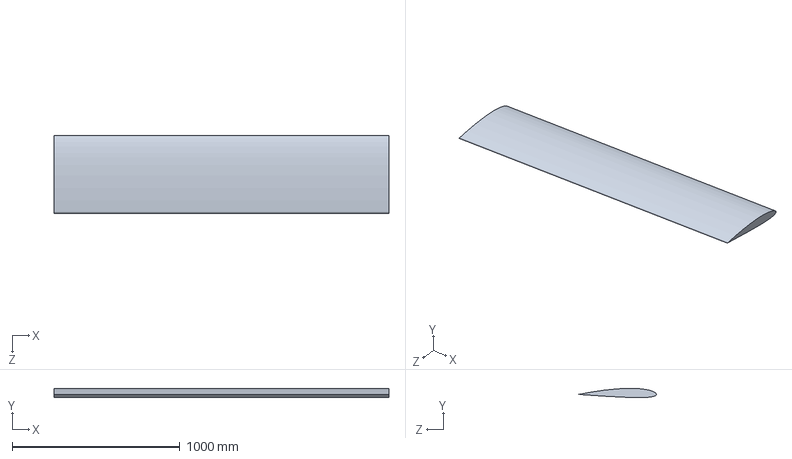
[picture p49: CAD file, 2026-03-07]
1_Solid_CAD_Model/15 kg version/ORGO_Design/Wing.SLDPRT
2000.0 x 55.7 x 464.1 mm
