NikolaNikolow/ORGOfly-CAD-model/P01/P01-40_Tail/P01-40-04_Elevon_RH/P01-40-04-01_260727_Lower_Elevon.SLDPRT

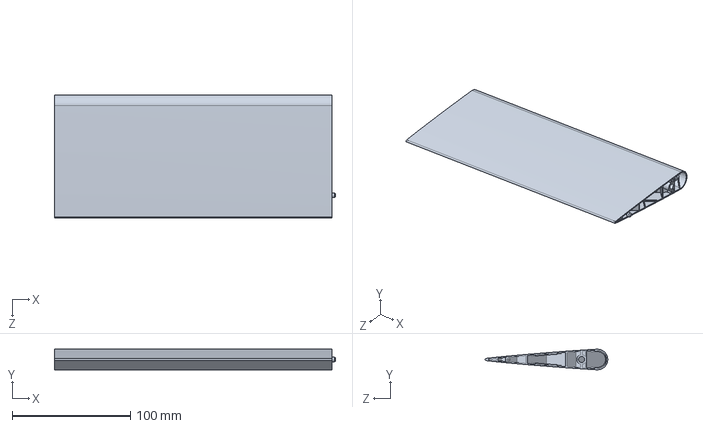
[picture p50: CAD file, 2026-10-23]
P01/P01-40_Tail/P01-40-04_Elevon_RH/P01-40-04-01_260727_Lower_Elevon.SLDPRT
237.5 x 17.6 x 103.8 mm
