NikolaNikolow/ORGOfly-CAD-model/P01/P01-50_Propulsion/P01-50-01_Main_LH/P01-50-01-01_260726_Lower_Fairing_LH.SLDPRT

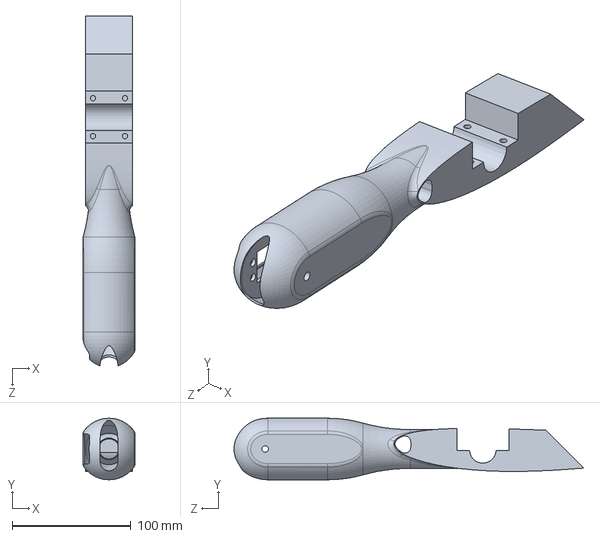
[picture p51: CAD file, 2026-08-24]
P01/P01-50_Propulsion/P01-50-01_Main_LH/P01-50-01-01_260726_Lower_Fairing_LH.SLDPRT
44.0 x 52.0 x 295.3 mm
