NikolaNikolow/ORGOfly-CAD-model/P01/P01-50_Propulsion/P01-50-03_Tail_LH/P01-50-03-01_261027_Lower_Fairing_LH_PRINT.STEP

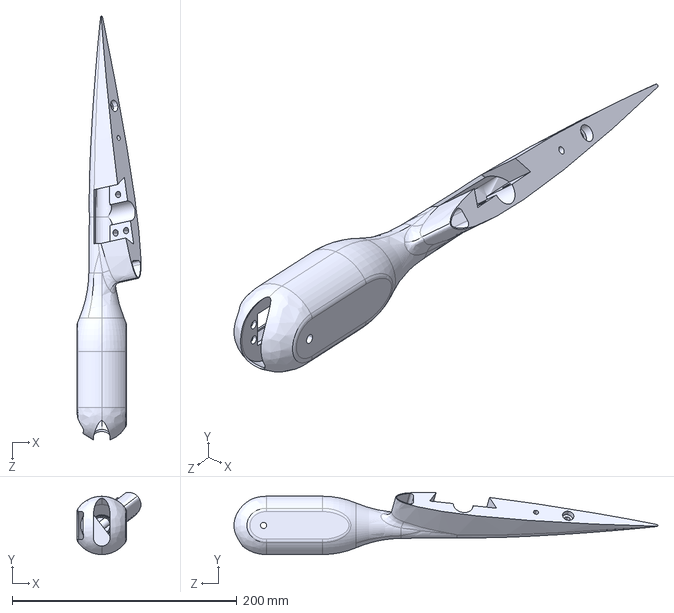
[picture p52: CAD file, 2026-10-27]
P01/P01-50_Propulsion/P01-50-03_Tail_LH/P01-50-03-01_261027_Lower_Fairing_LH_PRINT.STEP
56.9 x 55.4 x 377.6 mm
