NikolaNikolow/ORGOfly-CAD-model/P01/P01-60_Landing/P01-60-01_FWD_LG/P01-60-01-02_261003_FWD_Fork.SLDPRT

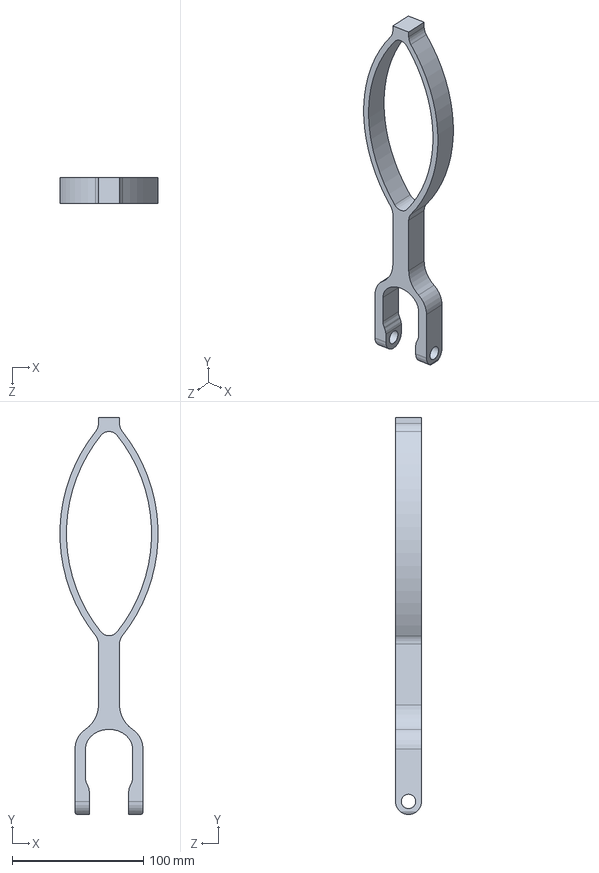
[picture p53: CAD file, 2026-10-04]
P01/P01-60_Landing/P01-60-01_FWD_LG/P01-60-01-02_261003_FWD_Fork.SLDPRT
74.8 x 303.0 x 20.0 mm
