NikolaNikolow/ORGOfly-CAD-model/1_Solid_CAD_Model/15 kg version/ORGO_Design/Body.SLDPRT

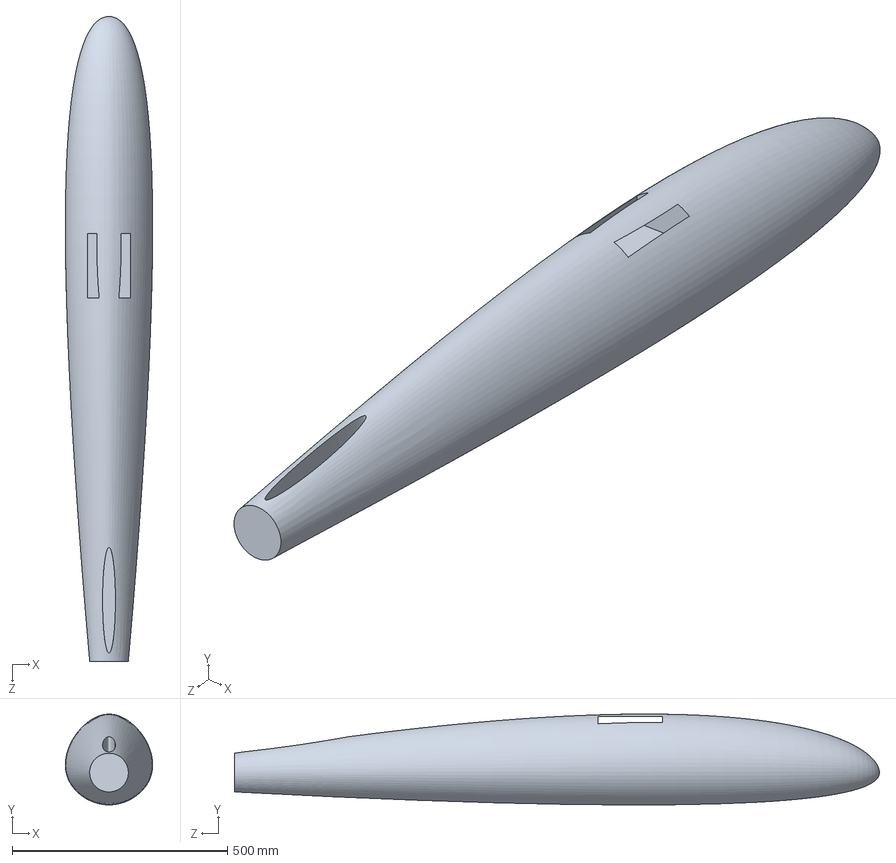
[picture p54: CAD file, 2026-03-07]
1_Solid_CAD_Model/15 kg version/ORGO_Design/Body.SLDPRT
203.0 x 211.5 x 1500.0 mm
