NikolaNikolow/ORGOfly-CAD-model/P01/P01-30_Wing/P01-30-03_Aileron_Rotation_Mechanism/Dummy_model_5_60_shaft.SLDPRT

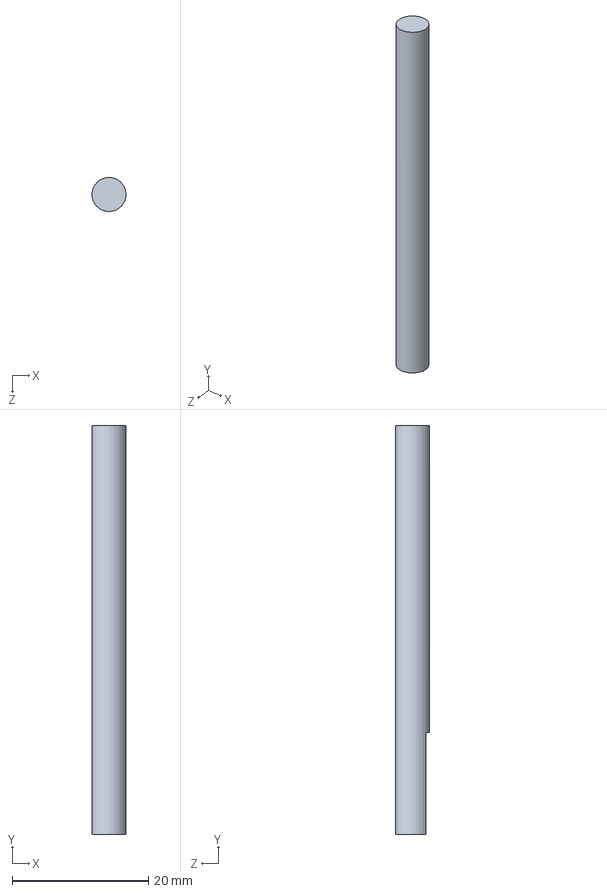
[picture p55: CAD file, 2026-09-22]
P01/P01-30_Wing/P01-30-03_Aileron_Rotation_Mechanism/Dummy_model_5_60_shaft.SLDPRT
4.99 x 60.0 x 5.00 mm
