NikolaNikolow/ORGOfly-CAD-model/P01/P01-40_Tail/P01-40-01_Tail_LH/P01-40-01-01_260727_Tailplane.SLDPRT

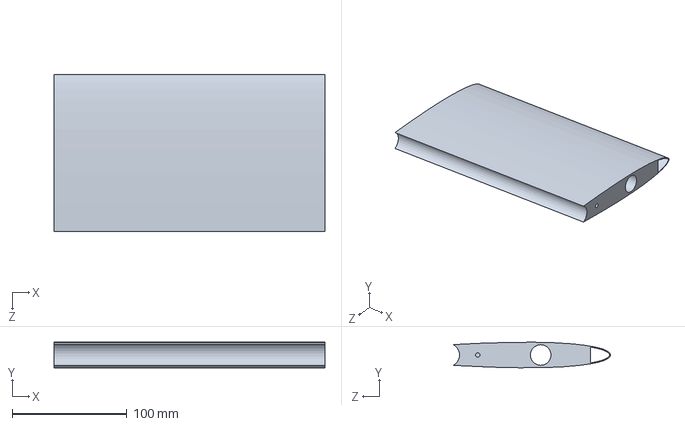
[picture p56: CAD file, 2026-10-04]
P01/P01-40_Tail/P01-40-01_Tail_LH/P01-40-01-01_260727_Tailplane.SLDPRT
236.5 x 22.3 x 137.3 mm
