NikolaNikolow/ORGOfly-CAD-model/P01/P01-40_Tail/P01-40-02_Tail_RH/P01-40-02-01_260824_Tailplane.SLDPRT

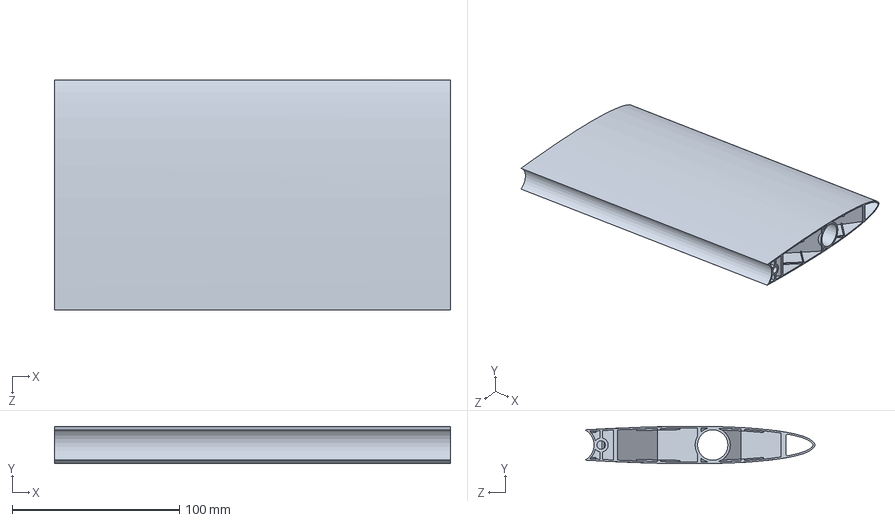
[picture p57: CAD file, 2026-10-23]
P01/P01-40_Tail/P01-40-02_Tail_RH/P01-40-02-01_260824_Tailplane.SLDPRT
236.5 x 22.4 x 137.3 mm
