NikolaNikolow/ORGOfly-CAD-model/P01/P01-40_Tail/P01-40-03_Elevon_LH/P01-40-03-01_260727_Lower_Elevon.SLDPRT

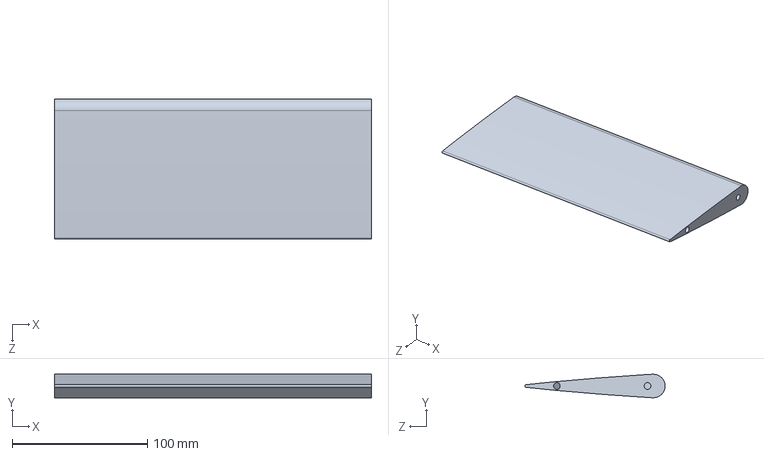
[picture p58: CAD file, 2026-07-25]
P01/P01-40_Tail/P01-40-03_Elevon_LH/P01-40-03-01_260727_Lower_Elevon.SLDPRT
234.5 x 17.6 x 103.8 mm
