NikolaNikolow/ORGOfly-CAD-model/P01/P01-40_Tail/P01-40-04_Elevon_RH/Threaded Insert M4 x 8.1mm.SLDPRT

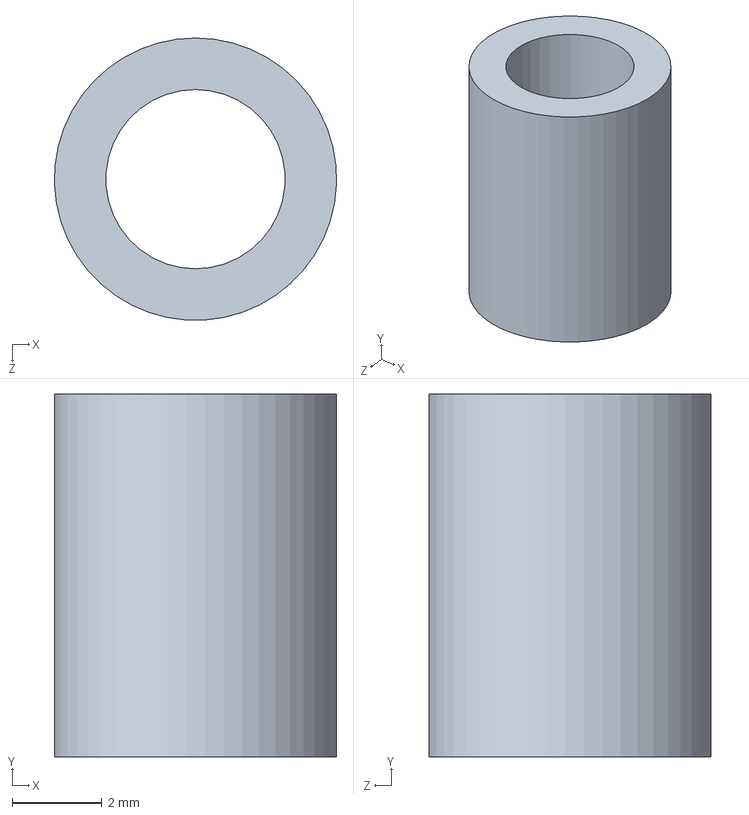
[picture p59: CAD file, 2026-10-23]
P01/P01-40_Tail/P01-40-04_Elevon_RH/Threaded Insert M4 x 8.1mm.SLDPRT
6.30 x 8.10 x 6.29 mm
