NikolaNikolow/ORGOfly-CAD-model/P01/P01-50_Propulsion/P01-50-01_Main_LH/P01-50-01-04_260726_NACA2412_Motor.SLDPRT

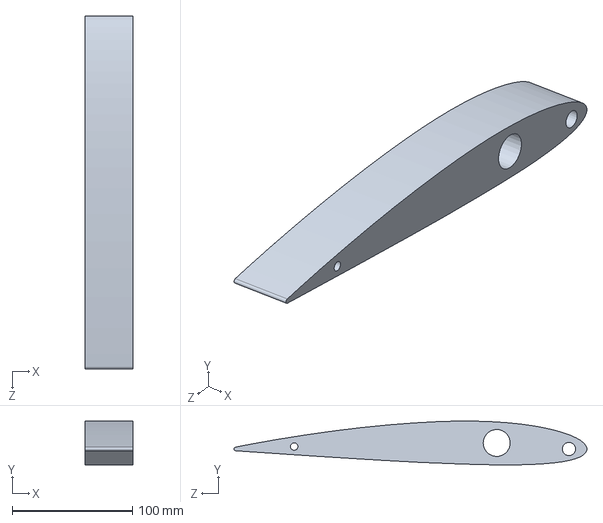
[picture p60: CAD file, 2026-07-26]
P01/P01-50_Propulsion/P01-50-01_Main_LH/P01-50-01-04_260726_NACA2412_Motor.SLDPRT
39.6 x 36.4 x 293.1 mm
