NikolaNikolow/ORGOfly-CAD-model/P01/P01-50_Propulsion/P01-50-02_Main_RH/P01-50-02-03_260726_Upper_Fairing_RH.SLDPRT

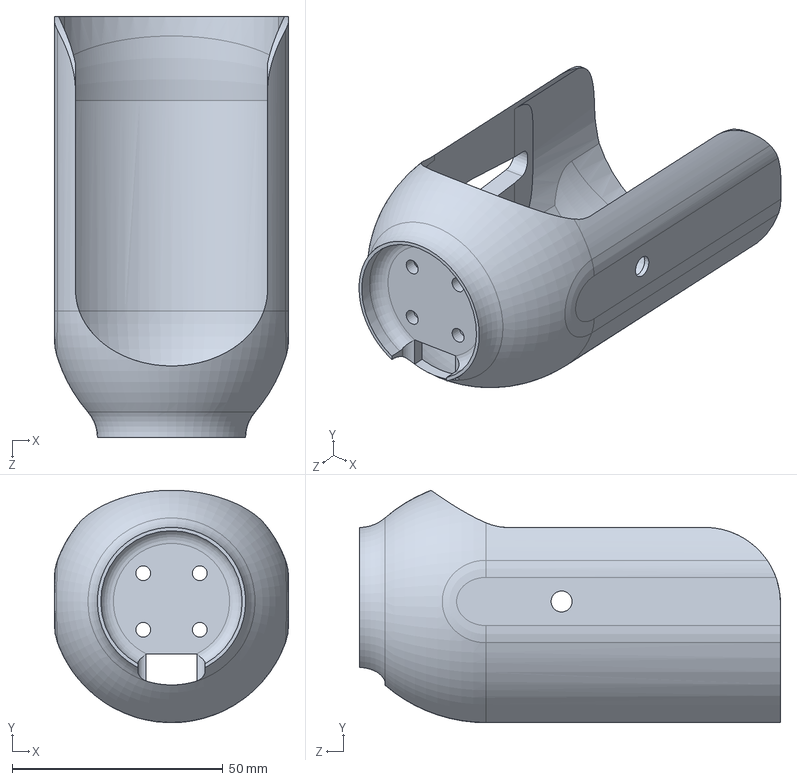
[picture p61: CAD file, 2026-07-26]
P01/P01-50_Propulsion/P01-50-02_Main_RH/P01-50-02-03_260726_Upper_Fairing_RH.SLDPRT
55.6 x 55.2 x 100.0 mm
