NikolaNikolow/ORGOfly-CAD-model/P01/P01-60_Landing/P01-60-01_FWD_LG/HomeMax_Kolelo_Plastmasovo_80x30mm.SLDPRT

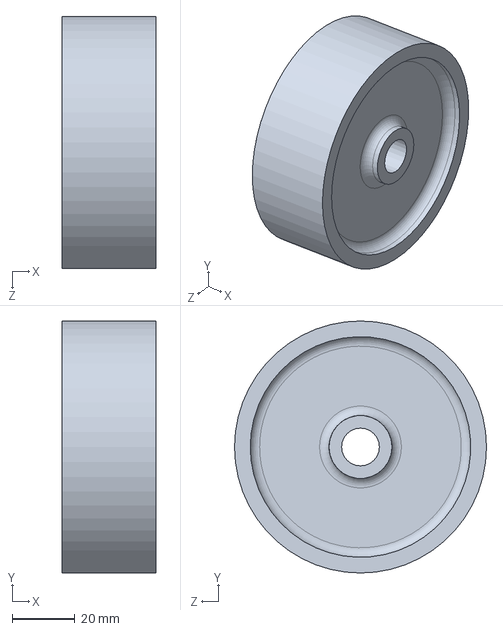
[picture p62: CAD file, 2026-10-03]
P01/P01-60_Landing/P01-60-01_FWD_LG/HomeMax_Kolelo_Plastmasovo_80x30mm.SLDPRT
30.0 x 80.0 x 80.0 mm
