NikolaNikolow/ORGOfly-CAD-model/P01/P01-30_Wing/P01-30-03_Aileron_Rotation_Mechanism/Dummy_model_servo_shaft_coupler.SLDPRT

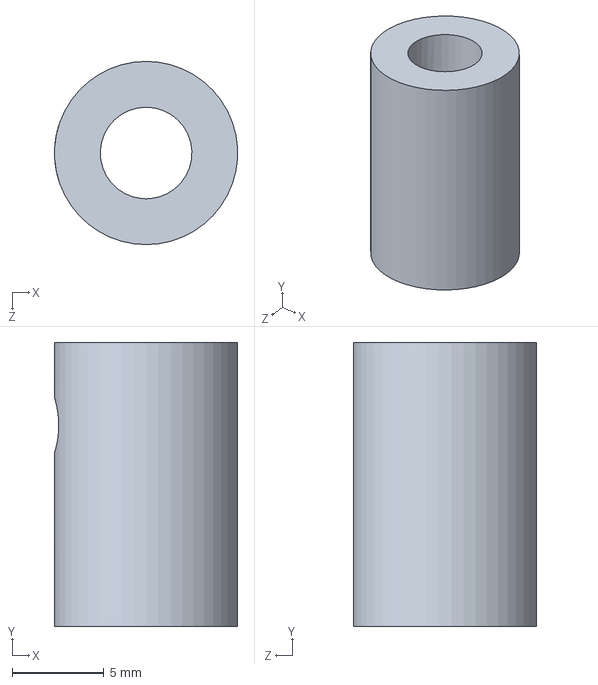
[picture p63: CAD file, 2026-09-06]
P01/P01-30_Wing/P01-30-03_Aileron_Rotation_Mechanism/Dummy_model_servo_shaft_coupler.SLDPRT
9.99 x 15.5 x 10.0 mm
