NikolaNikolow/ORGOfly-CAD-model/P01/P01-40_Tail/P01-40-02_Tail_RH/P01-40-02-100_NACA0009_V-tail_parent_file.SLDPRT

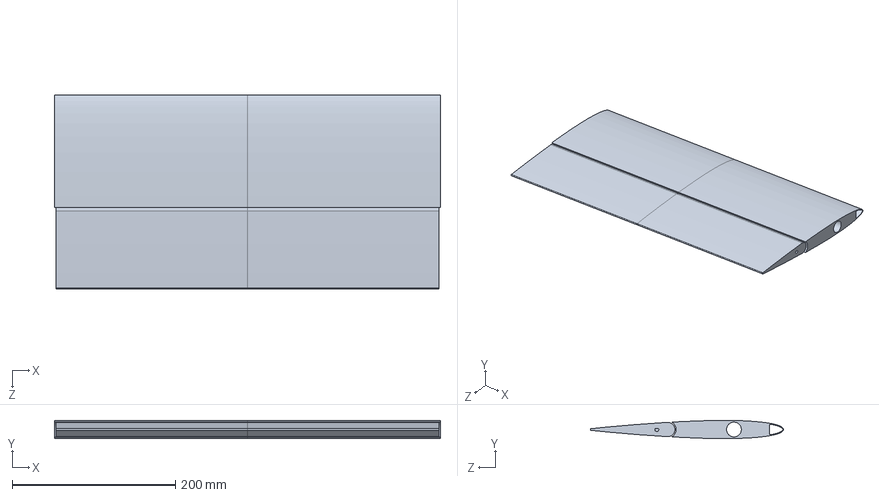
[picture p64: CAD file, 2026-10-23]
P01/P01-40_Tail/P01-40-02_Tail_RH/P01-40-02-100_NACA0009_V-tail_parent_file.SLDPRT
473.0 x 22.3 x 237.2 mm
