NikolaNikolow/ORGOfly-CAD-model/P01/P01-40_Tail/P01-40-03_Elevon_LH/P01-40-03-03_260727_Pin_Elevon.SLDPRT

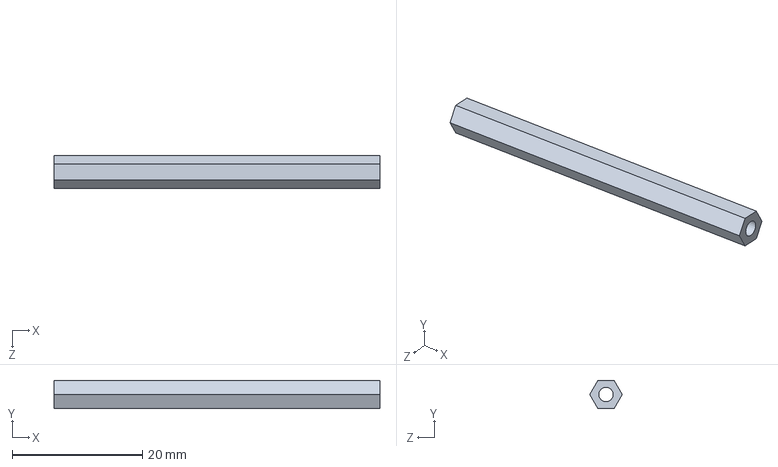
[picture p65: CAD file, 2026-07-24]
P01/P01-40_Tail/P01-40-03_Elevon_LH/P01-40-03-03_260727_Pin_Elevon.SLDPRT
50.0 x 4.33 x 5.00 mm
