NikolaNikolow/ORGOfly-CAD-model/P01/P01-50_Propulsion/P01-50-01_Main_LH/P01-50-01-02_260726_Lower_Fairing_Lid_LH.SLDPRT

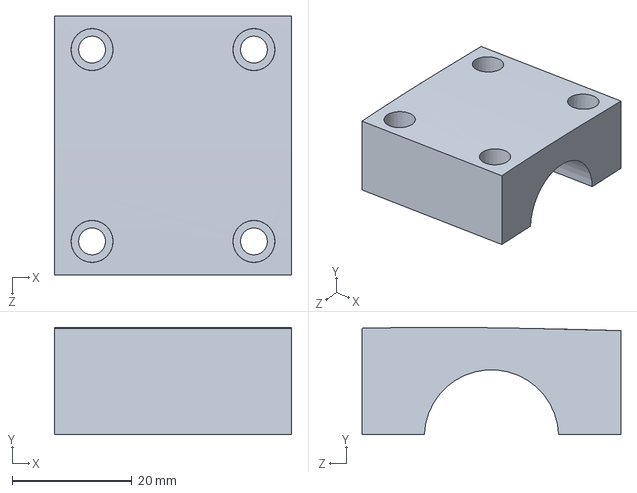
[picture p66: CAD file, 2026-07-26]
P01/P01-50_Propulsion/P01-50-01_Main_LH/P01-50-01-02_260726_Lower_Fairing_Lid_LH.SLDPRT
39.6 x 17.9 x 43.2 mm
