NikolaNikolow/ORGOfly-CAD-model/P01/P01-60_Landing/P01-60-01_FWD_LG/P01-60-01-03_261003_Pin.SLDPRT

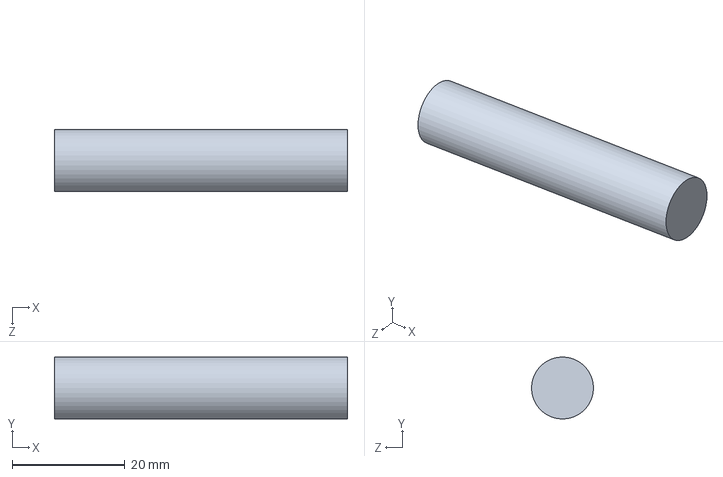
[picture p67: CAD file, 2026-10-03]
P01/P01-60_Landing/P01-60-01_FWD_LG/P01-60-01-03_261003_Pin.SLDPRT
52.0 x 11.0 x 11.0 mm
