NikolaNikolow/ORGOfly-CAD-model/0_CADModel_FreeCAD/Orgo body.STEP

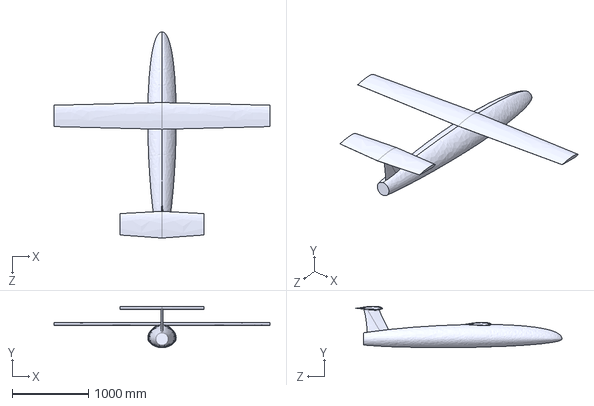
[picture p68: CAD file, 2026-02-06]
0_CADModel_FreeCAD/Orgo body.STEP
2830.0 x 542.4 x 2700.0 mm
