NikolaNikolow/ORGOfly-CAD-model/P01/P01-20_Fuselage/P01-20-02_Frame/P01-20-02-01_260724_Joint_Fwd_Bottom.SLDPRT

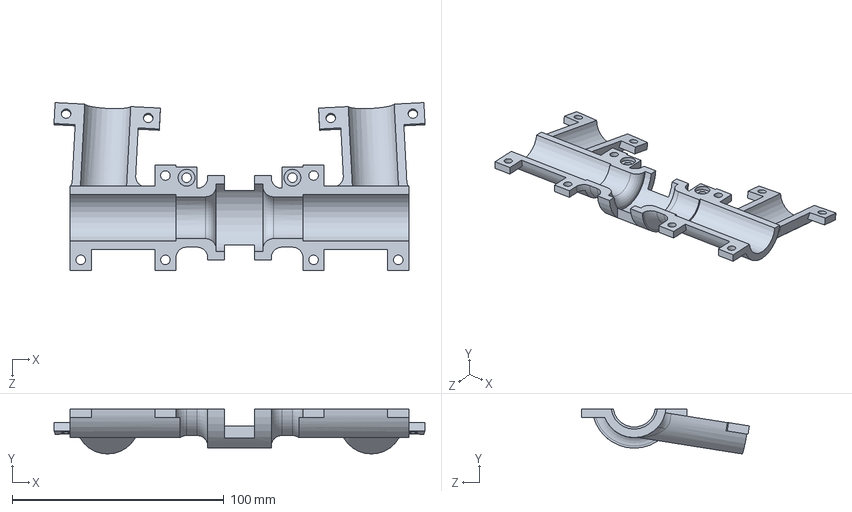
[picture p69: CAD file, 2026-10-20]
P01/P01-20_Fuselage/P01-20-02_Frame/P01-20-02-01_260724_Joint_Fwd_Bottom.SLDPRT
175.2 x 21.2 x 79.3 mm
