NikolaNikolow/ORGOfly-CAD-model/P01/P01-40_Tail/P01-40-02_Tail_RH/Threaded Insert M4 x 8.1mm.SLDPRT

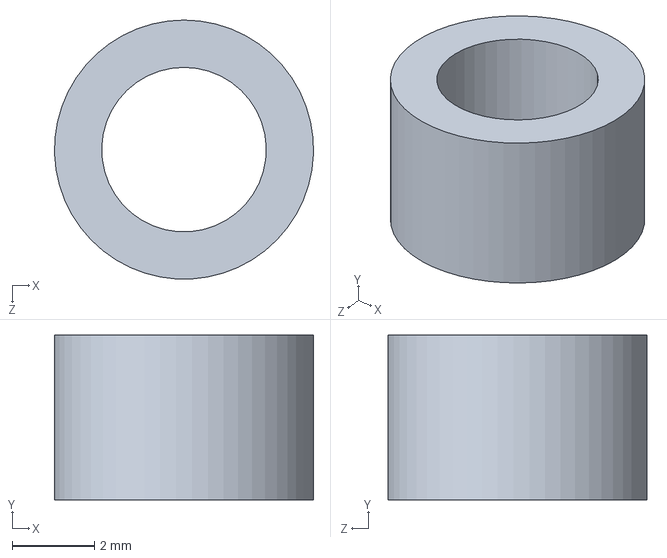
[picture p70: CAD file, 2026-10-10]
P01/P01-40_Tail/P01-40-02_Tail_RH/Threaded Insert M4 x 8.1mm.SLDPRT
6.30 x 4.00 x 6.29 mm
