NikolaNikolow/ORGOfly-CAD-model/1_ORGO-15_P1/1_CAD_model/Main_Assembly_v3.SLDASM

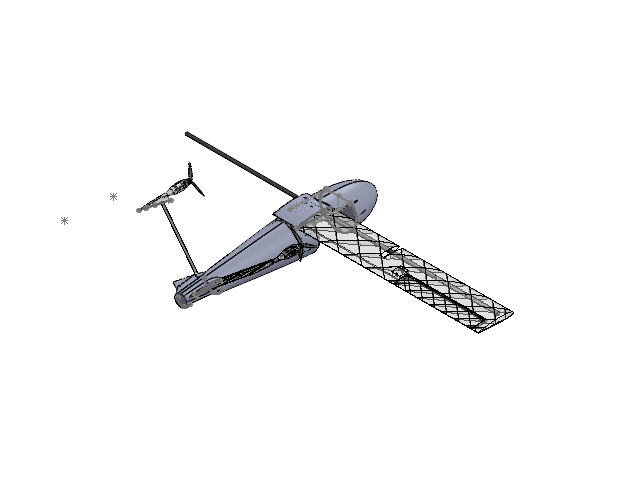
[picture p71: CAD file, 2026-07-22]
1_ORGO-15_P1/1_CAD_model/Main_Assembly_v3.SLDASM
Fuselage_v1.4_ANI
0.17m_20x18mm_CF_tube
FWD_tube_joint_Bottom_Mid_v1
0.55m_22x20mm_CF_tube x 2
FWD_tube_joint_Top_v1
0.944m_22x20mm_CF_tube x 2
AFT_tube_joint_Top_v1
AFT_tube_joint_Bottom_v1
FWD_tube_joint_Bottom_v1
Towerpro_MG996R x 2
Avenger_3210-500KV_Stator x 2
Avenger_3210-500KV_Rotor x 2
HQProp_10x5x3_dummy x 2
Upper_Fairing_LH
Servo_Arm x 2
Lower_Fairing_Тail_LH_v2
Bearing 105-2Z x 2
Shoulder Bolt 5mm M4 x 0.7mm x 2
Threaded Insert M4 x 4mm x 2
Tail_CF_Tube x 2
Upper_Fairing_RH
Lower_Fairing_Тail_RH_v2
Fuselage_to_vtail
Vtail_to_motor
Elevon_Fuselage_to_Vtail
Elevon_Vtail_to_Motor
NACA2412_3Dmodel_test
