NikolaNikolow/ORGOfly-CAD-model/1_ORGO-15_P1/1_CAD_model/NACA2412/Test Assemblies/Servo for Aileron.SLDASM

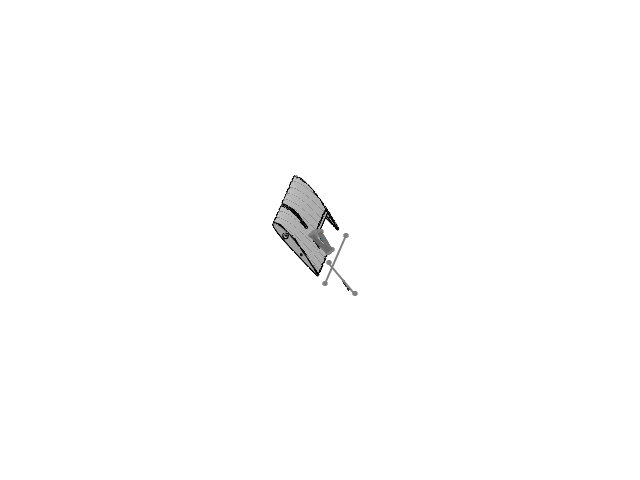
[picture p72: CAD file, 2026-06-26]
1_ORGO-15_P1/1_CAD_model/NACA2412/Test Assemblies/Servo for Aileron.SLDASM
NACA2412_3Dmodel_test
A15-2212_DM.step
4001-0025-0006.STEP
2800-0004-0008_90128A207.STEP
2100-0006-0025.step
radial ball bearing_68_iso x 2
