NikolaNikolow/ORGOfly-CAD-model/1_ORGO-15_P1/1_CAD_model/ORGO_Assembly/Main_Assembly_v3.SLDASM

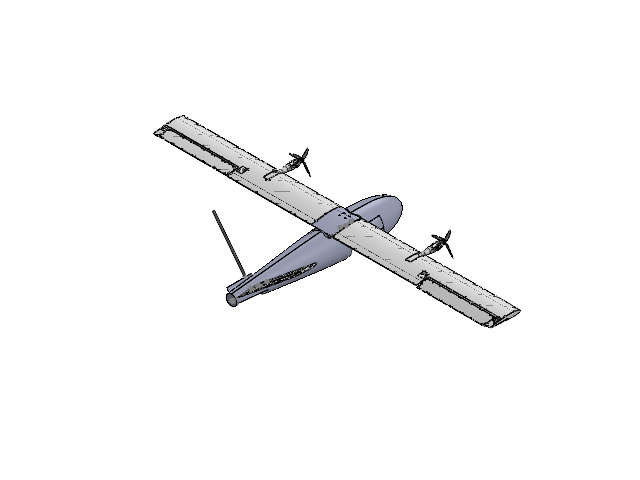
[picture p73: CAD file, 2026-06-30]
1_ORGO-15_P1/1_CAD_model/ORGO_Assembly/Main_Assembly_v3.SLDASM
Fuselage_v1.4_ANI
0.17m_20x18mm_CF_tube
mid_part_outer
0.55m_22x20mm_CF_tube x 2
mid_part_fuselage_inner
0.944m_22x20mm_CF_tube x 2
CF_tube_V-tail_v1 x 2
Left_aileron
Left_halfwing
Right_aileron
Right_halfwing
Towerpro_MG996R x 2
Avenger_3210-500KV_Stator x 2
Avenger_3210-500KV_Rotor x 2
HQProp_10x5x3_dummy x 2
Upper_Fairing x 2
Servo_Arm x 2
Lower_Fairing_v4 x 2
Lower_Fairing_v4_Insert x 2
Bearing 105-2Z x 2
Shoulder Bolt 5mm M4 x 0.7mm x 2
Threaded Insert M4 x 4mm x 2
Threaded Insert M4 x 8.1mm x 8
Machine Screw M4 х 20mm x 8
Right_elevon
Right_halfvtail
