NikolaNikolow/ORGOfly-CAD-model/P01/P01-60_Landing/P01-60-01_FWD_LG/P01-60-01_261003_FWD_LG.SLDASM

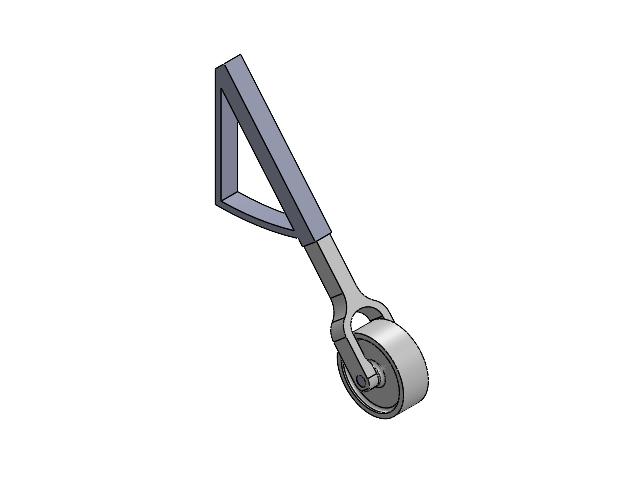
[picture p74: CAD file, 2026-10-04]
P01/P01-60_Landing/P01-60-01_FWD_LG/P01-60-01_261003_FWD_LG.SLDASM
P01-60-01-01_261003_FWD_Beam
P01-60-01-02_261003_FWD_Fork
HomeMax_Kolelo_Plastmasovo_80x30mm
P01-60-01-03_261003_Pin
