NikolaNikolow/ORGOfly-CAD-model/P01/P01-40_Tail/P01-40-05_Control_Mechanism_LH/P01-40-05_260727_Control_Mechanism_LH.SLDASM

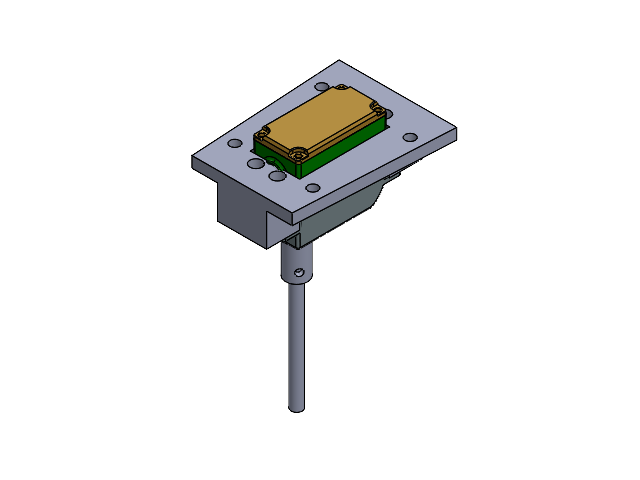
[picture p75: CAD file, 2026-08-16]
P01/P01-40_Tail/P01-40-05_Control_Mechanism_LH/P01-40-05_260727_Control_Mechanism_LH.SLDASM
Dummy_model_servo_shaft_coupler
BLS662_DM_2020.step
Dummy_model_5_60_shaft
P01-40-05-01_260816_Servo_Mount_Elevons
