NikolaNikolow/ORGOfly-CAD-model/P01/P01-50_Propulsion/P01-50-02_Main_RH/P01-50-02_260726_Main_Motor_RH.SLDASM

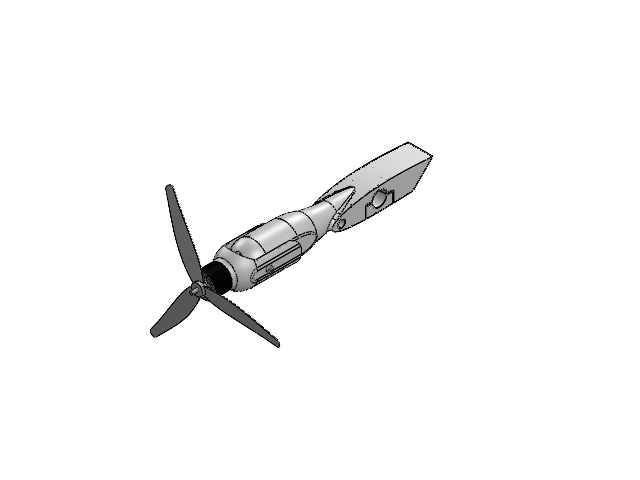
[picture p76: CAD file, 2026-07-27]
P01/P01-50_Propulsion/P01-50-02_Main_RH/P01-50-02_260726_Main_Motor_RH.SLDASM
Towerpro_MG996R
Avenger_3210-500KV_Stator
Avenger_3210-500KV_Rotor
HQProp_10x5x3_dummy
P01-50-02-03_260726_Upper_Fairing_RH
P01-50-02-05_260726_Servo_Arm
P01-50-02-01_260726_Lower_Fairing_RH
P01-50-02-02_260726_Lower_Fairing_Lid_RH
Bearing 105-2Z
Shoulder Bolt 5mm M4 x 0.7mm
Threaded Insert M4 x 4mm
Threaded Insert M4 x 8.1mm x 4
Machine Screw M4 х 20mm x 4
