NikolaNikolow/ORGOfly-CAD-model/P01/P01-40_Tail/P01-40-01_Tail_LH/P01-40-01_260727_Tail_LH.SLDASM

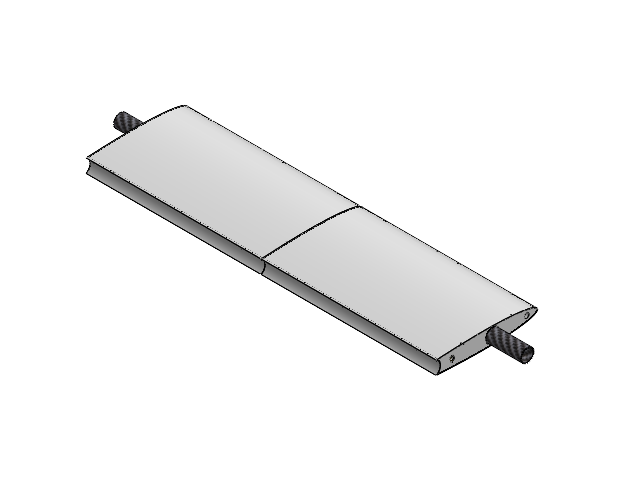
[picture p77: CAD file, 2026-08-24]
P01/P01-40_Tail/P01-40-01_Tail_LH/P01-40-01_260727_Tail_LH.SLDASM
P01-40-01-02_260727_CF_Tube
P01-40-01-03_260727_Tailpin
P01-40-01-01_260727_Tailplane x 2
Threaded Insert M4 x 8.1mm x 2
