NikolaNikolow/ORGOfly-CAD-model/P01/P01_07_DIANA/Main_Assembly.SLDASM

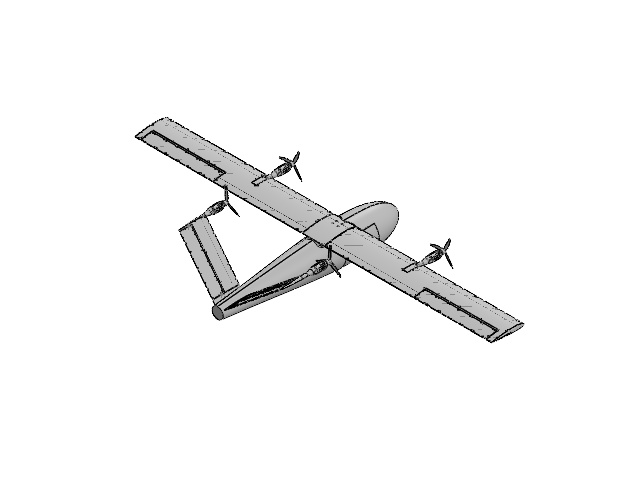
[picture p78: CAD file, 2026-07-02]
P01/P01_07_DIANA/Main_Assembly.SLDASM
Fuselage_v1.4_ANI
0.17m_20x18mm_CF_tube
mid_part_outer
0.55m_22x20mm_CF_tube x 2
mid_part_fuselage_inner
0.944m_22x20mm_CF_tube x 2
CF_tube_V-tail_v1 x 2
Part1^Main_Assembly
Right_halfwing
Left_halfwing
Left_aileron
Right_aileron
Towerpro_MG996R x 3
Avenger_3210-500KV_Stator x 3
Avenger_3210-500KV_Rotor x 3
HQProp_10x5x3_dummy x 3
Upper_Fairing x 3
Servo_Arm x 3
Lower_Fairing_v4 x 2
Lower_Fairing_v4_Insert x 2
Bearing 105-2Z x 3
Shoulder Bolt 5mm M4 x 0.7mm x 3
Threaded Insert M4 x 4mm x 3
Threaded Insert M4 x 8.1mm x 8
Machine Screw M4 х 20mm x 8
Lower_Fairing_Тail_v2
Right_elevon
Left_elevon
MirrorTowerpro_MG996R
MirrorAvenger_3210-500KV_Stator
MirrorAvenger_3210-500KV_Rotor
MirrorHQProp_10x5x3_dummy
MirrorUpper_Fairing
MirrorServo_Arm
MirrorLower_Fairing_Тail_v2
MirrorBearing 105-2Z
MirrorShoulder Bolt 5mm M4 x 0.7mm
MirrorThreaded Insert M4 x 4mm
