NikolaNikolow/ORGOfly-CAD-model/P01/P01-20_Fuselage/P01-20-02_Frame/P01-20-02_Frame.SLDASM

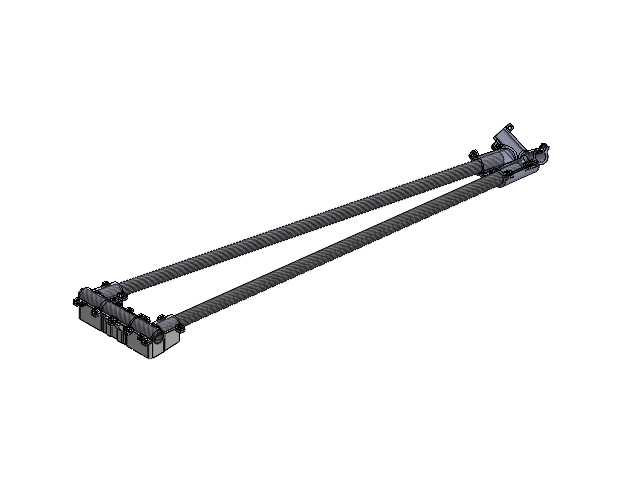
[picture p79: CAD file, 2026-10-20]
P01/P01-20_Fuselage/P01-20-02_Frame/P01-20-02_Frame.SLDASM
P01-20-02-06_261016_Firewall_Mount
P01-20-02-02_260714_Joint_Fwd_Bottom_Mid
P01-20-02-03_260714_Joint_Fwd_Top
P01-20-02-04_260724_Joint_Aft_Bottom
P01-20-02-05_260724_Joint_Aft_Top
0.17m_20x18mm_CF_tube
0.944m_22x20mm_CF_tube x 2
Threaded Insert M4 x 8.1mm x 6
