NikolaNikolow/ORGOfly-CAD-model/(list of files, cad)

Other CAD files:
P01/P01-40_Tail/P01-40-02_Tail_RH/P01-40-02_260727_Tail_RH.SLDASM
P01/P01-40_Tail/P01-40-03_Elevon_LH/P01-40-03_Elevon_LH.SLDASM
P01/P01-50_Propulsion/P01-50-01_Main_LH/Avenger_3210-500KV.SLDASM
P01/P01-70_Avionics/P01-70-01_261026_Flight_Control.SLDASM
P01/P01_07_DIANA/Main_Tilting_Mechanism.SLDASM
P01/P01_260727_Main_Assembly.SLDASM
P01/P01-40_Tail/P01-40-04_Elevon_RH/P01-40-04_Elevon_RH.SLDASM
P01/P01-50_Propulsion/P01-50-01_Main_LH/P01-50-01_260726_Main_Motor_LH.SLDASM
P01/P01-60_Landing/P01-60-01_Skids/P01-60-01-00_261008_Skids.SLDASM
0_CADModel_FreeCAD/10_Assembly.FCStd
P01/P01-30_Wing/P01-30-03_Aileron_Rotation_Mechanism/P01-30-03_Servo_and_ShaftCoupler_ServoMount_Assembly.SLDASM
P01/P01-40_Tail/P01-40-06_Control Mechanism_RH/P01-40-06_261023_Control_Mechanism_RH.SLDASM
P01/P01_07_DIANA/Tail_Tilting_Mechanism.SLDASM
P01/P01-30_Wing/P01-30-02_Wing_RH/P01-30-02_Wing_RH.SLDASM
P01/P01-50_Propulsion/P01-50-04_Tail_RH/P01-50-04_260724_Motor_Tail_RH.SLDASM
P01/P01-80_Payload/P01-80-01_Payload_bay/P01-80-01_260715_Payload_bay.SLDASM
P01/P01-50_Propulsion/P01-50-03_Tail_LH/P01-50-03_260724_Tail_Motor_LH.SLDASM
P01/P01-50_Propulsion/P01-50-02_Main_RH/Avenger_3210-500KV.SLDASM
P01/P01-80_Payload/P01-80-01_Payload_bay/AaCabinet_Door_Roller_Catch.SLDASM
P01/P01-80_Payload/P01-80-01_Payload_bay/MOSECYOU_6in_French_Door_Lock.SLDASM
1_Solid_CAD_Model/15 kg version/ORGO_Structure/Structure_v1/Adator_V-tail/Adator_V-tail_v1.SLDPRT
P01/P01-10_General/P01-10-02_Layouts/P01-10-02-01_260502_Front_layout.STEP
P01/P01-20_Fuselage/P01-20-01_Skin/Experimental!.SLDPRT
P01/P01-20_Fuselage/P01-20-02_Frame/0.944m_22x20mm_CF_tube.SLDPRT
P01/P01-30_Wing/P01-30-01_Wing_LH/P01-30-01-07_261109_Wing_Tip_LH_mirror.SLDPRT
P01/P01-30_Wing/P01-30-02_Wing_RH/P01-30-02-04_260724_Wing_Servo_Section_RH.SLDPRT
P01/P01-30_Wing/P01-30-02_Wing_RH/STLs/Wing_Section4_RH_22.3mm.gcode.3mf
P01/P01-30_Wing/P01-30-03_Aileron_Rotation_Mechanism/BLS662_DM_2020.STEP
P01/P01-40_Tail/P01-40-01_Tail_LH/P01-40-01-03_260727_Tailpin.SLDPRT
P01/P01-40_Tail/P01-40-02_Tail_RH/STLs/Tail_RH_Section1_new.gcode.3mf
P01/P01-40_Tail/P01-40-04_Elevon_RH/P01-40-04-02_260727_Upper_Elevon.SLDPRT
P01/P01-40_Tail/P01-40-05_Control_Mechanism_LH/P01-40-05-01_260816_Servo_Mount_Elevons.SLDPRT
P01/P01-40_Tail/P01-40-06_Control Mechanism_RH/BLS662_DM_2020.STEP
P01/P01-50_Propulsion/P01-50-02_Main_RH/P01-50-02-04_260726_NACA2412_Motor.SLDPRT
P01/P01-50_Propulsion/P01-50-03_Tail_LH/SSL_P01-50-03-01_261108_Lower_Fairing_LH_PRINT.3mf
P01/P01-50_Propulsion/P01-50-04_Tail_RH/SSL_P01-50-04-01_261031_Lower_Fairing_RH_PRINT.3mf
P01/P01-60_Landing/P01-60-01_Skids/P01-60-01-05_261011_Tube_Joint_AFT_RH_TOP.SLDPRT
P01/P01-90_Simulations/FWD LG/Leafspring Compression SImulations/Leafpring_R125_t5_L150_w10.STL
P01/P01_05_Design/Flight_Control/Deflection of FL Surfaces/Doyono_DHC105_low_profile_26kg_approx_envelope.step
0_CADModel_FreeCAD/02_Fuselage.FCStd
P01/P01-10_General/P01-10-02_Layouts/P01-10-03-02_260502_Top_layout.STEP
P01/P01-20_Fuselage/P01-20-01_Skin/P01-20-01-09_261024_Skin_Section8.SLDPRT
P01/P01-20_Fuselage/P01-20-02_Frame/P01-20-02-06_261016_Firewall_Mount.SLDPRT
P01/P01-30_Wing/P01-30-01_Wing_LH/0.55m_22x20mm_CF_tube.SLDPRT
P01/P01-30_Wing/P01-30-02_Wing_RH/P01-30-02-11_260807_NACA2412_3Dmodel_test_RH.SLDPRT
P01/P01-30_Wing/P01-30-02_Wing_RH/STLs/P01-30-02-04_260724_Wing_Servo_Section_RH_22.3mm.STL
P01/P01-30_Wing/P01-30-03_Aileron_Rotation_Mechanism/P01-30-03-01_260807_Servo_Mount.SLDPRT
P01/P01-40_Tail/P01-40-01_Tail_LH/P01-40-01-02_260727_CF_Tube.SLDPRT
P01/P01-40_Tail/P01-40-02_Tail_RH/STLs/Tail_RH_Section2_new.gcode.3mf
P01/P01-40_Tail/P01-40-02_Tail_RH/Threaded Insert M4 x 4mm.SLDPRT
P01/P01-40_Tail/P01-40-03_Elevon_LH/P01-40-03-01_260727_Lower_Elevon_copyRH.SLDPRT
P01/P01-40_Tail/P01-40-06_Control Mechanism_RH/Dummy_model_servo_shaft_coupler.SLDPRT
P01/P01-50_Propulsion/P01-50-02_Main_RH/P01-50-02-01_260726_Lower_Fairing_RH.SLDPRT
P01/P01-50_Propulsion/P01-50-03_Tail_LH/SSL_P01-50-03-01_261031_Lower_Fairing_LH_PRINT.3mf
P01/P01-50_Propulsion/P01-50-04_Tail_RH/Avenger_3210-500KV_Stator.SLDPRT
P01/P01-70_Avionics/Turnigy Heavy Duty 6S 5500mAh LiPo.STEP
P01/P01-90_Simulations/FWD LG/Leafspring Compression SImulations/Spring_7X5_1t2_L150_w10.SLDPRT
P01/P01_05_Design/Flight_Control/Deflection of FL Surfaces/MS4512_DM.STEP
P01/P01_07_DIANA/Fuselage_v1.4.1_DIANA_experimental_ANI.SLDPRT
P01/P01-10_General/P01-10-02_Layouts/P01-10-02-02_260502_Top_layout.SLDPRT
P01/P01-20_Fuselage/P01-20-01_Skin/P01-20-01-05_261024_Skin_Section4.SLDPRT
P01/P01-20_Fuselage/P01-20-02_Frame/0.17m_20x18mm_CF_tube.SLDPRT
P01/P01-30_Wing/P01-30-02_Wing_RH/P01-30-02-05_260909_Wing_Section_After_Servo_RH.SLDPRT
P01/P01-30_Wing/P01-30-02_Wing_RH/STLs/P01-30-02-05_260909_Wing_Section_After_Servo_RH_20.5mm.STL
P01/P01-40_Tail/P01-40-01_Tail_LH/Threaded Insert M4 x 8.1mm.SLDPRT
P01/P01-40_Tail/P01-40-02_Tail_RH/P01-40-02-02_260824_Tailplane.SLDPRT
P01/P01-40_Tail/P01-40-02_Tail_RH/STLs/P01-40-02-01_260824_Tailplane_new.STL
P01/P01-40_Tail/P01-40-03_Elevon_LH/P01-40-03-02_260727_Upper_Elevon.SLDPRT
P01/P01-50_Propulsion/P01-50-04_Tail_RH/Threaded Insert M4 x 4mm.SLDPRT
P01/P01-60_Landing/P01-60-01_Skids/P01-60-01-09_261017_Tube_Joint_Cap_AFT_LH_TOP.SLDPRT
P01/P01-70_Avionics/Matek F405-HDTE.STEP
P01/P01_07_DIANA/Cargo_Bay.SLDPRT
0_CADModel_FreeCAD/Unnamed.FCStd
P01/P01-20_Fuselage/P01-20-01_Skin/P01-20-01-06_261024_Skin_Section5.SLDPRT
P01/P01-20_Fuselage/P01-20-02_Frame/P01-20-02-03_260714_Joint_Fwd_Top.SLDPRT
P01/P01-30_Wing/P01-30-02_Wing_RH/P01-30-02-07_260724_Wing_Tip_RH.SLDPRT
P01/P01-30_Wing/P01-30-02_Wing_RH/STLs/Wing_Section5_RH_20.5mm.gcode.3mf
P01/P01-40_Tail/P01-40-02_Tail_RH/STLs/P01-40-02-02_260824_Tailplane_new.STL
P01/P01-50_Propulsion/P01-50-03_Tail_LH/SSL_P01-50-03-01_261027_Lower_Fairing_LH_PRINT.3mf
P01/P01-50_Propulsion/P01-50-04_Tail_RH/Bearing 105-2Z.SLDPRT
P01/P01-60_Landing/P01-60-01_Skids/P01-60-01-08_261017_Tube_Joint_AFT_LH_TOP.SLDPRT
P01/P01-70_Avionics/Avenger_3210-500KV.STEP
P01/P01-80_Payload/P01-80-01_Payload_bay/P01-80-01-01_260715_Bay_body.SLDPRT
0_CADModel_FreeCAD/00_MasterLayout.FCStd
P01/P01-20_Fuselage/P01-20-01_Skin/P01-20-01-04_261024_Skin_Section3.SLDPRT
P01/P01-20_Fuselage/P01-20-02_Frame/P01-20-02-02_260714_Joint_Fwd_Bottom_Mid.SLDPRT
P01/P01-30_Wing/P01-30-02_Wing_RH/STLs/Wing_Section4_RH.gcode.3mf
P01/P01-40_Tail/P01-40-02_Tail_RH/STLs/Tail_RH_Section1.gcode.3mf
P01/P01-50_Propulsion/P01-50-02_Main_RH/P01-50-02-02_260726_Lower_Fairing_Lid_RH.SLDPRT
P01/P01-50_Propulsion/P01-50-03_Tail_LH/P01-50-03-02_260724_Lower_Fairing_Lid_LH.SLDPRT
P01/P01-60_Landing/P01-60-01_Skids/P01-60-01-07_261017_Tube_Joint_Cap_AFT_RH_TOP.SLDPRT
P01/P01-70_Avionics/TBS Crossfire Diversity Nano RX.STEP
P01/P01-80_Payload/P01-80-01_Payload_bay/P01-80-01-09_261003_Firewall.SLDPRT
P01/P01_07_DIANA/Right_halfwing.SLDPRT
P01/P01-20_Fuselage/P01-20-01_Skin/P01-20-01-01_261024_Fuselage_Skin.SLDPRT
P01/P01-30_Wing/P01-30-02_Wing_RH/P01-30-02-06_260724_Wing_Section_RH.SLDPRT
P01/P01-30_Wing/P01-30-02_Wing_RH/STLs/Wing_Section6_RH_20.4mm.gcode.3mf
P01/P01-40_Tail/P01-40-02_Tail_RH/STLs/Tail_RH_Section2.gcode.3mf
P01/P01-50_Propulsion/P01-50-02_Main_RH/Threaded Insert M4 x 4mm.SLDPRT
P01/P01-60_Landing/P01-60-01_Skids/500x20x18mm_CF_tube.SLDPRT
P01/P01-70_Avionics/Mateksys PDB FCHUB-12S1.STEP
0_CADModel_FreeCAD/01_Wing.FCStd
0_CADModel_FreeCAD/Airfoil-Wing.FCStd
0_CADModel_FreeCAD/Drone body.FCStd
0_CADModel_FreeCAD/ORGOfly-BodyPad.FCStd
P01/P01-10_General/P01-10-02_Layouts/P01-10-02-01_260502_Front_layout.SLDPRT
P01/P01-20_Fuselage/P01-20-01_Skin/P01-20-01-01_260727_Fuselage_v1.4_ANI.SLDPRT
P01/P01-20_Fuselage/P01-20-01_Skin/P01-20-01-02_260727_Fuselage_Infill.SLDPRT
P01/P01-20_Fuselage/P01-20-01_Skin/P01-20-01-04_260929_S02_Upper.SLDPRT
P01/P01-20_Fuselage/P01-20-01_Skin/P01-20-01-05_260929_S02_Bottom.SLDPRT
P01/P01-20_Fuselage/P01-20-01_Skin/P01-20-01-06_260929_S02_Left.SLDPRT
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
