NikolaNikolow/ORGOfly-CAD-model/Corporate/Guideline_260724_File_Organisation.docx

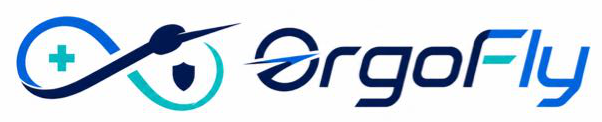
[picture p80: figure]

# OrgoFly

CAD File Organization and Naming Standard

Revision | Description | Author | Date
A | Initial Release | Aleksandar Nikolov | 28/Jul/2026

## 1. Purpose

This document defines how SolidWorks files for OrgoFly shall be named, stored, updated, and archived.

The objectives are to:

- keep files easy to find;
- prevent duplicate files;
- reduce broken SolidWorks references;
- identify the active version of every component;
- preserve important previous designs;
- ensure that all team members work consistently.

All active Prototype 01 files shall remain inside the approved project folder.

## 2. Folder structure

ORGOFLY_PROTOTYPE_01_CAD

10_GENERAL (Master geometry goes into general)

20_FUSELAGE

30_WING

40_TAIL

50_PROPULSION_AND_TILT

60_LANDING_GEAR

70_AVIONICS_AND_ELECTRICAL

80_PAYLOAD

99_ARCHIVE

All active files shall be stored inside this structure.

Files shall not be referenced from:

- Desktop;
- Downloads;
- email attachments;
- personal folders;
- temporary folders;
- USB drives;
- old project folders.

## 3. File-naming format

AAA-BB-CC-XXX_yymmdd_Name

Field | Meaning
AAA | 3 letter/number project code (ex. P01,F02,C01, etc)
BB | 2 number assembly code (refer to section 2)
CC | 2 number subassembly code (ex. RH Wing, LH Wing)
XXX | 3 number component code (consecutive and unique for each component)
yymmdd | date the document was CREATED (refer to section 5)
Name | Ends with component name

"0" designator reserved for main assembly and skipped

Example: P01-30-02-01_260724_Wing_Root_RH

Sourced and standard components retain their original names:

Ex: Avenger_3210-500KV

Ex: Threaded Insert M4 x 4mm

## 4. Folder usage

00_TOP_LEVEL

Contains the complete aircraft assembly and other full-aircraft configurations.

Example:

OF-P01-TOP-000-20260723-TOP_LEVEL.SLDASM

Possible additional assemblies include:

OF-P01-TOP-010-20260723-FLIGHT_CONFIGURATION.SLDASM

OF-P01-TOP-020-20260723-TRANSPORT_CONFIGURATION.SLDASM

10_MASTER_GEOMETRY

Contains the reference geometry controlling the aircraft layout, such as:

- aircraft centreline;
- wing planform and airfoils;
- fuselage envelope;
- tail position;
- rotor and tilt axes;
- major interface planes.

These files define geometry but are not normally manufactured parts.

Subsystem folders

The fuselage, wing, tail, propulsion, landing gear, avionics, and payload folders contain the parts and assemblies belonging to those systems.

A component shall be stored according to where it is primarily used.

Examples:

Wing servo bracket

→ 30_WING/Parts/

Motor mount

→ 50_PROPULSION_AND_TILT/Parts/

Flight-controller tray

→ 70_AVIONICS_AND_ELECTRICAL/Parts/

99_ARCHIVE

Contains superseded, abandoned, or historical files.

Active assemblies shall never reference files stored in 99_ARCHIVE.

## 5. Date rule

The date shall use:

YYMMDD

Example:

260723

The date identifies when that specific file was first created.

The date shall not change when the file is edited or saved.

For example, this file may be edited many times while retaining the same name:

OF-P01-WNG-001-20260723-WING_SKIN.SLDPRT

When a separate new file is intentionally created for the same component, the new file receives its own creation date:

OF-P01-WNG-001-20260723-WING_SKIN.SLDPRT

OF-P01-WNG-001-20260805-WING_SKIN.SLDPRT

Both files represent the same component because they share the permanent component ID:

OF-P01-WNG-001

The date only distinguishes separately created CAD files. It is not a revision number and does not record every modification.

A new dated file should be created only when there is a reason to preserve the existing file separately, such as:

- before a major redesign;
- after manufacturing;
- after issuing a drawing;
- after completing a test configuration;
- when creating an alternative design;
- when the previous geometry may need to be recovered.

## 6. Active-file rule

There shall normally be only one active file for each component.

For example:

OF-P01-WNG-001-20260723-WING_SKIN.SLDPRT

OF-P01-WNG-001-20260805-WING_SKIN.SLDPRT

Only one of these shall be used by the active assemblies.

The active file remains in:

30_WING/Parts/

The older file shall be moved to:

99_ARCHIVE/30_WING/

## 7. Same component or new component

Use the same component number when the new file still represents the same component.

Example:

OF-P01-WNG-001-20260723-WING_SKIN.SLDPRT

OF-P01-WNG-001-20260805-WING_SKIN.SLDPRT

Create a new component number when:

- the new part is not interchangeable with the previous part;
- both designs must remain active;
- the part has a substantially different purpose;
- the mounting interface is different;
- the new design belongs to another configuration.

Example:

OF-P01-WNG-001-20260723-WING_SKIN.SLDPRT

OF-P01-WNG-027-20260805-REINFORCED_WING_SKIN.SLDPRT

General rule:

Same component → Same number

Different or non-interchangeable component → New number

## 8. Subsystem codes

Code | Meaning
TOP | Top-level aircraft
MST | Master geometry
FUS | Fuselage
WNG | Wing
TAL | Tail
PRP | Propulsion
TLT | Tilt mechanism
LGR | Landing gear
AVN | Avionics
ELE | Electrical
PAY | Payload
HDW | Common hardware
JIG | Manufacturing jig
TST | Test equipment

The codes shall be used consistently by all team members.

## 9. Numbering

Each designed component shall receive a unique three-digit number within its subsystem.

Recommended ranges:

001–099 Parts

500–599 Subassemblies

700–799 Higher-level assemblies

900–999 Special, reference, jig, or test files

Examples:

OF-P01-WNG-001-20260723-WING_SKIN.SLDPRT

OF-P01-WNG-002-20260723-MAIN_SPAR.SLDPRT

OF-P01-WNG-100-20260723-LH_WING_ASSEMBLY.SLDASM

A number shall never be reused for a different component.

## 10. Description rules

Descriptions shall be clear and reasonably short.

Good examples:

- WING_SKIN
- MAIN_SPAR
- AILERON_HINGE_BRACKET
- MOTOR_MOUNT
- FLIGHT_CONTROLLER_TRAY
- LH_WING_ASSEMBLY

Do not use:

- PART1
- NEW_PART
- FINAL
- LATEST
- COPY
- UPDATED
- TEST2

Descriptions shall:

- use uppercase letters;
- use underscores instead of spaces;
- describe the physical item or function;
- avoid team-member names;
- avoid words such as NEW, FINAL, COPY, or LATEST.

Use LH and RH consistently for left-hand and right-hand parts.

## 11. Purchased components

Purchased components shall use:

PUR-[MANUFACTURER]-[MODEL]-[DESCRIPTION].[EXTENSION]

Examples:

PUR-KST-A15_2212-SERVO.SLDPRT

PUR-TMOTOR-MN5008-MOTOR.SLDPRT

PUR-SERVOCITY-H25T_025IN-COUPLER.SLDPRT

Purchased components shall normally not include a date because the manufacturer and model identify the product.

The same purchased component shall not be copied into multiple subsystem folders.

In case that we do not have the 3D model of a purchased part, a dummy model could be created using the following structure:

PUR_DUMMY-[MANUFACTURER]-[MODEL]-[DESCRIPTION].[EXTENSION]

## 12. Standard hardware

Standard hardware shall use:

STD-[STANDARD]-[SIZE]-[DESCRIPTION].[EXTENSION]

Examples:

STD-ISO4762-M5X20-SCREW.SLDPRT

STD-DIN985-M5-NYLOC_NUT.SLDPRT

STD-DIN125-M5-WASHER.SLDPRT

STD-625_2RS-BEARING.SLDPRT

## 13. Drawings and exports

A drawing shall use the same identifying name as its model.

OF-P01-WNG-001-20260723-WING_SKIN.SLDPRT

OF-P01-WNG-001-20260723-WING_SKIN.SLDDRW

Exports shall retain the source-file identification:

OF-P01-WNG-001-20260723-WING_SKIN.STEP

OF-P01-WNG-001-20260723-WING_SKIN.STL

OF-P01-WNG-001-20260723-WING_SKIN.PDF

This allows every manufacturing file to be traced to its source CAD file.

## 14. Creating a new part

When creating a new part:

1. Select the correct subsystem.
2. Check whether the component already exists.
3. Allocate the next available number.
4. Use the current date as the file-creation date.
5. Create a clear description.
6. Save the file directly in the correct Parts folder.
7. Add the file to the file register.
8. Insert it into the appropriate assembly.

Example:

OF-P01-WNG-014-20260723-AILERON_HINGE_BRACKET.SLDPRT

## 15. Creating a new assembly

When creating an assembly:

1. Confirm that it represents a meaningful physical or functional unit.
2. Select the correct subsystem.
3. Allocate a number from the assembly range.
4. Use the current creation date.
5. Save it in the subsystem Assemblies folder.
6. Add it to the file register.

Example:

OF-P01-WNG-120-20260723-AILERON_MECHANISM_ASSEMBLY.SLDASM

## 16. Creating a separate file for an existing component

When creating a separate new file for an existing component:

1. Preserve the original file.
2. Keep the same component number.
3. Use the new file’s creation date.
4. Make the required changes in the new file.
5. Update the affected assemblies to use the selected active file.
6. Verify mates and references.
7. Move the inactive file to 99_ARCHIVE.

Do not leave several dated files active without documenting which one is current.

## 17. Moving and renaming files

Referenced SolidWorks files shall not be casually moved or renamed through Windows File Explorer.

After moving, renaming, or replacing a file:

1. open the top-level assembly;
2. rebuild it;
3. check for missing references;
4. check mates and external references;
5. save and close the assembly;
6. reopen it to confirm that all files load correctly.

## 18. Working without PDM

Until PDM (Product Data Management) is introduced:

- only one person shall edit a file at a time;
- the central project folder is the authoritative source;
- personal copies shall not overwrite active project files;
- team members shall communicate before editing shared components;
- a “Push”in GitHub should be initiated only after all open files are closed;
- descriptive name for the GitHub “Push” should be used in order to have a track record and use of the history log;

## 19. Prohibited practices

Do not:

- use filenames containing FINAL, LATEST, NEW, or COPY;
- create several undocumented active files for one component;
- reference files from Desktop or Downloads;
- use archived files in active assemblies;
- reuse component numbers;
- duplicate purchased or standard components;
- modify an export instead of the SolidWorks source;
- move or rename referenced files without checking references;
- treat a personal file copy as authoritative.

## 20. Core rules

1. Every designed component receives one permanent component ID.
2. Every file is stored in its correct subsystem folder.
3. The filename date records when that file was created.
4. The date does not change when the file is edited.
5. A separately created file receives a new creation date.
6. There is normally only one active file for each component.
7. Inactive files are moved to 99_ARCHIVE.
8. Active assemblies shall never reference archived files.
9. Purchased and standard components are stored once and reused.
10. Referenced files shall be moved or renamed only using controlled SolidWorks procedures.
