NikolaNikolow/ORGOfly-CAD-model/P01/P01-10_General/P01-10-02_Layouts/P01-10-02-03_260502_ORGO_Design_Sketch.pdf

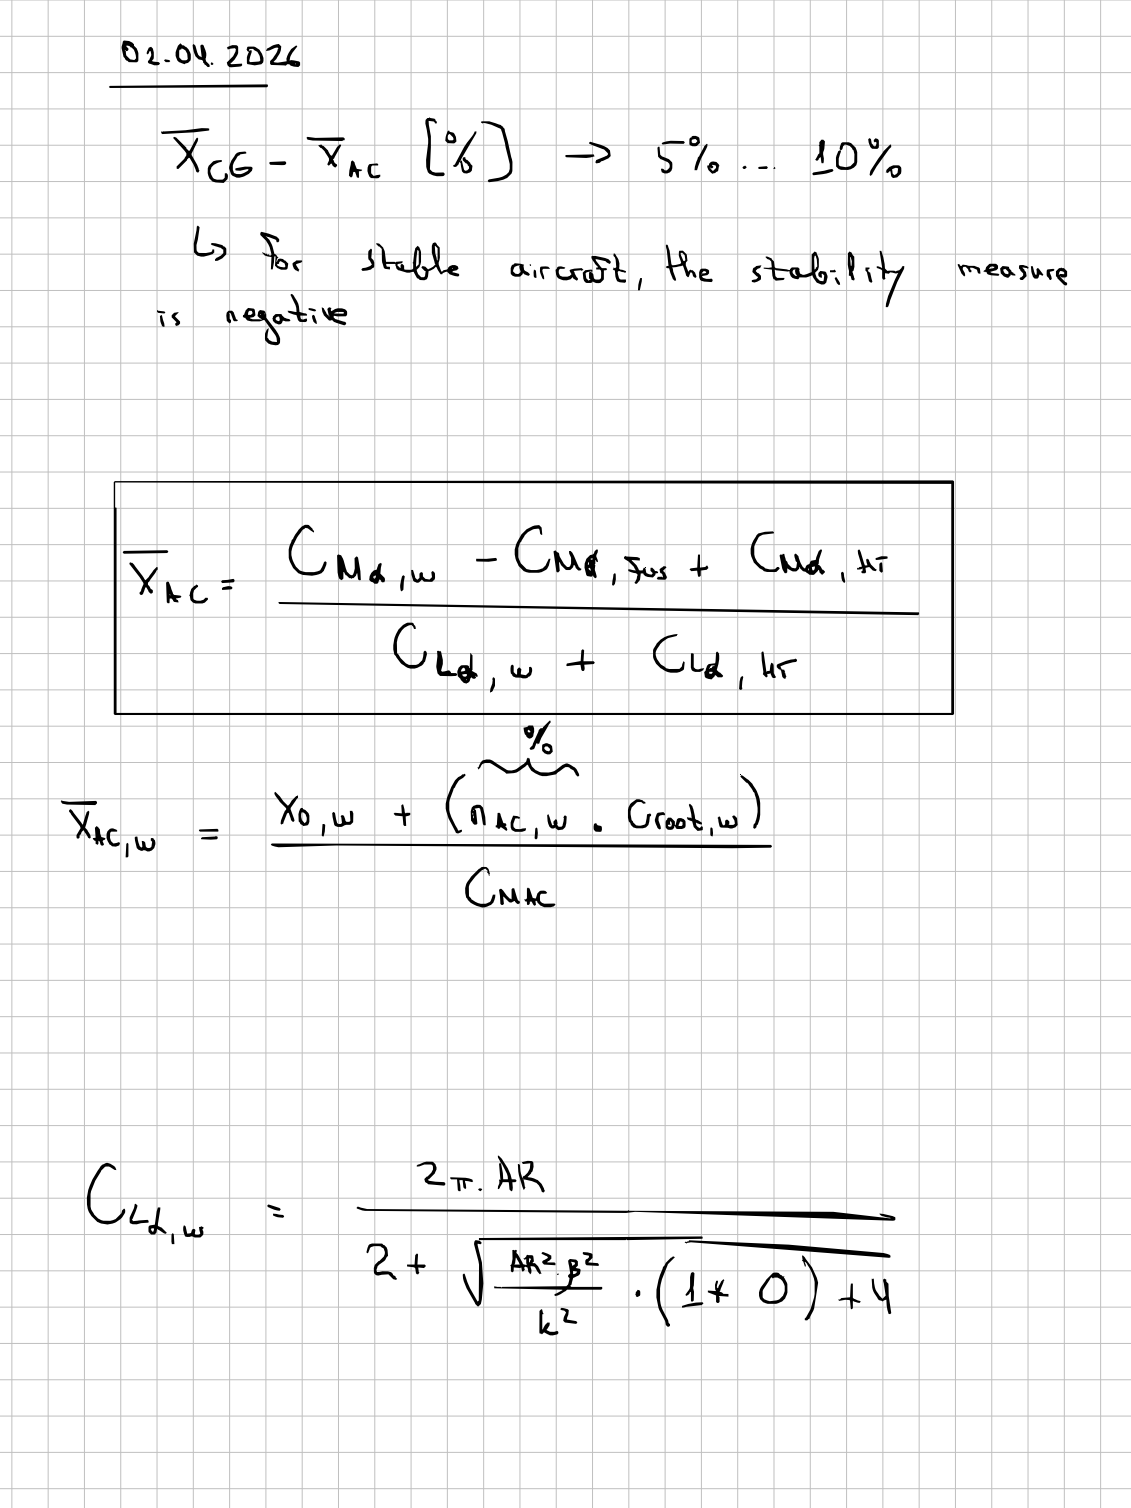
[picture p81: page 1]

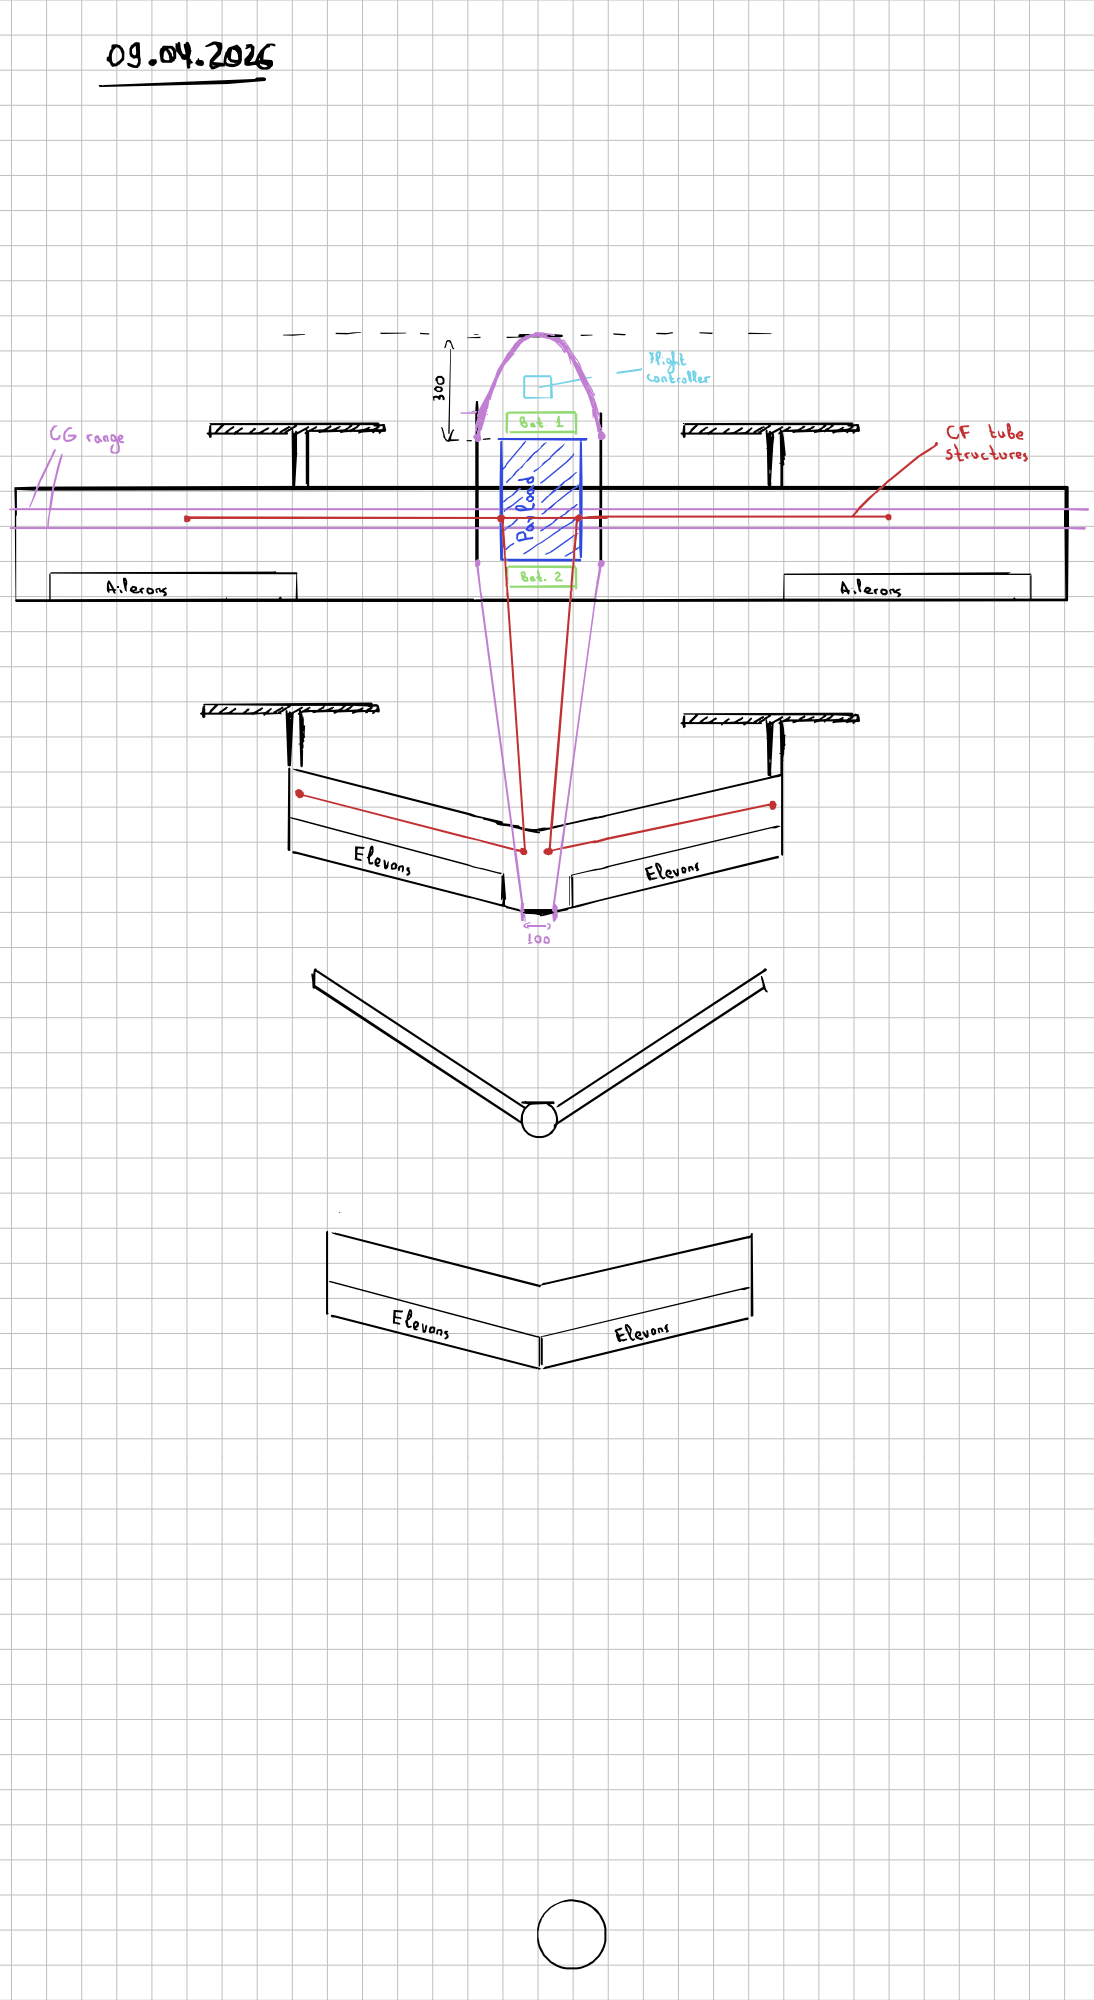
[picture p82: page 2]

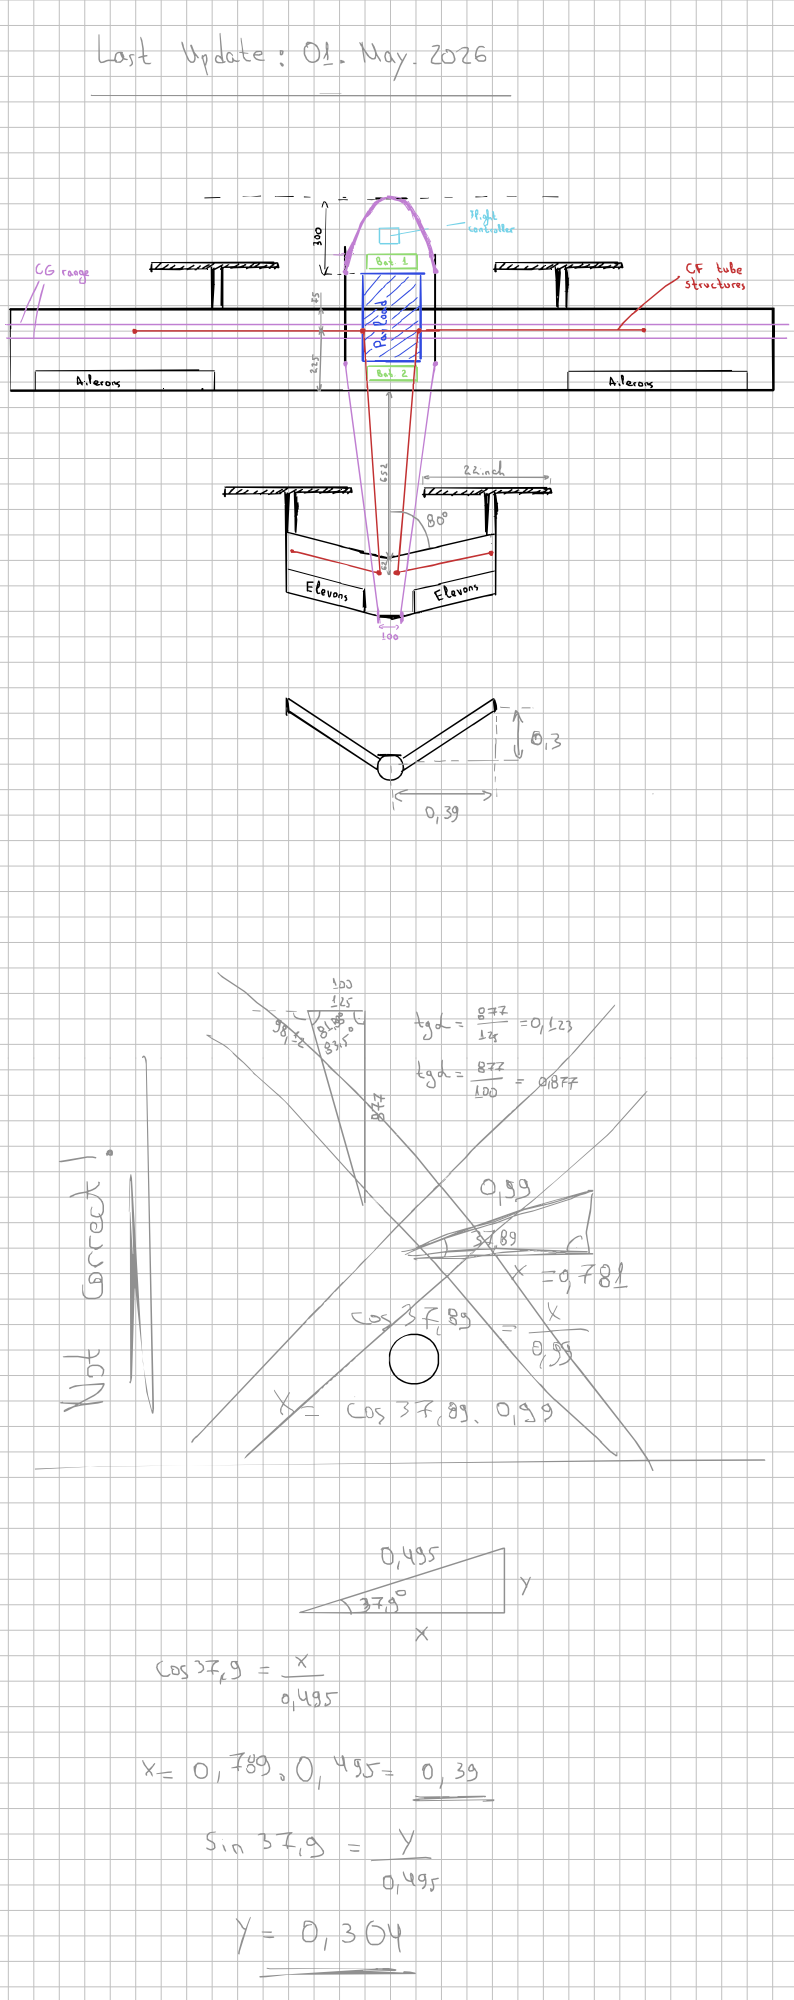
[picture p83: page 3]

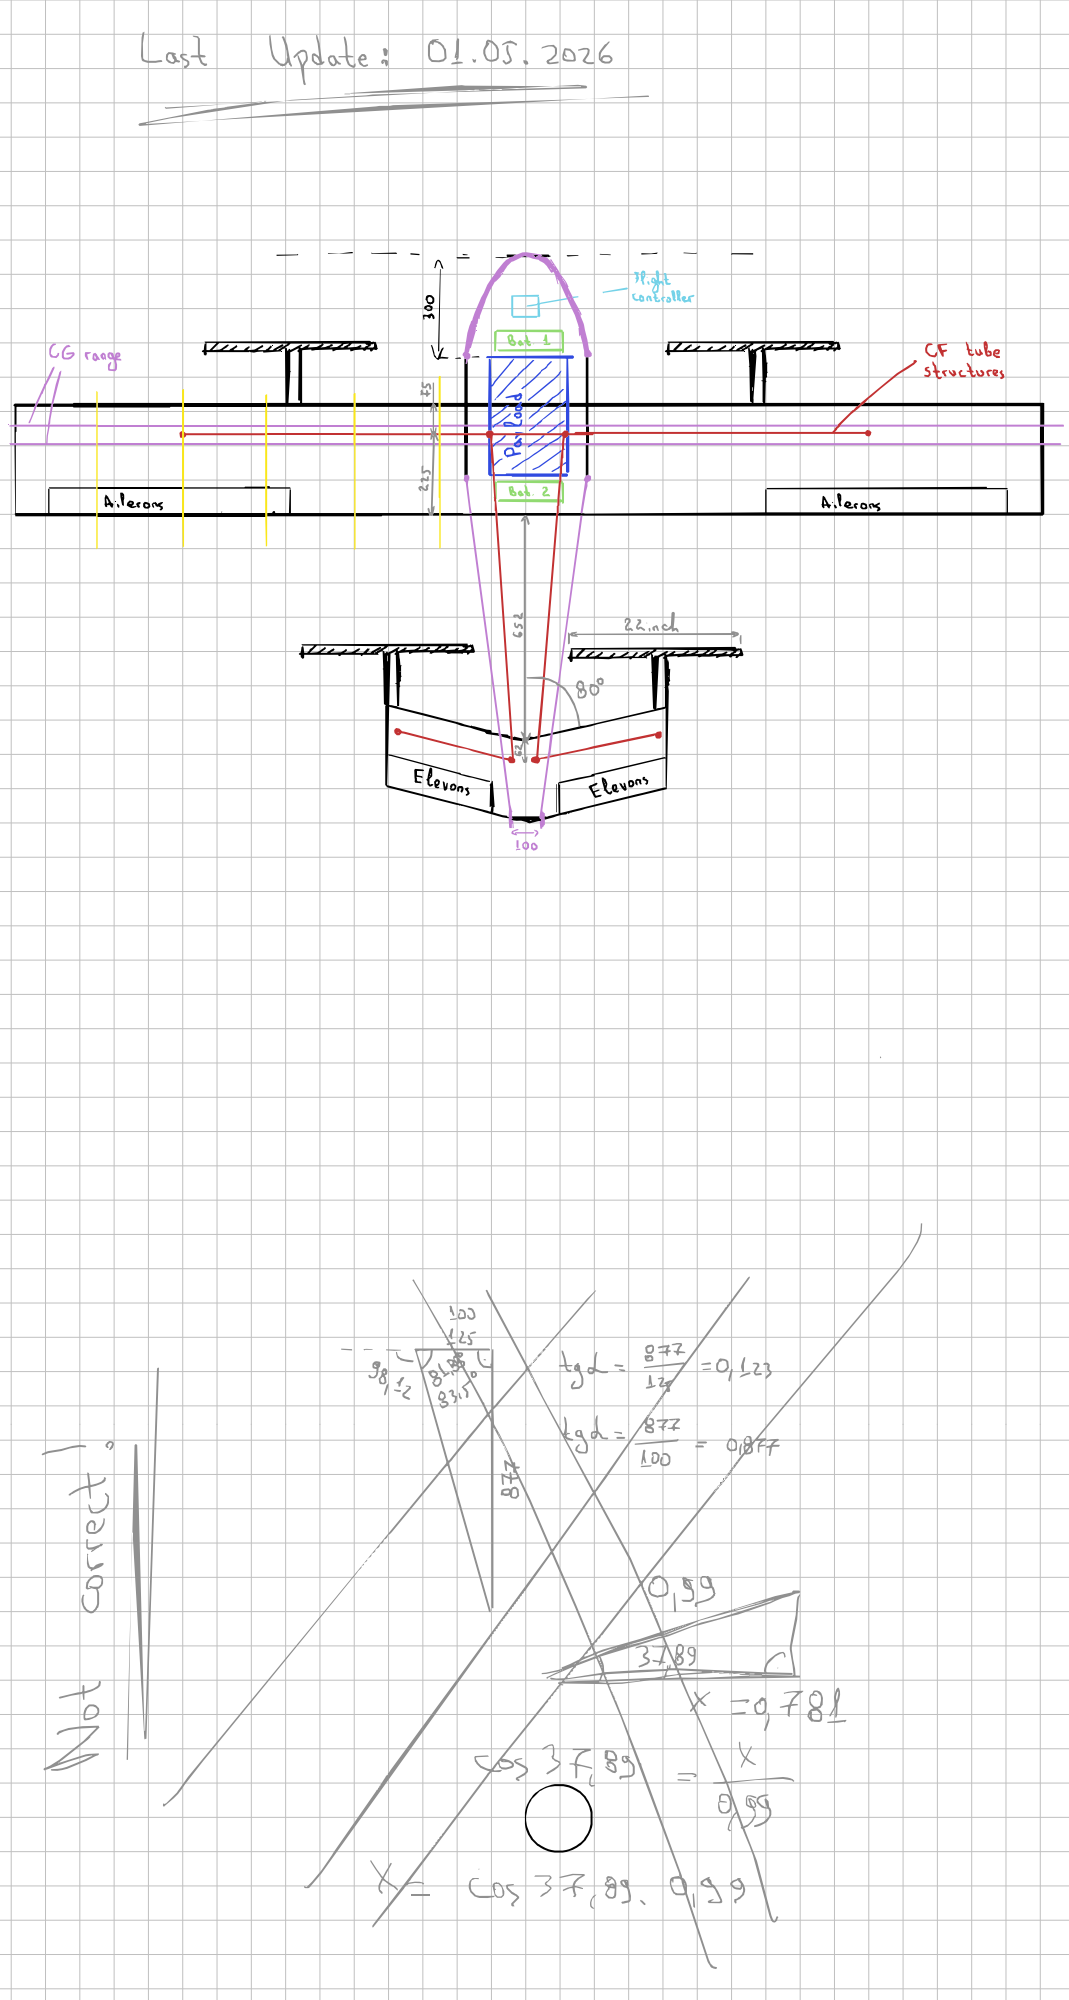
[picture p84: page 4]

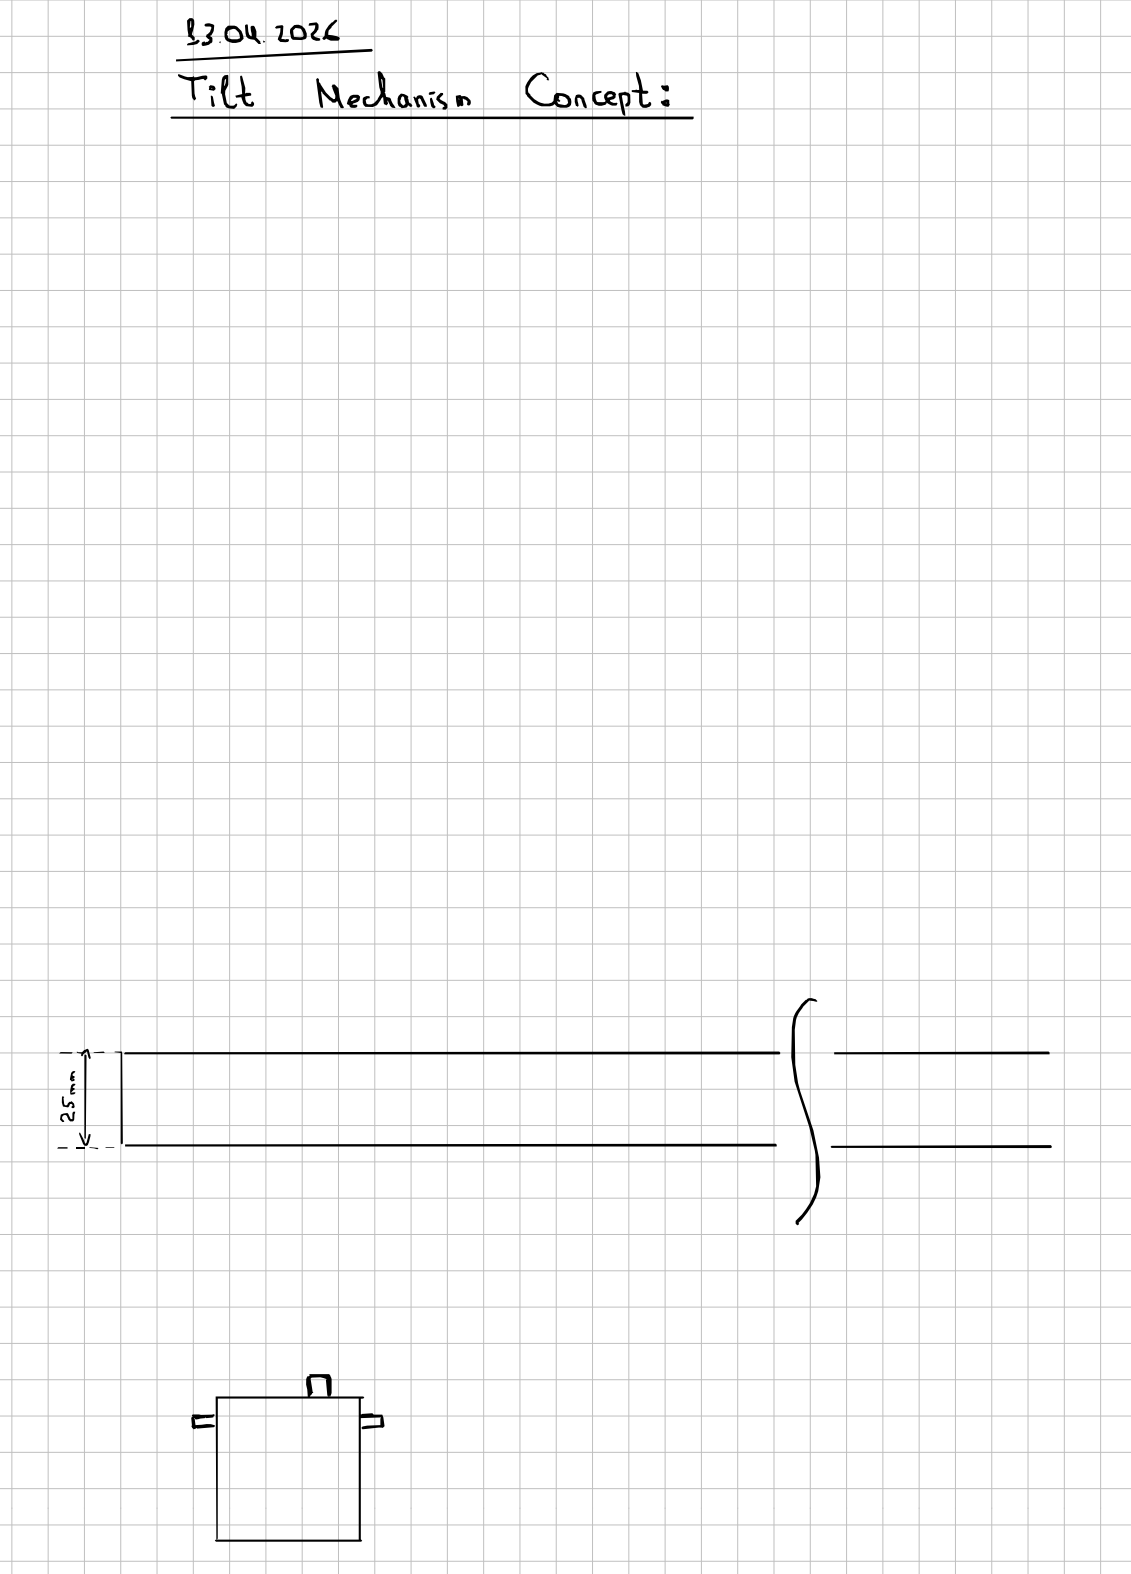
[picture p85: page 5]

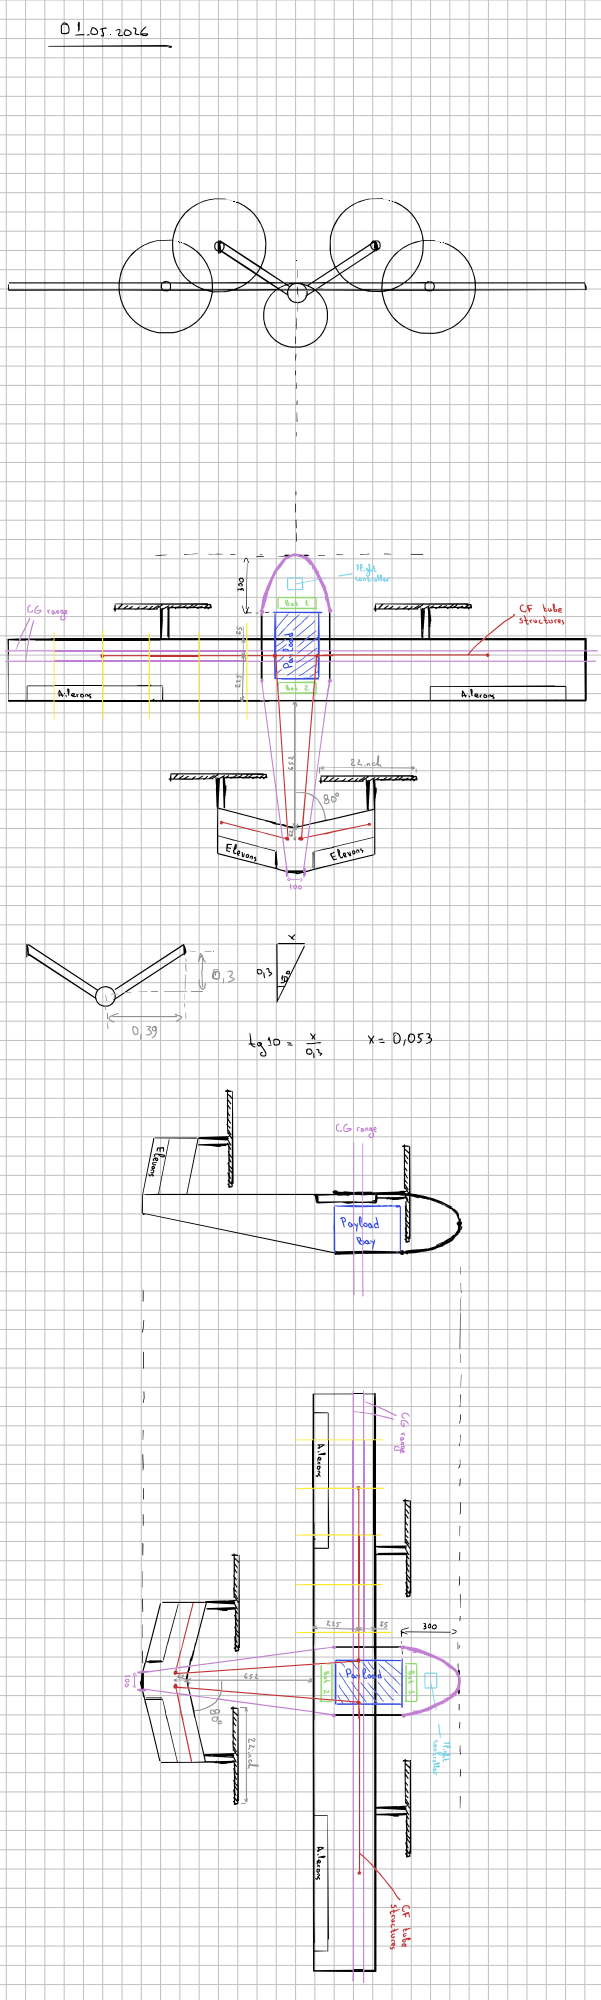
[picture p86: page 6]

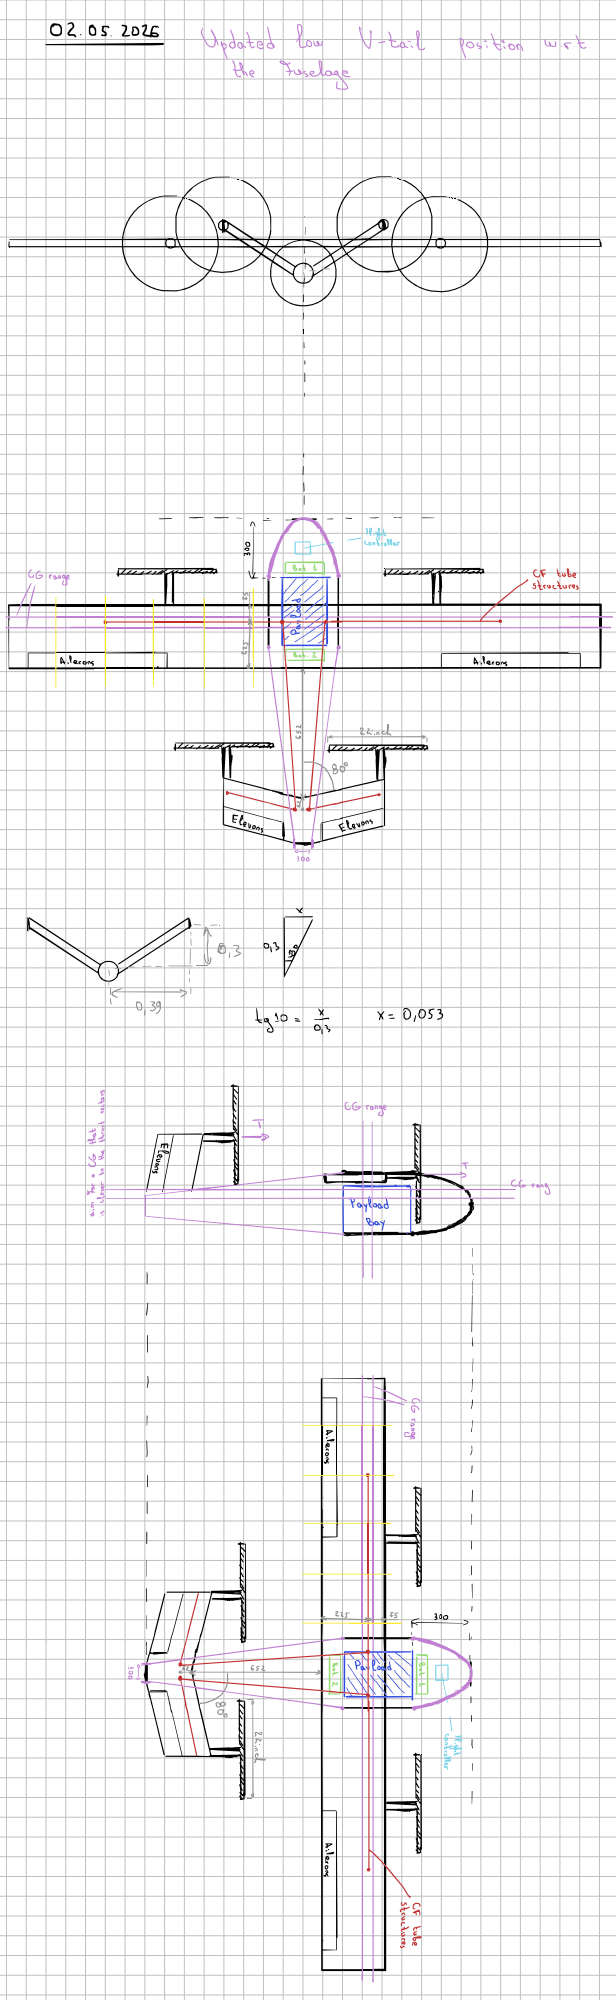
[picture p87: page 7]
