NikolaNikolow/ORGOfly-CAD-model/P01/P01_07_DIANA/Q2_26_DIANA_Application/DIANA Challenges - Short form.pdf

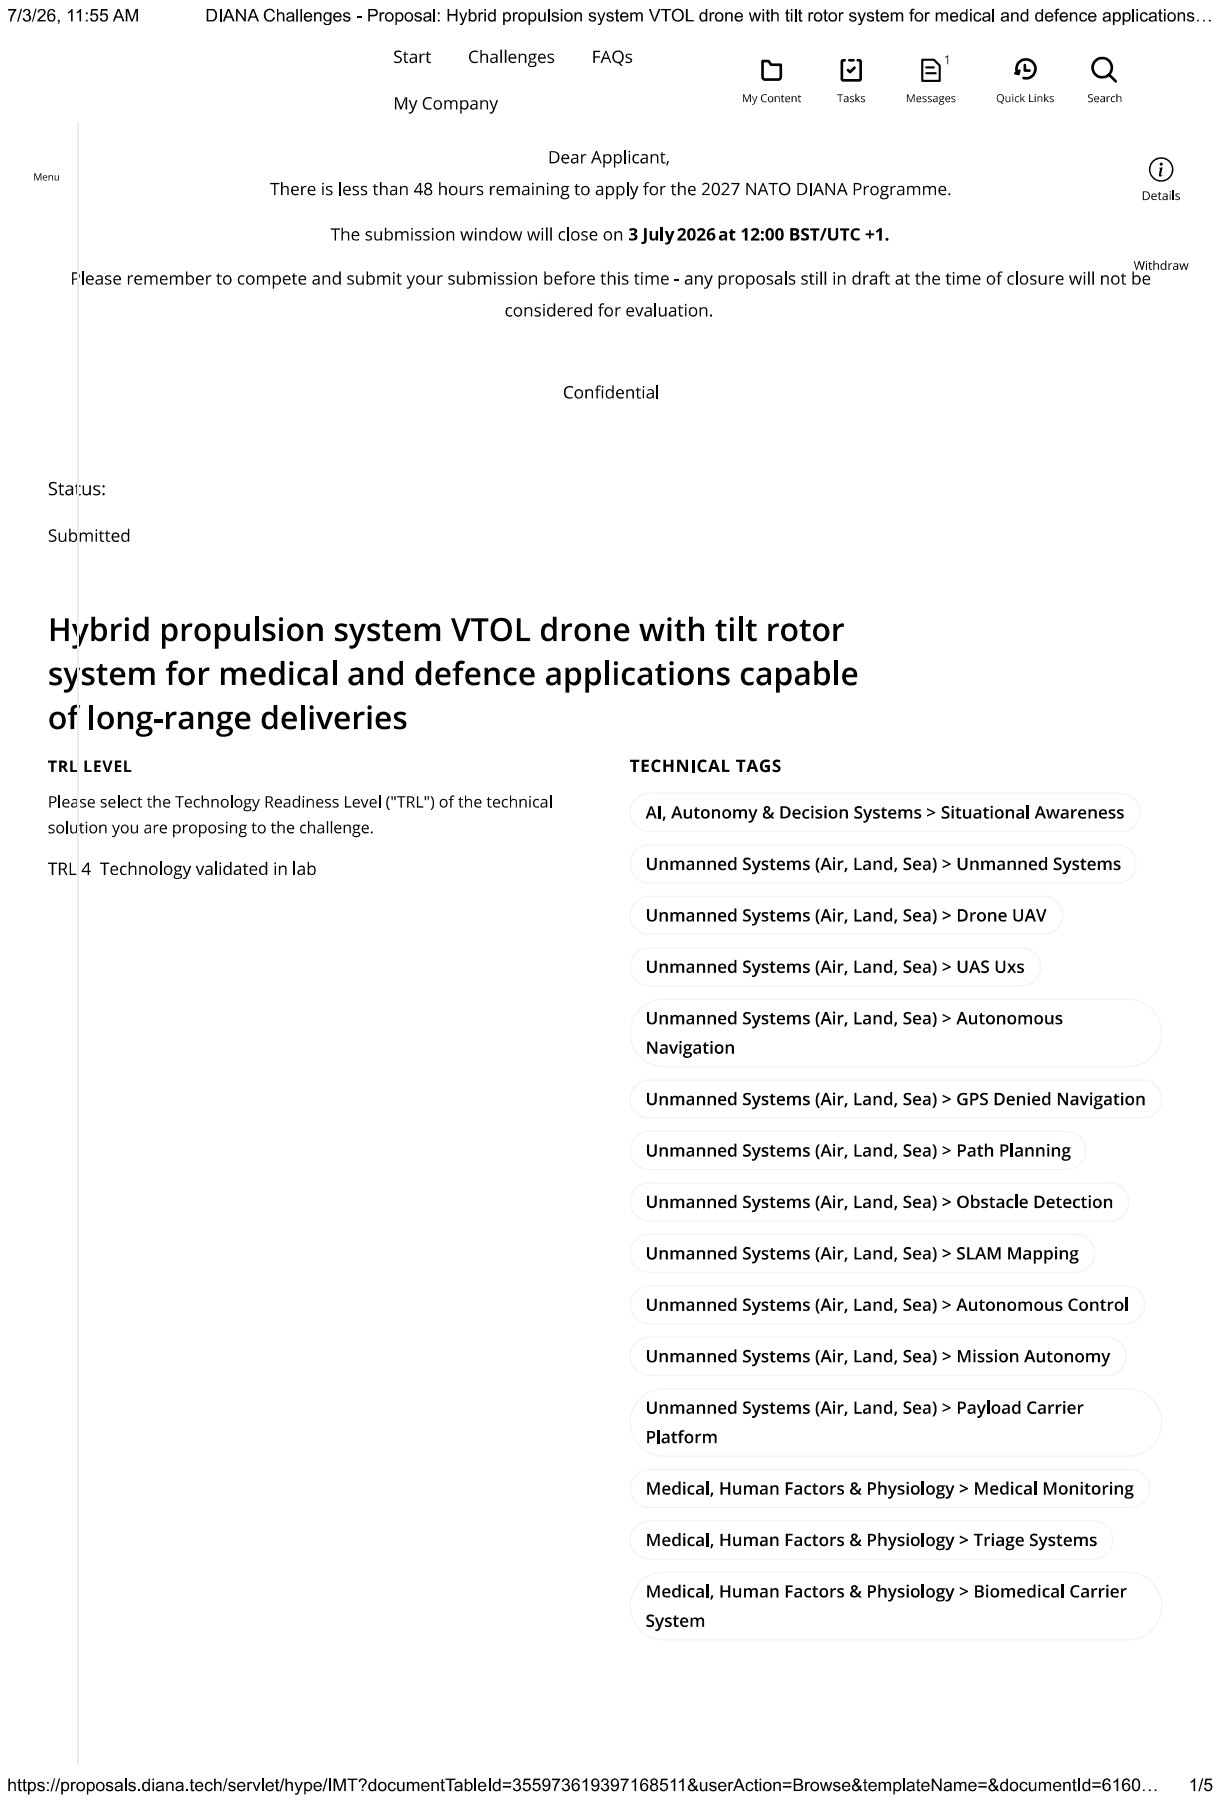
[picture p88: page 1]

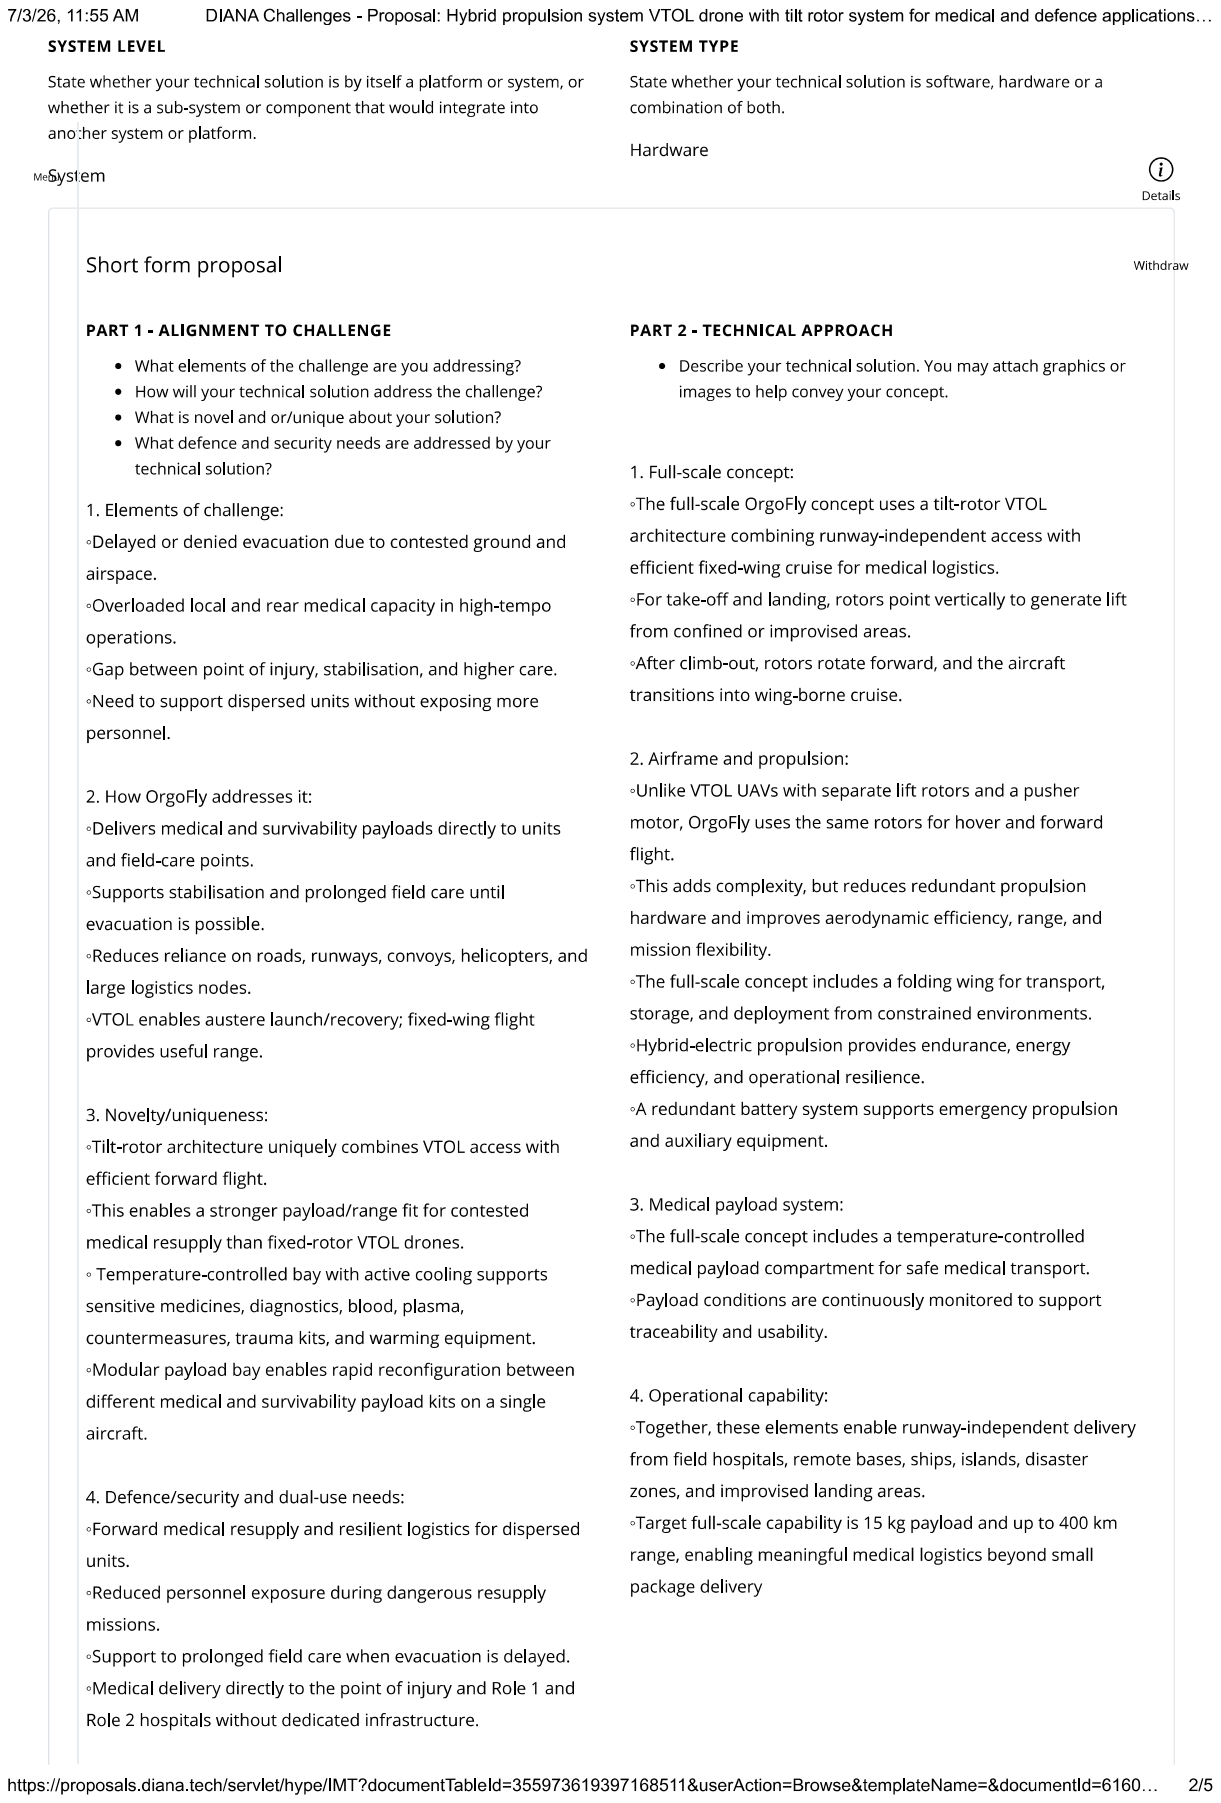
[picture p89: page 2]

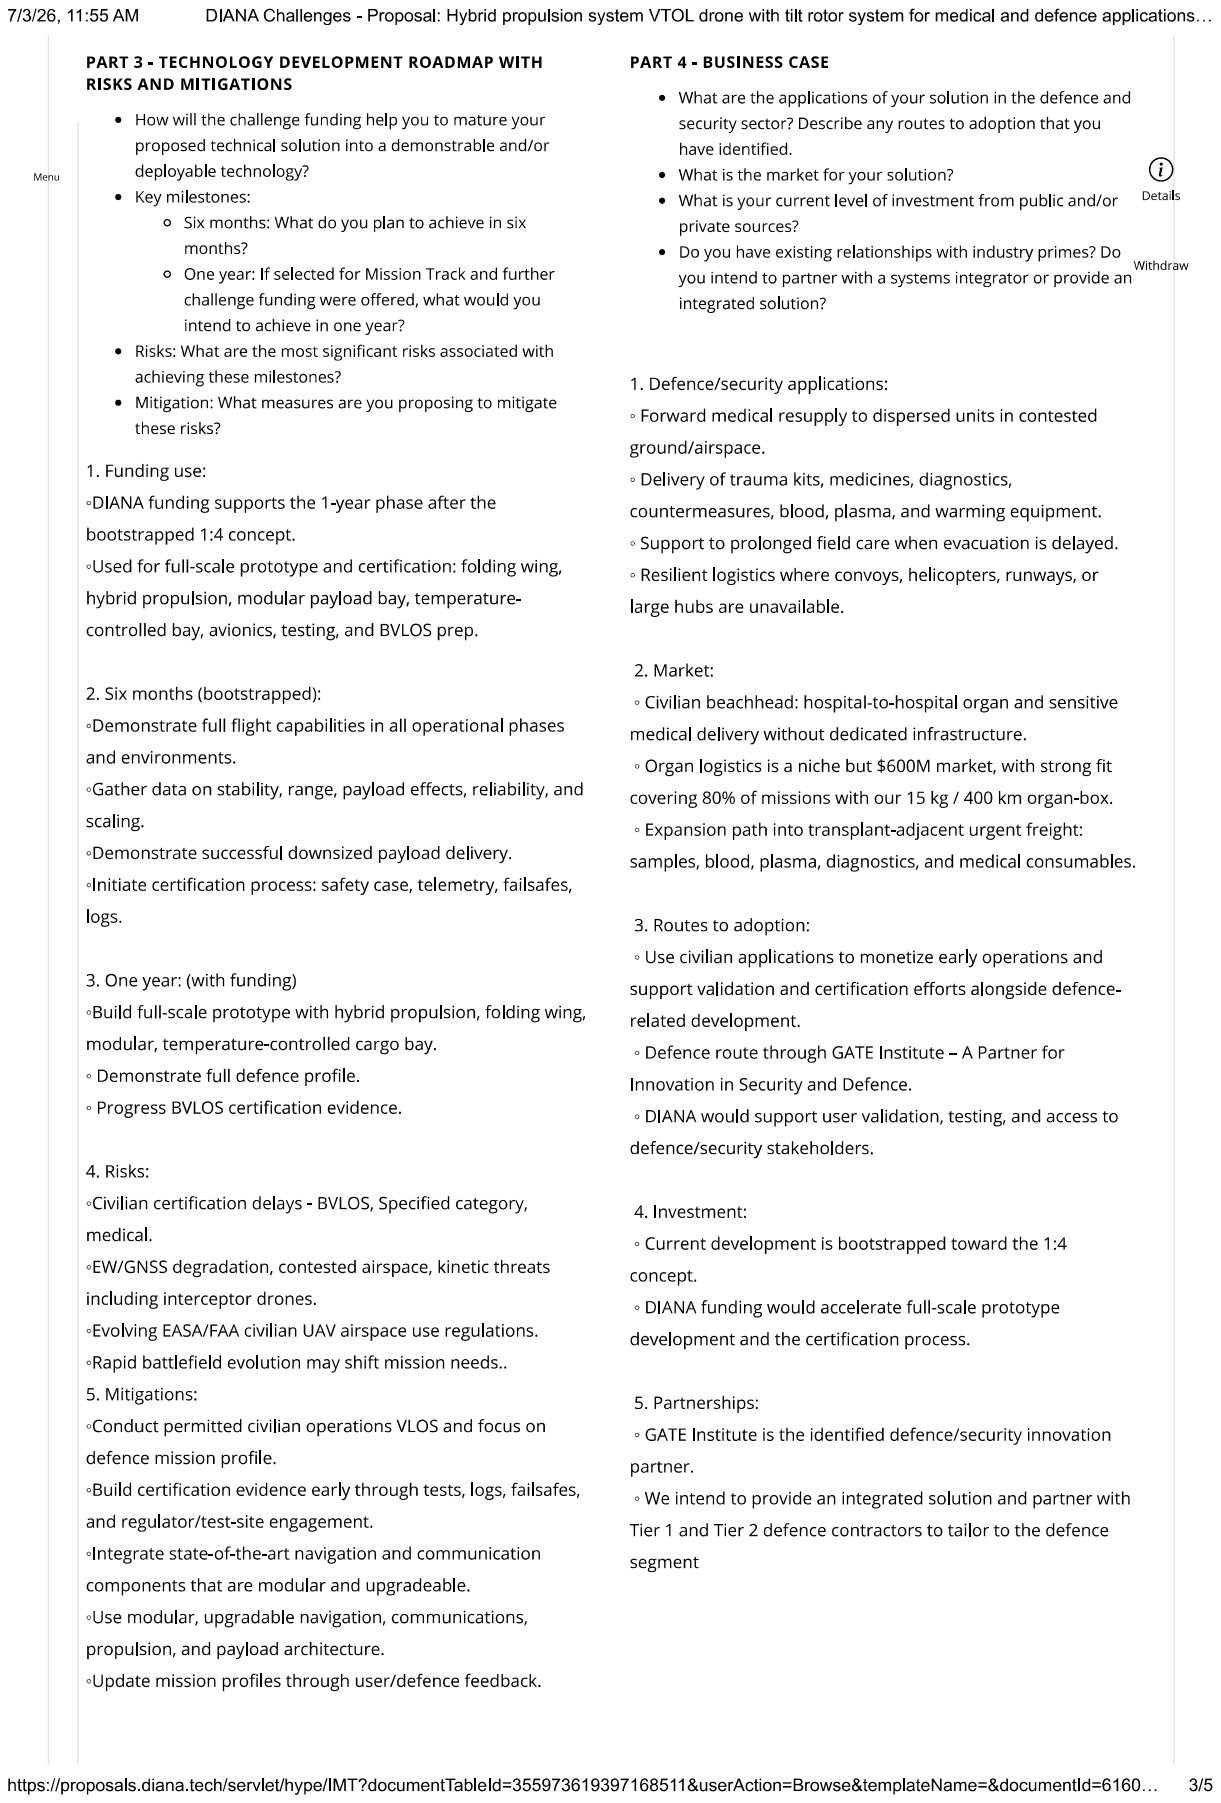
[picture p90: page 3]

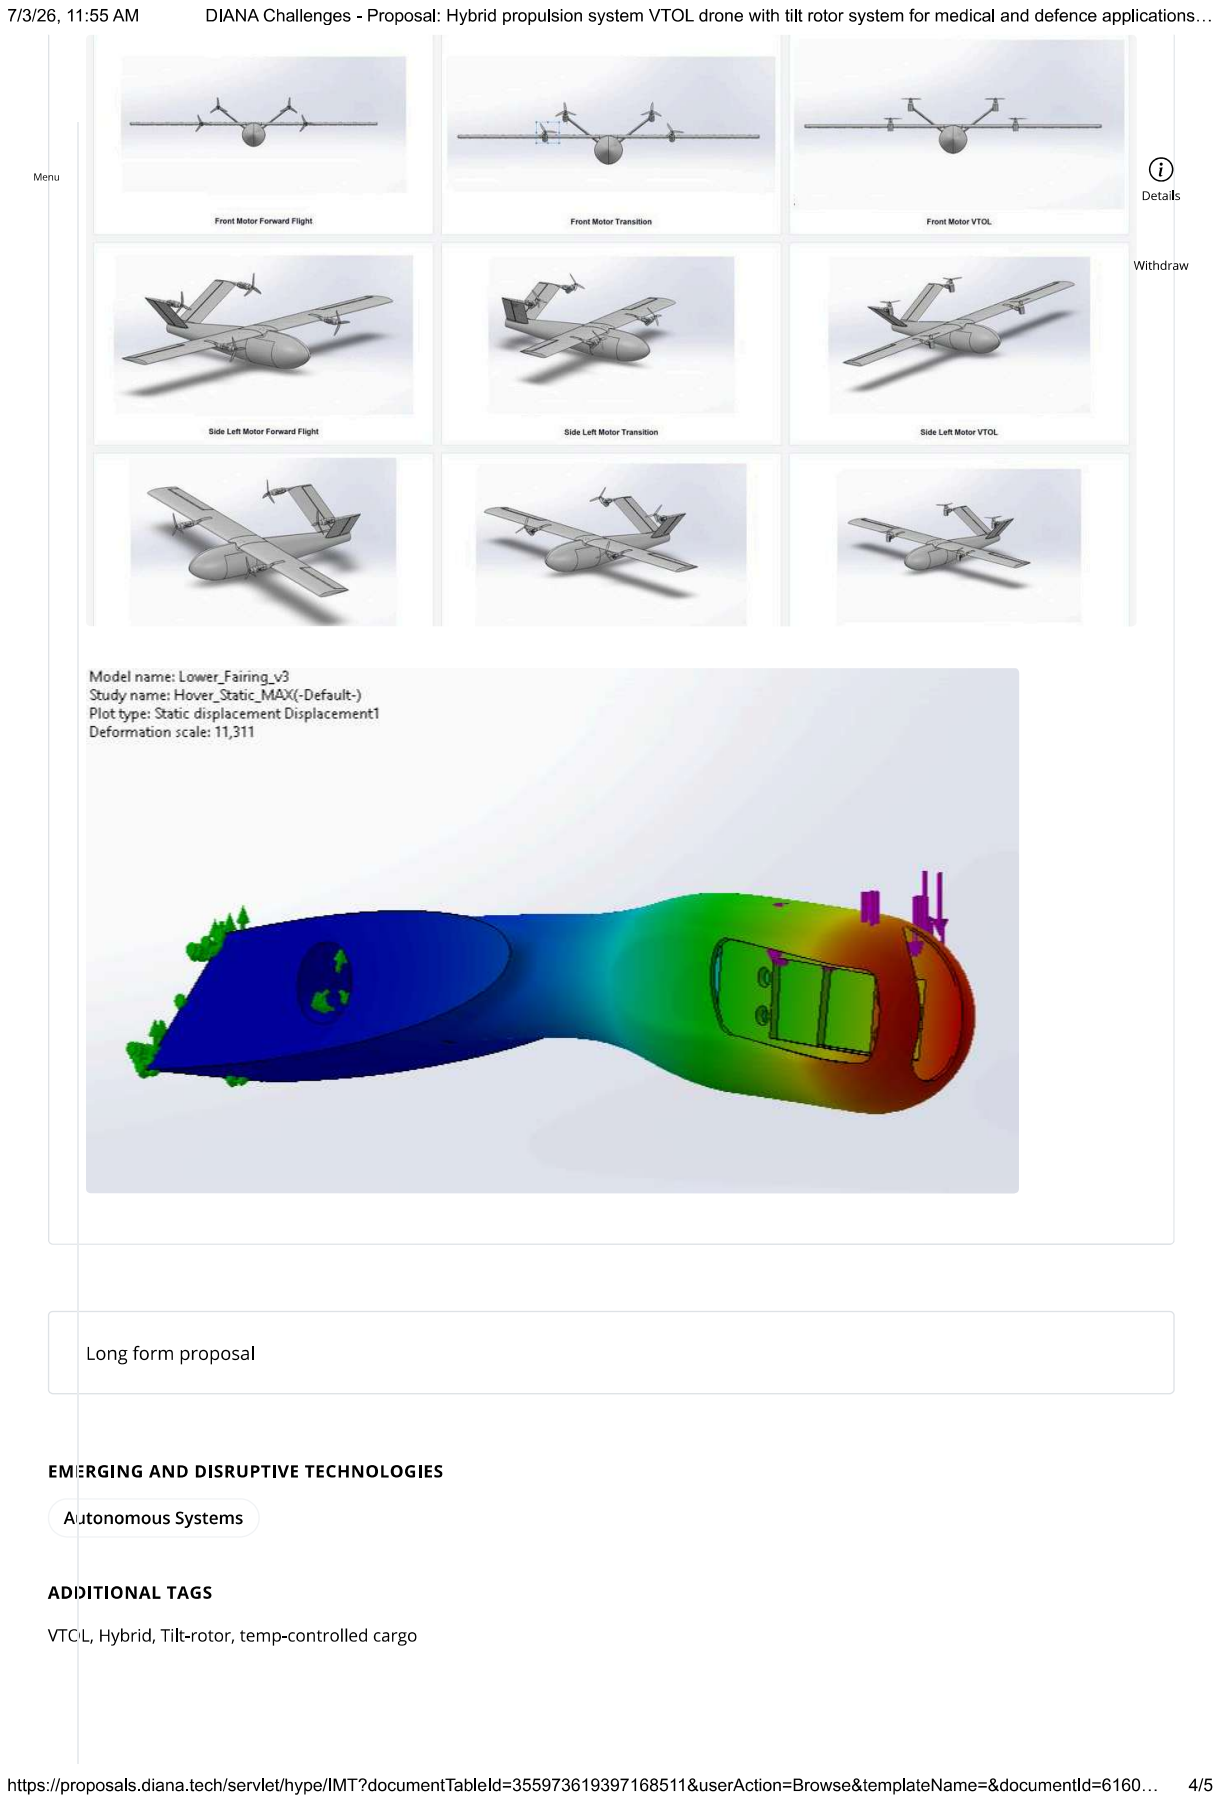
[picture p91: page 4]

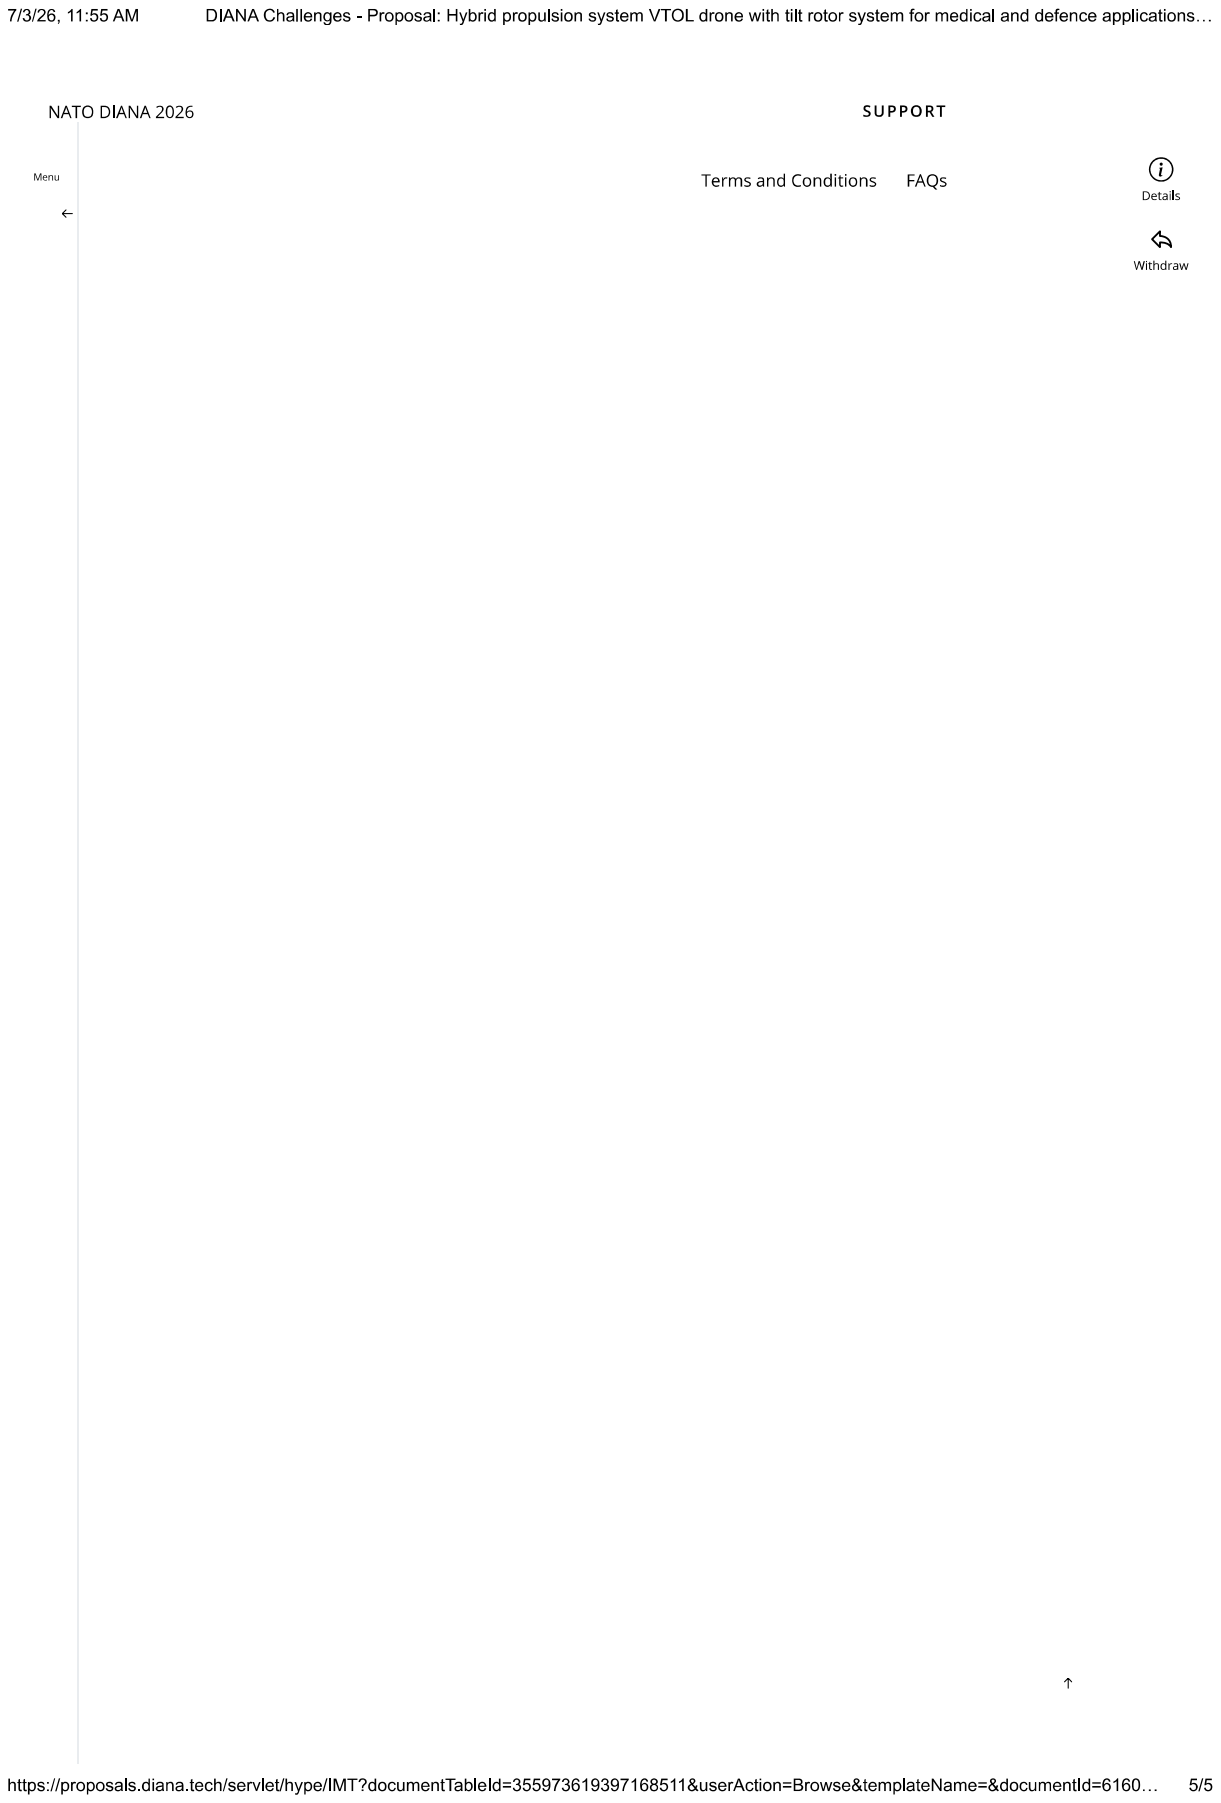
[picture p92: page 5]
