NikolaNikolow/ORGOfly-CAD-model/P01/P01-10_General/P01-10-03_Electrical_Schematic/ORGAfly_Small_Scale_Electrical.kicad_pcb

## KiCad design PCB_for_Indicator_esp32_8266/PCB_for_Indicator_esp32_8266.kicad_pcb

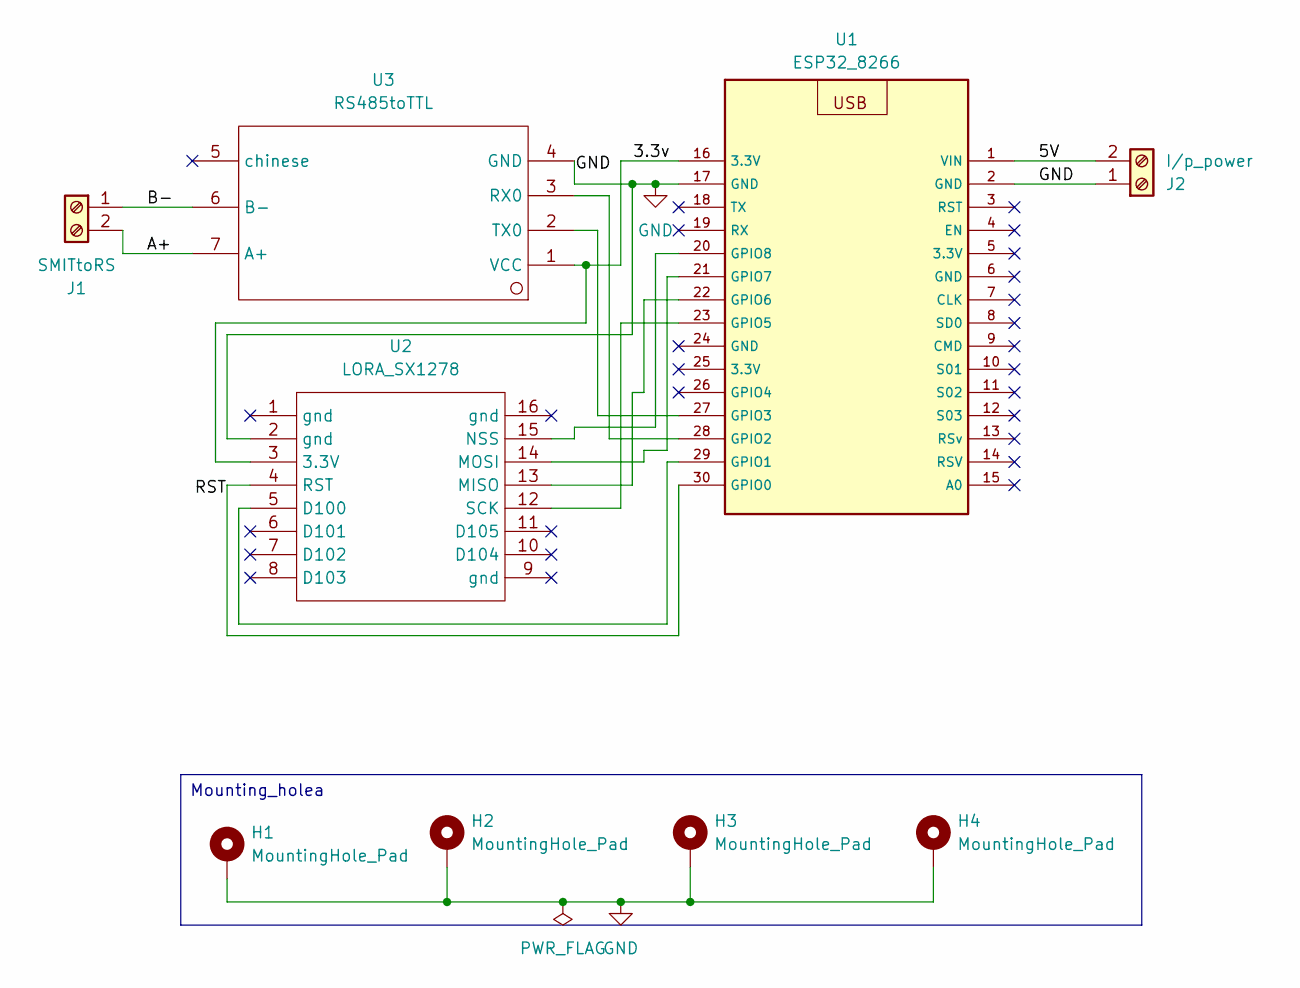
[picture p93: schematic PCB_for_Indicator_esp32_8266.kicad_sch]

Parts:
H1, H2, H3, H4: MountingHole_Pad; MountingHole_2.7mm_M2.5_Pad_Via
J1: SMITtoRS; TerminalBlock_Phoenix_MKDS-1,5-2-5.08_1x02_P5.08mm_Horizont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
J2: I/p_power; TerminalBlock_Phoenix_MKDS-1,5-2-5.08_1x02_P5.08mm_Horizont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
U1: ESP32_8266; esp32_node_mcu
U2: LORA_SX1278; LORA_02_SX1278
U3: RS485toTTL; RS485_TTL

Connections:
/3.3v: U1.16 (3.3V), U2.3 (3.3V), U3.1 (VCC)
/5V: J2.2, U1.1 (VIN)
/A+: J1.2, U3.7 (A+)
/B-: J1.1, U3.6 (B-)
/RST: U1.30 (GPIO0), U2.4 (RST)
GND: H1.1 (1_1), H2.1 (1_1), H3.1 (1_1), H4.1 (1_1), J2.1, U1.2 (GND), U1.17 (GND), U2.2 (gnd), U3.4 (GND)
unnamed: U1.29 (GPIO1), U2.5 (D100)
unnamed: U1.28 (GPIO2), U3.3 (RX0)
unnamed: U1.27 (GPIO3), U3.2 (TX0)
unnamed: U1.23 (GPIO5), U2.12 (SCK)
unnamed: U1.22 (GPIO6), U2.13 (MISO)
unnamed: U1.21 (GPIO7), U2.14 (MOSI)
unnamed: U1.20 (GPIO8), U2.15 (NSS)

Notes on the sheet:
Mounting_holea

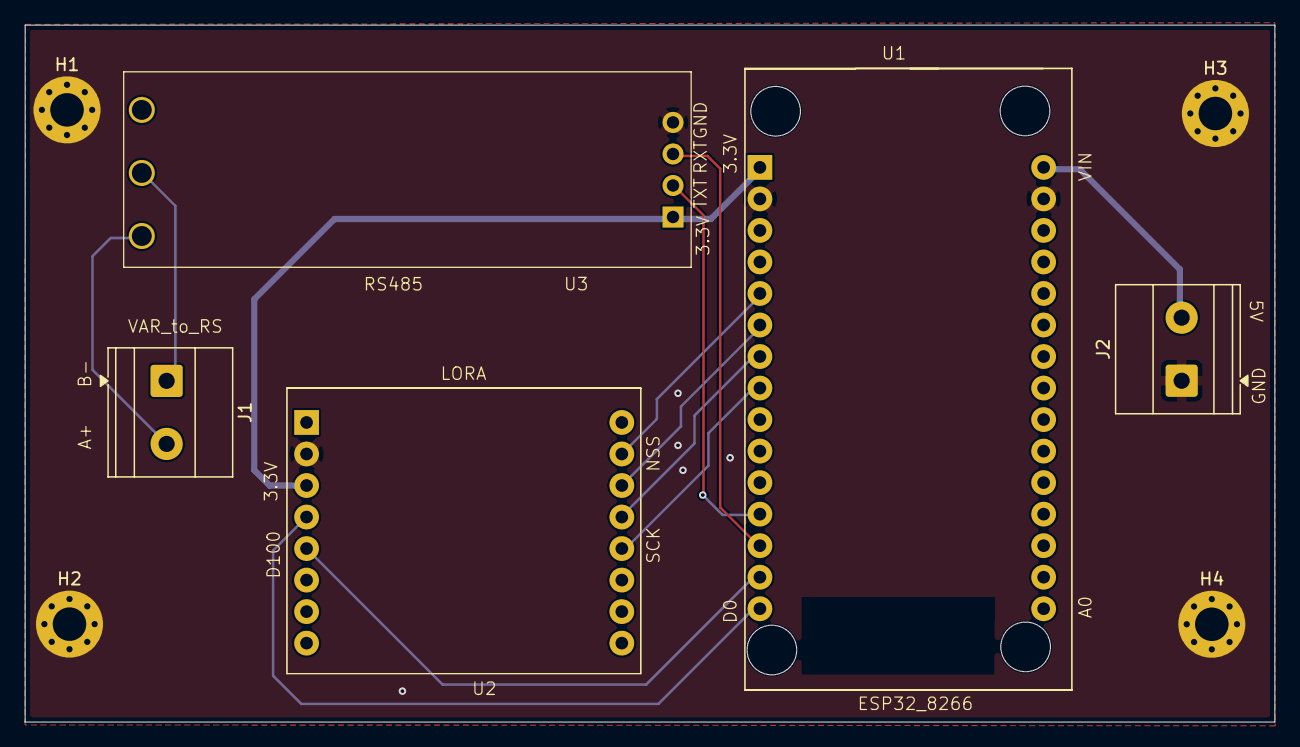
[picture p94: board PCB_for_Indicator_esp32_8266.kicad_pcb from above]

Board: 2 copper layers, 100.7 x 56.1 mm, 9 parts (0 on the bottom side), 13 nets.
