NikolaNikolow/ORGOfly-CAD-model/(commit log)

2026-01-13 Added freecad files
    [ORGOfly-BodyPad.FCStd]
2026-01-15 master layout
    [00_MasterLayout.FCStd]
2026-01-25 Wing and body linked kinda
    [00_MasterLayout.FCStd, Airfoil-Wing.FCStd]
2026-01-25 Airfoil, Wing linked ti master
    [00_MasterLayout.FCStd, Airfoil-Wing.FCStd]
2026-01-30 Created first drone body
    [Drone body.FCStd]
2026-01-30 Drone body
    [Drone body.FCStd]
2026-01-30 Drone body and RIB
    [Drone body.FCStd]
2026-02-06 Orgo body in Solidworks
    [Orgo body.STEP]
2026-02-06 Added Vertical stabilizer
    [Orgo body.STEP]
2026-02-06 Added horizontal stabilizer and airfoil text file
    [Orgo body.STEP]
2026-02-06 no changes
    [00_MasterLayout.FCStd]
2026-02-22 orgo part
    [01_Wing_NACA2412_v1.SLDPRT, 02_Fuselage_AFTsection.SLDPRT, 02_Fuselage_FWDsection.SLDPRT, 02_Fuselage_MIDsection.SLDPRT, 05_Motor_Hub.SLDPRT, 06_Rotor_representation.SLDPRT, Full_Assembly.SLDASM, Orgo body.SLDPRT]
2026-02-22 body with rotors
    [Orgo body and motors.SLDASM, Orgo body and motors.STEP]
2026-02-24 Made body, without the channel for wing
    [Body.SLDPRT]
2026-02-24 Added step file
    [Body.SLDPRT, Body.STEP]
2026-03-07 Body, Wing, Horizontal and Vertical tails
    [Body.SLDPRT, Horizontail Tail.SLDPRT, Vertical Tail.SLDPRT, Wing.SLDPRT]
2026-03-08 folder structure change
    [00_MasterLayout.FCStd, 01_Wing.FCStd, 01_Wing_NACA2412_v1.SLDPRT, 02_Fuselage.FCStd, 02_Fuselage_AFTsection.SLDPRT, 02_Fuselage_FWDsection.SLDPRT, 02_Fuselage_MIDsection.SLDPRT, 05_Motor_Hub.SLDPRT]
2026-03-22 Added the vtail surface area
    [FRONT_layout.SLDPRT]
2026-03-24 updated design excel sheet
    [Design_Formulas.xlsx]
2026-03-29 Added formulas for Polhamus
    [Design_Formulas.xlsx]
2026-03-29 calculated sweep 50%
    [Design_Formulas.xlsx]
2026-04-04 Aerodynamic center location
    [Design_Formulas.xlsx]
2026-04-08 Updated Weight and balance sheet
    [Design_Formulas.xlsx]
2026-04-09 Updated features
    [Design_Formulas.xlsx]
2026-04-24 Sliced airfoil
    [NACA2412_3Dmodel_trial.3mf]
2026-04-27 Uploaded Stl files for motor tilit mechanism
    [Base Unit L (1).STL, Base Unit L.STL, Counter Bearing.STL, Motor Carrier L long.STL, Motor Carrier R long.STL, Servo-Fixation Right.STL, Servobefestigung L.STL, Template L.STL]
2026-05-01 Update Design_Formulas.xlsx
    asdasd
    [Design_Formulas.xlsx]
2026-05-04 Updated orientation for Ntop
    [NACA2412_3Dmodel_trial_test_print.SLDPRT]
2026-05-10 Added new assembly and constructed parts for structure assembly
    [10_Assem_Structure_V-tail_v1.SLDASM, 90deg_wing_body_adaptor_3dprint.SLDPRT, Assem_Structure_V-tail_v2_3dparts.SLDASM, vtail_body_adaptor_3dprint.SLDPRT]
2026-05-11 Added folders for cad and 3d print files
    [0.09m_25x22mm_CF_tube.SLDPRT, 0.35m_25x22mm_CF_tube.SLDPRT, 0.8m_25x22mm_CF_tube.SLDPRT, 0.8m_6x4mm_CF_tube.SLDPRT, 10_Assem_Structure_T-tail_v1.SLDASM, 10_Assem_Structure_V-tail_v1.SLDASM, 1m_25x22mm_CF_tube.SLDPRT, 2m_25x22mm_CF_tube.SLDPRT]
2026-05-11 Added bambu project for attachments
    [90deg_wing_body_adaptor_3dprint.SLDPRT, 90deg_wing_body_adaptor_3dprint.STL, Attachments for wing to body and vtail.3mf, vtail_body_adaptor_3dprint.SLDPRT, vtail_body_adaptor_3dprint.STL]
2026-05-15 Added wing test section for 3dprint
    [Assem_Structure_V-tail_v2_3dparts.SLDASM]
2026-05-18 Added Folder for Avionics and added a search on electronics using ChatGPT for help
    [12S_VTOL_Electronics_Comparison_ChatGPT.xlsx]
2026-05-22 Made a wing with aileron and a new infil
    [Body1.SLDPRT, NACA2412 rotation yz.xlsx, NACA2412_3Dmodel_trial.SLDPRT, NACA2412_3Dmodel_wing_no_aileron_trial.SLDPRT, NACA2412_3Dmodel_wing_with_aileron_trial.SLDPRT, naca2412-il.csv]
2026-05-24 structure update
    [0.2m_25x22mm_CF_tube.SLDPRT, 0.55m_22x20mm_CF_tube.SLDPRT, 0.961m_22x20mm_CF_tube.SLDPRT, Adaptor_wing.SLDPRT, Main_Assembly.SLDASM]
2026-05-24 Shown to Alex
    [NACA2412_3Dmodel_wing_with_aileron_trial.SLDPRT]
2026-05-24 Split whole wing into parts for test print
    [Aileron.SLDPRT, Rest_section_wing.SLDPRT, Test_print_section_wing_new_infill.SLDPRT, Test_print_section_wing_new_infill.STL]
2026-05-24 update structures
    [Adaptor_wing.SLDPRT, Adaptor_wing_v2.SLDPRT]
2026-05-26 Updated wing
2026-05-26 Update on wing
2026-05-26 Split wing and aileron into sections
    [Aileron Section 1.SLDPRT, Aileron Section 2.SLDPRT, Aileron Section 3.SLDPRT, Section 1.SLDPRT, Section 2.SLDPRT, Section 3.SLDPRT, Section 4.SLDPRT, Section 5.SLDPRT]
2026-05-26 Split of wing and aileron
2026-05-26 Started Aileron
    [Aileron.SLDPRT, NACA0009_xz_rotated.xlsx, n0009sm-il.csv]
2026-05-27 Updated V-tail
    [Aileron.SLDPRT, V-tail.SLDPRT]
2026-05-28 Motor tilting mechanisms and electrical systems schematics
    [Avenger_3210-500KV.SLDASM, Avenger_3210-500KV_Rotor.SLDPRT, Avenger_3210-500KV_Stator.SLDPRT, Bearing 104-2Z.SLDPRT, Bearing 105-2Z.SLDPRT, HQProp_10x5x3_dummy.SLDPRT, Lower_Fairing.SLDPRT, Lower_Fairing.STL]
2026-05-31 V-tail assembly
    [0.55m_16x14mm_CF_tube.SLDPRT, Adaptor_V-tail_v4_bottom.SLDPRT, Adaptor_V-tail_v4_top.SLDPRT, Adator_V-tail_v1.SLDPRT, Adator_V-tail_v2.SLDPRT, Adator_V-tail_v3.SLDPRT, Adator_V-tail_v4.SLDPRT, Adator_V-tail_v5.SLDPRT]
2026-06-02 Created a body shell with holes for wing and vtail
    [Design_Formulas.xlsx, Fuselage_v1.1.SLDPRT, Fuselage_v1.SLDPRT, NACA0009_yz_rotated.xlsx]
2026-06-03 Added wing connection section and hole for inside
    [Fuselage_v1.1.SLDPRT]
2026-06-05 Added assembly
    [Fuselage_Structure.SLDASM, Fuselage_v1.1.SLDPRT]
2026-06-05 Tried adding a solidworks infil
    [NACA2412_3Dmodel_test.SLDPRT, Test Section.SLDPRT, Test Section.STL]
2026-06-06 Made wing and aileron
    [NACA2412_3Dmodel_test.SLDPRT, Test Section.SLDPRT]
2026-06-07 Added aileron
    [NACA2412_3Dmodel_test.SLDPRT]
2026-06-08 Added aileron servo
    [NACA2412_3Dmodel_test.SLDPRT, Servo for Aileron.SLDASM, X10_DM.STEP]
2026-06-08 Split into section for test print
    [Fuselage_v1.2_ANI.SLDPRT, NACA2412_3Dmodel_test.SLDPRT, Section 1.SLDPRT, Section 1.STL, Servo for Aileron.SLDASM]
2026-06-09 Adjusted aileron
    [Aileron.SLDPRT, NACA2412_3Dmodel_test.SLDPRT, Servo cap.SLDPRT, Servo for Aileron.SLDASM, Wing no aileron and no servo cap.SLDPRT, Wing with aileron and servo cap.SLDASM]
2026-06-10 general assembly
    [Adaptor_V-tail_v4_bottom.SLDPRT, Fuselage_v1.2_ANI.SLDPRT, Main_Assembly_Structure.SLDASM, Main_Assembly_v2.SLDASM]
2026-06-11 Started V-tail
    [V-tail.SLDPRT]
2026-06-14 main assembly V3 + new wing connection system
    [0.17m_20x18mm_CF_tube.SLDPRT, 0.1m_20x18mm_CF_tube.SLDPRT, Fuselage_v1.3_ANI.SLDPRT, Main_Assembly_v3.SLDASM, mid_part_fuselage_inner.SLDPRT, mid_part_outer.SLDPRT]
2026-06-15 restructuring of the shared github
    [0.09m_25x22mm_CF_tube.SLDPRT, 0.17m_20x18mm_CF_tube.SLDPRT, 0.2m_25x22mm_CF_tube.SLDPRT, 0.35m_25x22mm_CF_tube.SLDPRT, 0.55m_14x12mm_CF_tube.SLDPRT, 0.55m_16x14mm_CF_tube.SLDPRT, 0.55m_22x20mm_CF_tube.SLDPRT, 0.8m_25x22mm_CF_tube.SLDPRT]
2026-06-15 restructuring update
    [Body.SLDPRT, Horizontail Tail.SLDPRT, Vertical Tail.SLDPRT, Wing.SLDPRT]
2026-06-15 Electronics models
    [Avenger_3210-500KV.SLDASM, Avenger_3210-500KV.STEP, Avenger_3210-500KV_Rotor.SLDPRT, Avenger_3210-500KV_Stator.SLDPRT, Matek F405-HDTE.SLDPRT, Matek F405-HDTE.STEP, Mateksys PDB FCHUB-12S1.SLDPRT, Mateksys PDB FCHUB-12S1.STEP]
2026-06-16 Moved forward with Vtail
    [Fuselage_v1.3_ANI.SLDPRT, NACA2412_3Dmodel_test.SLDPRT, V-tail.SLDPRT]
2026-06-17 corrected fuselage and adaptor
    [Fuselage_v1.3_ANI.SLDPRT, Main_Assembly_v3.SLDASM]
2026-06-17 Moved with elevon
    [V-tail.SLDPRT]
2026-06-17 BOM update
    [BOM_ORGO-15_P1.xlsx]
2026-06-18 Adjusted v-tail
    [Avenger_3210-500KV.SLDASM, Avenger_3210-500KV_Rotor.SLDPRT, Avenger_3210-500KV_Stator.SLDPRT, Bearing 105-2Z.SLDPRT, HQProp_10x5x3_dummy.SLDPRT, Lower_Fairing_Тail_v1.SLDPRT, Machine Screw M4 х 20mm.SLDPRT, Servo_Arm.SLDPRT]
2026-06-19 Electronics BOM without links
    [BOM_ORGO-15_P1.xlsx, SQESC 12100 ESC.SLDPRT]
2026-06-20 Founders agreement
    [BOM_ORGO-15_P1.xlsx]
2026-06-21 Electronics order data
    [BOM_ORGO-15_P1.xlsx]
2026-06-23 Servo updates
    [MS4512_DM.STEP, NACA2412_3Dmodel_test.SLDPRT, Servo for Aileron.SLDASM, Wing and tilit mech.SLDASM, aileron_elevon_direct_drive_servo_selection.xlsx, aileron_elevon_servo_selection.xlsx]
2026-06-23 Added fuselage wing and vtail assembly
    [Doyono_DHC105_low_profile_26kg_approx_envelope.SLDPRT, Doyono_DHC105_low_profile_26kg_approx_envelope.step, Fus_wing_tail.SLDASM, Fuselage_v1.3_ANI.SLDPRT, NACA2412_3Dmodel_test.SLDPRT, Servo for Aileron.SLDASM, V-tail.SLDPRT]
2026-06-26 Updateing aileron
    [2100-0006-0025.STEP, 4001-0025-0006 assembly.STEP, A15-2212_DM.STEP, Fus_wing_tail.SLDASM, Fuselage_v1.4_ANI_experimental.SLDPRT, NACA2412_3Dmodel_test.SLDPRT, Servo for Aileron.SLDASM, V-tail.SLDPRT]
2026-06-26 corrected V-tail profile
    [Fuselage_v1.4_ANI.SLDPRT, Fuselage_v1.4_ANI_experimental.SLDPRT]
2026-06-27 Update wing, Vtail and fuselage
    [2800-0004-0008_90128A207_1.STEP.SLDPRT, 4001-0025-0006_1.STEP.SLDPRT, Aileron.SLDPRT, BLS662_DM_2020.STEP, BLS915_DM_20210702.STEP, Fus_vtail.SLDASM, Fuselage_v1.4_ANI.SLDPRT, NACA2412_3Dmodel_test.SLDPRT]
2026-06-28 structural assembly
    [0.55m_14x12mm_CF_tube.SLDPRT, 0.944m_22x20mm_CF_tube.SLDPRT, CF_tube_V-tail_v1.SLDPRT, Fuselage_v1.4_ANI.SLDPRT, Main_Assembly_v3.SLDASM, mid_part_fuselage_inner.SLDPRT]
2026-06-28 Updated wing and fuselage
    [Fuselage_v1.4_ANI.SLDPRT, Main_Assembly_v3.SLDASM, NACA2412_3Dmodel_test.SLDPRT, V-tail.SLDPRT]
2026-06-29 Updated assembly
    [Left_aileron.SLDPRT, Left_elevon.SLDPRT, Left_halfvtail.SLDPRT, Left_halfwing.SLDPRT, Main_Assembly_v2.SLDASM, Main_Assembly_v3.SLDASM, Right_aileron.SLDPRT, Right_elevon.SLDPRT]
2026-06-30 No change
    [Main_Assembly_v3.SLDASM]
2026-06-30 Updated Whole assembly
    [Left_elevon.SLDPRT, Left_halfvtail.SLDPRT, Main_Assembly_v3.SLDASM, Right_elevon.SLDPRT, Right_halfvtail.SLDPRT]
2026-07-01 Saved vtail as step files
    [Left_elevon.STEP, Left_halfvtail.STEP, Right_elevon.STEP, Right_halfvtail.STEP]
2026-07-01 New tail motor rotation mechanism
    [Avenger_3210-500KV.SLDASM, Avenger_3210-500KV_Rotor.SLDPRT, Avenger_3210-500KV_Stator.SLDPRT, Bearing 105-2Z.SLDPRT, HQProp_10x5x3_dummy.SLDPRT, Left_halfvtail.STEP, Lower_Fairing_Тail_v1.SLDPRT, Lower_Fairing_Тail_v2.SLDPRT]
2026-07-01 Added hole assembly
    [Fuselage_v1.4_ANI.SLDPRT, Left_aileron.SLDPRT, Left_halfwing.SLDPRT, Lower_Fairing_Тail_v2.SLDPRT, Main_Assembly.SLDASM, Main_Tilting_Mechanism.SLDASM, Right_aileron.SLDPRT, Right_elevon.SLDPRT]
2026-07-02 Updated assembly, added photos and videos
    [Cargo_Bay_v1.SLDPRT, Fuselage_v1.4_ANI.SLDPRT, Left_aileron.SLDPRT, Left_elevon.SLDPRT, Left_halfwing.SLDPRT, Lower_Fairing_Тail_v2.SLDPRT, Main_Assembly.SLDASM, Main_Tilting_Mechanism.SLDASM]
2026-07-02 Updated assmebly
    [Main_Assembly.SLDASM, Main_Tilting_Mechanism.SLDASM, MirrorAvenger_3210-500KV.SLDASM, MirrorTail_Tilting_Mechanism.SLDASM, Tail_Tilting_Mechanism.SLDASM]
2026-07-02 Upodated assembly
    [Main_Assembly.SLDASM]
2026-07-07 structure update for v tail
    [Main_Assembly_v3.SLDASM, Part5.SLDPRT, Tube_joint_top_v1.SLDPRT]
2026-07-08 update for structure
    [Main_Assembly_v3.SLDASM, Part5.SLDPRT, Tube_joint_top_v1.SLDPRT]
2026-07-11 Moved electronics to main CAD folder
    [Avenger_3210-500KV.SLDASM, Avenger_3210-500KV.STEP, Avenger_3210-500KV_Rotor.SLDPRT, Avenger_3210-500KV_Stator.SLDPRT, Matek F405-HDTE.SLDPRT, Matek F405-HDTE.STEP, Mateksys PDB FCHUB-12S1.SLDPRT, Mateksys PDB FCHUB-12S1.STEP]
2026-07-11 Added holes for fuselage to payload bay
    [Main_Assembly_v3.SLDASM, Payload_bay.SLDPRT]
2026-07-12 Split Payload and fuselage
    [Payload_bay.SLDPRT]
2026-07-12 Fuselage adjusted
2026-07-12 Updated fuselage
    [AFT_tube_joint_Bottom_v1.SLDPRT, AFT_tube_joint_Top_v1.SLDPRT, FWD_tube_joint_Bottom_Mid_v1.SLDPRT, FWD_tube_joint_Bottom_v1.SLDPRT, FWD_tube_joint_Top_v1.SLDPRT, Main_Assembly_v3.SLDASM]
2026-07-12 Added back wall to fuselage
2026-07-12 Added back wall of the fuselage
2026-07-13 update fuselage and structure
    [FWD_tube_joint_Bottom_v1.SLDPRT, FWD_tube_joint_Top_v1.SLDPRT, Main_Assembly_v3.SLDASM]
2026-07-14 Added top fuselage plate and aft panel
    [Left_aileron.SLDPRT, Left_halfwing.SLDPRT, Right_aileron.SLDPRT, Right_halfwing.SLDPRT]
2026-07-14 updated assembly with V-tail
    [CF_tube_V-tail_v1.SLDPRT, Lower_Fairing_Тail_v2.SLDPRT, Main_Assembly_v3.SLDASM, Tail_Tilting_Mechanism.SLDASM]
2026-07-14 update main assembly
    [Main_Assembly_v3.SLDASM]
2026-07-15 Ajde be bokluk
    [Avenger_3210-500KV.SLDASM, Avenger_3210-500KV_Rotor.SLDPRT, Avenger_3210-500KV_Stator.SLDPRT, Bearing 104-2Z.SLDPRT, Bearing 105-2Z.SLDPRT, FWD_tube_joint_Bottom_v1.SLDPRT, HQProp_10x5x3_dummy.SLDPRT, Left_halfvtail.STEP]
2026-07-15 Added new connector to the aft servo
    [4010-0025-0250 assembly.STEP]
2026-07-16 Made ailerons perpendicular for the tail control surfaces on the motor rotation mechanism. Split up assembly
    [Avenger_3210-500KV.SLDASM, Avenger_3210-500KV_Rotor.SLDPRT, Avenger_3210-500KV_Stator.SLDPRT, Bearing 104-2Z.SLDPRT, Bearing 105-2Z.SLDPRT, HQProp_10x5x3_dummy.SLDPRT, Left_halfvtail.STEP, Lower_Fairing.SLDPRT]
2026-07-16 Renamed assemblies
2026-07-16 Fillet and added servo shaft
    [634064.STEP, BOM_ORGO-15_P1.xlsx]
2026-07-16 Left hand tail panel lower cut under 90 deg
    [CF_tube_V-tail_v1.SLDPRT, FWD_tube_joint_Bottom_v1.SLDPRT, Main_Assembly_v3.SLDASM, Tail_Panel_LH.SLDPRT, Tail_Panel_RH.SLDPRT, Tail_Tilting_Mechanism_LH.SLDASM, Tail_Tilting_Mechanism_RH.SLDASM]
2026-07-16 Body tail connection LH
    [Main_Assembly_v3.SLDASM, Tail_Panel_LH.SLDPRT, Tail_Panel_RH.SLDPRT, Tail_Tilting_Mechanism_LH.SLDASM, Tail_Tilting_Mechanism_RH.SLDASM]
2026-07-17 Updated Assemblies for wing and rotor tilt mechanism, still have to adjust
    [Doyono_DHC105_low_profile_26kg_approx_envelope.SLDPRT, Doyono_DHC105_low_profile_26kg_approx_envelope.step, MS4512_DM.STEP, Main_Tilting_Mechanism_RH.SLDASM, Wing_motor_servo_assembly_RH.SLDASM, aileron_elevon_direct_drive_servo_selection.xlsx, aileron_elevon_servo_selection.xlsx]
2026-07-17 Updated BOM
    [BOM_ORGO-15_P1.xlsx]
2026-07-18 Opened solidwork files
    [Main_Tilting_Mechanism_RH.SLDASM, Wing_motor_servo_assembly_RH.SLDASM]
2026-07-18 LH tail motor rotation mechanism split and integrated
    [Left_elevon.SLDPRT, Main_Assembly_v3.SLDASM, Main_Tilting_Mechanism_RH.SLDASM, Tail_Panel_LH.SLDPRT, Tail_Panel_RH.SLDPRT, Tail_Tilting_Mechanism_LH.SLDASM, Tail_Tilting_Mechanism_RH.SLDASM]
2026-07-18 Fixed aileron to servo connection
    [4010-0025-0250 assembly.SLDASM, BOM_ORGO-15_P1.xlsx, Dummy_model_5_45_shaft.SLDPRT, Dummy_model_5_60_shaft.SLDPRT, Dummy_model_servo_shaft_coupler.SLDPRT, Wing_motor_servo_assembly_RH.SLDASM]
2026-07-18 Reverted tiltingf mechanism commit
    [Main_Tilting_Mechanism_RH.SLDASM]
2026-07-18 main_tilt_mechanism_RH_added after being deleted
    [Main_Tilting_Mechanism_RH.SLDASM]
2026-07-18 Made wing assembly with tilt rotor mechanism
    [BOM_ORGO-15_P1.xlsx, NACA2412_Profile.SLDPRT, Wing_motor_servo_assembly_RH.SLDASM]
2026-07-19 Aileron panels pins
    [Avenger_3210-500KV.SLDASM, Avenger_3210-500KV_Rotor.SLDPRT, Avenger_3210-500KV_Stator.SLDPRT, Bearing 105-2Z.SLDPRT, CF_tube_V-tail_v1.SLDPRT, HQProp_10x5x3_dummy.SLDPRT, Left_elevon.SLDPRT, Left_halfvtail.STEP]
2026-07-19 RH Tail Assembly
    [Main_Assembly_v3.SLDASM, Tail_Panel_RH.SLDPRT, Tail_Tilting_Mechanism_RH.SLDASM, Upper_Fairing_RH.SLDPRT]
2026-07-20 CF Tube Integrated. Tail Assembly Moved
    [AFT_tube_joint_Bottom_v1.SLDPRT, AFT_tube_joint_Top_v1.SLDPRT, Avenger_3210-500KV.SLDASM, Avenger_3210-500KV_Rotor.SLDPRT, Avenger_3210-500KV_Stator.SLDPRT, Bearing 105-2Z.SLDPRT, HQProp_10x5x3_dummy.SLDPRT, Left_halfvtail.STEP]
2026-07-21 Tried Adjusting V-tail
    [AFT_tube_joint_Bottom_v1.SLDPRT, AFT_tube_joint_Top_v1.SLDPRT, Fuselage_to_vtail.SLDPRT, Main_Assembly_v3.SLDASM, Main_Assembly_v3_tail_test.SLDASM, RH_vtail.SLDASM, Tail_Assembly_LH.SLDASM, Tail_Assembly_RH.SLDASM]
2026-07-21 Updated Vtail
    [Fuselage_to_vtail.SLDPRT, Main_Assembly_v3.SLDASM, Main_Assembly_v3_tail_test.SLDASM, RH_vtail.SLDASM, Vtail_to_motor.SLDPRT]
2026-07-21 Cleaning tilt mechanism up
    [Tail_Assembly_LH.SLDASM]
2026-07-22 Adjusted Vtail and Aileron
    [Elevon_Fuselage_to_Vtail.SLDPRT, Elevon_Vtail_to_Motor.SLDPRT, Fuselage_to_vtail.SLDPRT, Main_Assembly_v3.SLDASM, RH_vtail.SLDASM, Tail_Assembly_LH.SLDASM, Tail_Panel_LH.SLDPRT, V-tail.SLDPRT]
2026-07-22 Adjusted Vtail infill and guide for cables to the motor mechanism
    [Fuselage_to_vtail.SLDPRT, Main_Assembly_v3.SLDASM, Main_Assembly_v3_tail_test.SLDASM, Tail_Assembly_LH.SLDASM, Tail_Assembly_RH.SLDASM, Vtail_to_motor.SLDPRT]
2026-07-22 Added wing servo closing lid
    [0.55m_22x20mm_CF_tube.SLDPRT, Main_Assembly_v3.SLDASM, Main_Assembly_v3_tail_test.SLDASM]
2026-07-22 Split Wing into Sections for printing
    [Aileron Section 1.SLDPRT, Aileron Section 2.SLDPRT, Aileron Section 3.SLDPRT, Aileron_Middle.SLDPRT, Aileron_Root.SLDPRT, Aileron_Tip.SLDPRT, Section 1.SLDPRT, Section 1.STL]
2026-07-22 Moved some files from NACA2412 and started assembling the wing
    [2100-0006-0025.STEP, 2800-0004-0008_90128A207_1.STEP.SLDPRT, 4001-0025-0006 assembly.STEP, 4001-0025-0006_1.STEP.SLDPRT, 4010-0025-0250 assembly.SLDASM, 4010-0025-0250 assembly.STEP, 634064.STEP, A15-2212_DM.STEP]
2026-07-23 Added hole in fuselage for Vtail cables, assembled cut wing and added guide for cables in wing
    [Aileron_Middle.SLDPRT, Aileron_Root.SLDPRT, Aileron_Tip.SLDPRT, Elevon_Fuselage_to_Vtail.SLDPRT, Elevon_Vtail_to_Motor.SLDPRT, Fuselage_to_vtail.SLDPRT, RH_Wing_Aileron.SLDASM, Vtail_to_motor.SLDPRT]
2026-07-23 Moved panels to tail folder
    [Elevon_Fuselage_to_Vtail.SLDPRT, Elevon_Vtail_to_Motor.SLDPRT, Fuselage_to_vtail.SLDPRT, Tail_Assembly_LH.SLDASM, Vtail_to_motor.SLDPRT]
2026-07-23 Made wing tip lid
    [Main_Assembly_v3_tail_test.SLDASM, RH_Wing_Aileron.SLDASM, Wing_Tip_Section.SLDPRT, Wing_Tip_Section_Next.SLDPRT]
2026-07-24 Fix assembly - missing reference points for some of the structure parts
    [AFT_tube_joint_Bottom_v1.SLDPRT, AFT_tube_joint_Top_v1.SLDPRT, FWD_tube_joint_Bottom_v1.SLDPRT]
2026-07-24 minor updates on the RH wing assembly
    [Aileron_Middle.SLDPRT, Aileron_Root.SLDPRT, Aileron_Tip.SLDPRT, RH_Wing_Aileron.SLDASM, WIng_Tip_Section_Next_Next.SLDPRT, Wing_Motor_Mech_Section.SLDPRT, Wing_Root_Section.SLDPRT, Wing_Root_Section_Next.SLDPRT]
2026-07-24 added CAD files organizational structure document
2026-07-24 LH Tail Carbon Tube Attachment
    [Elevon_Fuselage_to_Vtail.SLDPRT, Fuselage_to_vtail.SLDPRT, Machine Screw M4 х 15mm.SLDPRT, Machine Screw M4 х 20mm.SLDPRT, Machine Screw M4 х 30mm.SLDPRT, Machine Screw M4 х 35mm.SLDPRT, Machine Screw M4 х 45mm.SLDPRT, Pin_Elevon.SLDPRT]
2026-07-25 Elevon deflection mechanism updated in the assembly; bearing dummy model included
    [Dummy_model_5_10_4_bearing.SLDPRT, Dummy_model_5_60_shaft.SLDPRT, Tail_Assembly_RH.SLDASM]
2026-07-25 Elevon Attachment to Tail Motor Assembly. LH and RH
    [Avenger_3210-500KV.SLDASM, Elevon_Fuselage_to_Vtail.SLDPRT, Elevon_Vtail_to_Motor.SLDPRT, Fuselage_to_vtail.SLDPRT, Left_halfvtail.STEP, Lower_Elevon.SLDPRT, Machine Screw M4 х 15mm.SLDPRT, Machine Screw M4 х 20mm.SLDPRT]
2026-07-26 Main motor assembly dual side wing profile corrected and added to main assembly
    [Avenger_3210-500KV.SLDASM, Avenger_3210-500KV_Rotor.SLDPRT, Avenger_3210-500KV_Stator.SLDPRT, Bearing 105-2Z.SLDPRT, HQProp_10x5x3_dummy.SLDPRT, Lower_Fairing_Lid_Main_RH.SLDPRT, Lower_Fairing_Main_LH.SLDPRT, Lower_Fairing_Main_Lid_LH.SLDPRT]
2026-07-27 New file organisation structure
    [0.09m_25x22mm_CF_tube.SLDPRT, 0.17m_20x18mm_CF_tube.SLDPRT, 0.2m_25x22mm_CF_tube.SLDPRT, 0.35m_25x22mm_CF_tube.SLDPRT, 0.55m_16x14mm_CF_tube.SLDPRT, 0.55m_22x20mm_CF_tube.SLDPRT, 0.8m_25x22mm_CF_tube.SLDPRT, 0.8m_6x4mm_CF_tube.SLDPRT]
2026-07-27 Some cleanup
    [0.09m_25x22mm_CF_tube.SLDPRT, 0.17m_20x18mm_CF_tube.SLDPRT, 0.2m_25x22mm_CF_tube.SLDPRT, 0.35m_25x22mm_CF_tube.SLDPRT, 0.55m_16x14mm_CF_tube.SLDPRT, 0.55m_22x20mm_CF_tube.SLDPRT, 0.8m_25x22mm_CF_tube.SLDPRT, 0.8m_6x4mm_CF_tube.SLDPRT]
2026-07-28 Organised non-technical documents
    [0.09m_25x22mm_CF_tube.SLDPRT, 0.17m_20x18mm_CF_tube.SLDPRT, 0.2m_25x22mm_CF_tube.SLDPRT, 0.35m_25x22mm_CF_tube.SLDPRT, 0.55m_16x14mm_CF_tube.SLDPRT, 0.55m_22x20mm_CF_tube.SLDPRT, 0.8m_25x22mm_CF_tube.SLDPRT, 0.8m_6x4mm_CF_tube.SLDPRT]
2026-07-28 Deleting the folder with the original file structure
    [0.09m_25x22mm_CF_tube.SLDPRT, 0.17m_20x18mm_CF_tube.SLDPRT, 0.2m_25x22mm_CF_tube.SLDPRT, 0.35m_25x22mm_CF_tube.SLDPRT, 0.55m_16x14mm_CF_tube.SLDPRT, 0.55m_22x20mm_CF_tube.SLDPRT, 0.8m_25x22mm_CF_tube.SLDPRT, 0.8m_6x4mm_CF_tube.SLDPRT]
2026-07-28 Moved aileron hole on tail motor lower fairing
    [P01-40-01-01_260727_Tailplane.SLDPRT, P01-40-01_260727_Tail_LH.SLDASM, P01-40-02-02_260727_CF_Tube.SLDPRT, P01-50-03_260724_Tail_Motor_LH.SLDASM, P01-50-04_260724_Motor_Tail_RH.SLDASM]
2026-07-28 updated guidelines for CAD files - to be further updated
2026-08-06 slightly updated BOM
    [Table_260719_BOM.xlsx]
2026-08-07 Wing Assembly Updated; Servo Mount Added; Smaller CF Tube added;
    [0.55m_22x20mm_CF_tube.SLDPRT, 20x18mm_CF_tube.SLDPRT, 22x20mm_CF_tube.SLDPRT, 6x4mm_CF_tube.SLDPRT, BLS662_DM_2020.STEP, Dummy_model_5_10_4_bearing.SLDPRT, Dummy_model_5_60_shaft.SLDPRT, Dummy_model_servo_shaft_coupler.SLDPRT]
2026-08-08 Wing Assembly - Errors corrected in the assembly
    [P01-30-02-04_260724_Wing_Servo_Section_RH.SLDPRT, P01-30-02-06_260724_Wing_Section_RH.SLDPRT, P01-30-02_Wing_RH.SLDASM, P01-30-03-01_260807_Servo_Mount.SLDPRT, P01-30-03_Servo_and_ShaftCoupler_ServoMount_Assembly.SLDASM, P01-30-03_Servo_and_Shaft_Coupler_Assembly.SLDASM]
2026-08-08 Wing Assembly - Errors updated
    [BLS662_DM_2020.SLDPRT, P01-30-02-01_260724_Wing_Root_RH.SLDPRT, P01-30-02-02_260724_Wing_Section_RH.SLDPRT, P01-30-02-03_260724_Wing_Motor_Section_RH.SLDPRT, P01-30-02-04_260724_Wing_Servo_Section_RH.SLDPRT, P01-30-02-05_260724_Wing_Section_RH.SLDPRT, P01-30-02-06_260724_Wing_Section_RH.SLDPRT, P01-30-02-07_260724_Wing_Tip_RH.SLDPRT]
2026-08-08 V-Tail mates
    [P01-20-02_Frame.SLDASM, P01-30-02_Wing_RH.SLDASM, P01-30-03_Servo_and_ShaftCoupler_ServoMount_Assembly.SLDASM]
2026-08-09 updated BOM with structural CF tubes
    [Table_260719_BOM.xlsx]
2026-08-15 minor Wing assembly fixes
    [P01-30-02-01_260724_Wing_Root_RH.SLDPRT, P01-30-02-02_260724_Wing_Section_RH.SLDPRT, P01-30-02-03_260724_Wing_Motor_Section_RH.SLDPRT, P01-30-02-04_260724_Wing_Servo_Section_RH.SLDPRT, P01-30-02-05_260724_Wing_Section_RH.SLDPRT, P01-30-02-06_260724_Wing_Section_RH.SLDPRT, P01-30-02-07_260724_Wing_Tip_RH.SLDPRT, P01-30-02-08_260724_Aileron_Root_RH.SLDPRT]
2026-08-15 Cargo bay
    [P01-80-01_260715_Payload_bay.SLDASM]
2026-08-16 Wing Assembly finalized
    [20x18mm_CF_tube.SLDPRT, P01-30-02-01_260724_Wing_Root_RH.SLDPRT, P01-30-02-02_260724_Wing_Section_RH.SLDPRT, P01-30-02-03_260724_Wing_Motor_Section_RH.SLDPRT, P01-30-02-04_260724_Wing_Servo_Section_RH.SLDPRT, P01-30-02-05_260724_Wing_Section_RH.SLDPRT, P01-30-02-06_260724_Wing_Section_RH.SLDPRT, P01-30-02-07_260724_Wing_Tip_RH.SLDPRT]
2026-08-16 fuselage updated - start to design the servo fixture
2026-08-16 Updated elevon rotation mechanism servo mount
    [P01-40-05-01_260816_Servo_Mount_Elevons.SLDPRT, P01-40-05_260727_Control_Mechanism_LH.SLDASM]
2026-08-18 Manual locks on the payload bay
    [MOSECYOU_6in_French_Door_Lock.SLDASM, MOSECYOU_6in_French_Door_Lock_Body.SLDPRT, MOSECYOU_6in_French_Door_Lock_Bolt.SLDPRT, MOSECYOU_6in_French_Door_Lock_Tongue.SLDPRT, P01-40-01-03_260727_Tailpin.SLDPRT, P01-80-01-01_260715_Bay_body.SLDPRT, P01-80-01-02_260715_Insulation_front.SLDPRT, P01-80-01-03_260715_Insulation_sides.SLDPRT]
2026-08-19 Cargo bay guide rails
    [P01-80-01-01_260715_Bay_body.SLDPRT, P01-80-01-02_260715_Insulation_front.SLDPRT, P01-80-01-07_260819_L-Profile.SLDPRT, P01-80-01_260715_Payload_bay.SLDASM]
2026-08-22 Payload rails to fuselage
    [AaCabinet_Door_Roller_Catch.SLDASM, AaCabinet_Door_Roller_Catch_Body.SLDPRT, AaCabinet_Door_Roller_Catch_Roller.SLDPRT, MOSECYOU_6in_French_Door_Lock.SLDASM, P01-80-01-01_260715_Bay_body.SLDPRT, P01-80-01-07_260819_L-Profile.SLDPRT, P01-80-01-07_260819_L-Profile_10x0.5.SLDPRT, P01-80-01-08_260822_L-Profile_10x2.SLDPRT]
2026-08-22 Cargo bay roller catches
    [AaCabinet_Door_Roller_Catch.SLDASM, P01-80-01-01_260715_Bay_body.SLDPRT, P01-80-01-02_260715_Insulation_front.SLDPRT, P01-80-01_260715_Payload_bay.SLDASM]
2026-08-23 updated wing sections with removed walls at the end of each section and updated wing engine cables hole position
    [P01-30-02-01_260724_Wing_Root_RH.SLDPRT, P01-30-02-02_260724_Wing_Section_RH.SLDPRT, P01-30-02-03_260724_Wing_Motor_Section_RH.SLDPRT, P01-30-02-04_260724_Wing_Servo_Section_RH.SLDPRT, P01-30-02-05_260724_Wing_Section_RH.SLDPRT, P01-30-02-06_260724_Wing_Section_RH.SLDPRT, P01-30-02-07_260724_Wing_Tip_RH.SLDPRT, P01-30-02-08_260724_Aileron_Root_RH.SLDPRT]
2026-08-24 Main Tilting Mechanism Cable Channels
    [P01-50-01-01_260726_Lower_Fairing_LH.SLDPRT, P01-50-01_260726_Main_Motor_LH.SLDASM, P01_260727_Main_Assembly.SLDASM]
2026-08-24 Tail Cable Channels
    [P01-40-01_260727_Tail_LH.SLDASM, P01-40-02-01_260727_Tailplane.SLDPRT, P01-40-02-01_260824_Tailplane.SLDPRT, P01-40-02_260727_Tail_RH.SLDASM, P01-50-03-01_260724_Lower_Fairing_LH.SLDPRT, P01-50-03_260724_Tail_Motor_LH.SLDASM, P01-50-04-01_260724_Lower_Fairing_RH.SLDPRT, P01-50-04-01_260824_Lower_Fairing_RH.SLDPRT]
2026-08-30 updated wing cable opening
    [P01-30-02-11_260807_NACA2412_3Dmodel_test_RH.SLDPRT]
2026-08-30 Revert "updated wing cable opening"
    This reverts commit 8166e34b78e475b7bb637da4c44e2691110aff0f.
    [P01-30-02-11_260807_NACA2412_3Dmodel_test_RH.SLDPRT]
2026-08-30 denser wing structure infill - a lot of components broke down - to be repaired
    [P01-30-02-01_260724_Wing_Root_RH.SLDPRT, P01-30-02-02_260724_Wing_Section_RH.SLDPRT, P01-30-02-03_260724_Wing_Motor_Section_RH.SLDPRT, P01-30-02-04_260724_Wing_Servo_Section_RH.SLDPRT, P01-30-02-05_260724_Wing_Section_RH.SLDPRT, P01-30-02-06_260724_Wing_Section_RH.SLDPRT, P01-30-02-07_260724_Wing_Tip_RH.SLDPRT, P01-30-02-08_260724_Aileron_Root_RH.SLDPRT]
2026-08-31 Updated RH Wing - still needs refinement
    [P01-30-02-11_260807_NACA2412_3Dmodel_test_RH.SLDPRT]
2026-09-04 updated wing assembly
    [P01-30-02-03_260724_Wing_Motor_Section_RH.SLDPRT, P01-30-02-04_260724_Wing_Servo_Section_RH.SLDPRT, P01-30-02-07_260724_Wing_Tip_RH.SLDPRT, P01-30-02-08_260724_Aileron_Root_RH.SLDPRT, P01-30-02-09_260724_Aileron_Middle_RH.SLDPRT, P01-30-02-10_260724_Aileron_Tip_RH.SLDPRT, P01-30-02-11_260807_NACA2412_3Dmodel_test_RH.SLDPRT]
2026-09-05 Wing Assembly updates - connection pins
    [P01-30-02-01_260724_Wing_Root_RH.SLDPRT, P01-30-02-02_260724_Wing_Section_RH.SLDPRT, P01-30-02-03_260724_Wing_Motor_Section_RH.SLDPRT, P01-30-02-04_260724_Wing_Servo_Section_RH.SLDPRT, P01-30-02-05_260724_Wing_Section_RH.SLDPRT, P01-30-02-06_260724_Wing_Section_RH.SLDPRT, P01-30-02-07_260724_Wing_Tip_RH.SLDPRT, P01-30-02-09_260724_Aileron_Middle_RH.SLDPRT]
2026-09-06 wing assy update
    [Dummy_model_5_60_shaft.SLDPRT, Dummy_model_servo_shaft_coupler.SLDPRT, P01-30-02-06_260724_Wing_Section_RH.SLDPRT, P01-30-02-07_260724_Wing_Tip_RH.SLDPRT, P01-30-02-08_260724_Aileron_Root_RH.SLDPRT, P01-30-02-10_260724_Aileron_Tip_RH.SLDPRT, P01-30-02_Wing_RH.SLDASM, P01-30-03_Servo_and_ShaftCoupler_ServoMount_Assembly.SLDASM]
2026-09-08 BOM updated
    [Table_260719_BOM.xlsx]
2026-09-09 updated wing assy - different wing separation of sections
    [P01-30-02-11_260807_NACA2412_3Dmodel_test_RH.SLDPRT, P01-30-02-12_260909_Wing_Section_After_Servo_RH.SLDPRT]
2026-09-11 Wing resized to fit the 3m wingspan
    [P01-30-02-01_260724_Wing_Root_RH.SLDPRT, P01-30-02-02_260724_Wing_Section_RH.SLDPRT, P01-30-02-03_260724_Wing_Motor_Section_RH.SLDPRT, P01-30-02-04_260724_Wing_Servo_Section_RH.SLDPRT, P01-30-02-05_260724_Wing_Section_RH.SLDPRT, P01-30-02-05_260909_Wing_Section_After_Servo_RH.SLDPRT, P01-30-02-06_260724_Wing_Section_RH.SLDPRT, P01-30-02-07_260724_Wing_Section_RH.SLDPRT]
2026-09-12 wing master file repaired after resizing
    [P01-30-02-12_260807_NACA2412_3Dmodel_test_RH.SLDPRT]
2026-09-13 RH wing 3d print feasibility after resizing - all sections redone
    [P01-30-02-01_260724_Wing_Root_RH.SLDPRT, P01-30-02-02_260724_Wing_Section_RH.SLDPRT, P01-30-02-03_260724_Wing_Motor_Section_RH.SLDPRT, P01-30-02-04_260724_Wing_Servo_Section_RH.SLDPRT, P01-30-02-05_260909_Wing_Section_After_Servo_RH.SLDPRT, P01-30-02-06_260724_Wing_Section_RH.SLDPRT, P01-30-02-07_260724_Wing_Section_RH.SLDPRT, P01-30-02-07_260724_Wing_Tip_RH.SLDPRT]
2026-09-18 New electronics links in BOM
    [Table_260719_BOM.xlsx]
2026-09-19 BOM Update - Adding 8A Ovonic
    [Table_260719_BOM.xlsx]
2026-09-20 wing assy - servo section update
    [P01-30-02-11_260807_NACA2412_3Dmodel_test_RH.SLDPRT]
2026-09-21 wing assy - ESC mount inside wing
    [P01-30-02-01_260724_Wing_Root_RH.SLDPRT, P01-30-02-02_260724_Wing_Section_RH.SLDPRT, P01-30-02-03_260724_Wing_Motor_Section_RH.SLDPRT, P01-30-02-04_260724_Wing_Servo_Section_RH.SLDPRT, P01-30-02-05_260909_Wing_Section_After_Servo_RH.SLDPRT, P01-30-02-06_260724_Wing_Section_RH.SLDPRT, P01-30-02-07_260724_Wing_Tip_RH.SLDPRT, P01-30-02-08_260724_Aileron_Root_RH.SLDPRT]
2026-09-22 BOM updated with servos and wing section ESC lid holder
    [P01-30-02-02_260724_Wing_Section_RH.SLDPRT, Table_260719_BOM.xlsx]
2026-09-22 wing assembly updated with latest components
    [20x18mm_CF_tube.SLDPRT, Dummy_model_5_60_shaft.SLDPRT, P01-30-02-02_260724_Wing_Section_RH.SLDPRT, P01-30-02-03_260724_Wing_Motor_Section_RH.SLDPRT, P01-30-02-08_260724_Aileron_Root_RH.SLDPRT, P01-30-02_Wing_RH.SLDASM, P01-30-03-01_260807_Servo_Mount.SLDPRT, P01-30-03_Servo_and_ShaftCoupler_ServoMount_Assembly.SLDASM]
2026-09-27 Added the fuselage with the current infill and ready for split
    [P01-20-01-01_260727_Fuselage_Infill.SLDPRT]
2026-09-27 Updated the name
    [P01-20-01-02_260727_Fuselage_Infill.SLDPRT]
2026-09-29 wing assembly - servo holder updated
    [P01-30-02-01_260724_Wing_Root_RH.SLDPRT, P01-30-02-02_260724_Wing_Section_RH.SLDPRT, P01-30-02-03_260724_Wing_Motor_Section_RH.SLDPRT, P01-30-02-04_260724_Wing_Servo_Section_RH.SLDPRT, P01-30-02-05_260909_Wing_Section_After_Servo_RH.SLDPRT, P01-30-02-06_260724_Wing_Section_RH.SLDPRT, P01-30-02-07_260724_Wing_Tip_RH.SLDPRT, P01-30-02-08_260724_Aileron_Root_RH.SLDPRT]
2026-09-29 Split Fuselage into sections for next connecting steps
    [P01-20-01-03_260929_S01_Nose_Whole.SLDPRT, P01-20-01-04_260929_S02_Upper.SLDPRT, P01-20-01-05_260929_S02_Bottom.SLDPRT, P01-20-01-06_260929_S02_Left.SLDPRT, P01-20-01-07_260929_S02_Right.SLDPRT, P01-20-01-08_260929_S03_Upper.SLDPRT, P01-20-01-09_260929_S04_Upper.SLDPRT, P01-20-01-10_260929_S05_Upper.SLDPRT]
2026-10-02 updated wing assy with servo lid holders
    [P01-30-02-03_260724_Wing_Motor_Section_RH.SLDPRT, P01-30-02_Wing_RH.SLDASM]
2026-10-03 created experimental Fuselage model with denser infill and 1.2mm walls
2026-10-03 Landing gear
    [P01-60-01-02_261003_FWD_Beam.SLDPRT, P01-60-01-02_261003_FWD_Fork.SLDPRT, P01-60-01-03_261003_FWD_Wheel.SLDPRT, P01-60-01-03_261003_Pin.SLDPRT, P01-60-01_261003_FWD_LG.SLDASM, P01-80-01-01_260715_Bay_body.SLDPRT, P01-80-01-09_261003_Bay_Beam.SLDPRT, P01-80-01_260715_Payload_bay.SLDASM]
2026-10-04 Updated Experimental fuselage
2026-10-04 V-tail parent file included in P01-40
    [P01-40-01-01_260727_Tailplane.SLDPRT, P01-40-02-01_260824_Tailplane.SLDPRT, P01-40-02-100_NACA0009_V-tail_parent_file.SLDPRT, P01-40-02_260727_Tail_RH.SLDASM]
2026-10-04 FWD LG Spring Simulations
    [HomeMax_Kolelo_Plastmasovo_80x30mm.SLDPRT, Leafpring_R125_t5_L150_w10.SLDPRT, Leafpring_R125_t5_L150_w10.STL, P01-60-01-01_261003_FWD_Beam.SLDPRT, P01-60-01-02_261003_FWD_Beam.SLDPRT, P01-60-01-02_261003_FWD_Fork.SLDPRT, P01-60-01_261003_FWD_LG.SLDASM, Spring_7X5_1t2_L150_w10.SLDPRT]
2026-10-04 updated tail parent file and sections
    [P01-40-02-01_260824_Tailplane.SLDPRT, P01-40-02-100_NACA0009_V-tail_parent_file.SLDPRT]
2026-10-07 Forward strut
    [HomeMax_Kolelo_Plastmasovo_80x30mm.SLDPRT, P01-60-01-01_261003_FWD_Beam.SLDPRT, P01-60-01-01_261007_Strut_FWD_RH.SLDPRT, P01-60-01-02_261003_FWD_Fork.SLDPRT, P01-60-01-03_261003_Pin.SLDPRT, P01-60-01_261003_FWD_LG.SLDASM, P01-80-01_260715_Payload_bay.SLDASM]
2026-10-09 Updated V-tail RH section
    [P01-40-02-01_260824_Tailplane.SLDPRT, P01-40-02-02_260824_Tailplane.SLDPRT, P01-40-02-03_260727_CF_Tube.SLDPRT, P01-40-02-03_260727_Tailpin.SLDPRT, P01-40-02-100_NACA0009_V-tail_parent_file.SLDPRT, P01-40-02_260727_Tail_RH.SLDASM, P01-40-04-01_260727_Lower_Elevon.SLDPRT, P01-40-04-02_260727_Upper_Elevon.SLDPRT]
2026-10-09 BOM update + invoices
    09/10/26
    [Table_260719_BOM.xlsx]
2026-10-09 Skid assembly
    [20x18mm_CF_tube.SLDPRT, Machine Screw M4 х 20mm.SLDPRT, Nut M4.SLDPRT, P01-40-02_260727_Tail_RH.SLDASM, P01-60-01-00_261008_Skids.SLDASM, P01-60-01-01_261007_Strut_FWD_RH.SLDPRT, P01-60-01-02_261009_Strut_FWD_LH.SLDPRT, P01-60-01-03_261009_Midbar.SLDPRT]
2026-10-09 Firewall edits
    [P01-80-01-09_261003_Firewall.SLDPRT, P01-80-01_260715_Payload_bay.SLDASM]
2026-10-10 V-tail 3d print of 1st section and optimization for printing
    [P01-40-02-01_260824_Tailplane.SLDPRT, P01-40-02-01_260824_Tailplane.STL, P01-40-02-02_260824_Tailplane.SLDPRT, P01-40-02-02_260824_Tailplane.STL, P01-40-02-100_NACA0009_V-tail_parent_file.SLDPRT, P01-40-02_260727_Tail_RH.SLDASM, P01-40-04-01_260727_Lower_Elevon.SLDPRT, P01-40-04-02_260727_Upper_Elevon.SLDPRT]
2026-10-10 Added RH aft strut for LG
    [P01-60-01-01_261007_Strut_FWD_RH.SLDPRT, P01-60-01-04_261010_Strut_Aft_RH.SLDPRT]
2026-10-10 Added invoices
    Transmitter + receiver + battery for transmitter
2026-10-11 Added Tube joint for LG Top and bottom, still have to be finished
2026-10-11 Added battery invoice
    Ampow order for Ovonic 6A5 batteries
2026-10-11 Tail motor lower fairing aileron hole position
2026-10-16 Adjusted tail lower fairing holes
2026-10-17 Added tube joints top and bot for left and right skid
2026-10-17 Payload bay to structure attachment
2026-10-19 Changed tube diameter from 22 to 20
2026-10-21 fuselage update
2026-10-22 Added parts to assembly
2026-10-23 Updated_experimental_fuselage with servo mount concept
2026-10-24 Configure Git LFS for CAD files
2026-10-25 updated wing RH parent file with denser infill
2026-10-25 updated wing tip!
2026-10-26 Avionics assembly
2026-10-28 recover RH wing updates
2026-10-28 Elevon - LH - copy from RH and RH wing parent file repair
2026-10-29 Wing Tip STL
2026-10-29 Aileron_update and STL
2026-10-31 Skid frame connection angle and hardware
2026-11-02 repaired RH wing parts
2026-11-04 updated RH wing assy
2026-11-06 Wing RH assy update
2026-11-11 updated RH Wing section
2026-11-12 Updated wing RH and fuselage skin
2026-11-13 fuselage and servo mount for elevons updated
2026-11-14 elevon servo mount updated inside wing skin
